TanzH1225/GrowTech-Wall-Handover/CAD library/README.md

# CAD library

The native CAD is included in this checkout. Keep these folders together:

- [Assembly](Assembly/): open [GTW003C.SLDASM](Assembly/GTW003C.SLDASM) for the full system.
- [FAB](FAB/): fabrication parts, print exports and electrical-box mounts/covers.
- [Standard](Standard/): standard and purchased components.

Use the [mechanical catalogue](../documentation/Mechanical%20catalog/Mechanical-CAD-Review.html) for previews, functions, materials and suppliers. The original `GTW003C.zip` is excluded from Git because its native contents are already arranged here.
