TanzH1225/GrowTech-Wall-Handover/documentation/programming/README.md

# Programming references

Start with [Current source selection and startup](Source-selection-and-startup.html), then [Programming handbook](PROGRAMMING-HANDBOOK.html).

- [01 system and code map](01-system-and-code-map.html)
- [02 pi application](02-pi-application.html)
- [03 communications](03-communications.html)
- [04 controller firmware](04-controller-firmware.html)
- [05 vision and assets](05-vision-and-assets.html)
- [06 development testing and recovery](06-development-testing-and-recovery.html)
- [07 maintenance and open issues](07-maintenance-and-open-issues.html)
- [08 evidence and change record](08-evidence-and-change-record.html)
- [09 hiwonder arm controller](09-hiwonder-arm-controller.html)

[Project report and asset context](10-reference-context-and-assets.html)
