TanzH1225/GrowTech-Wall-Handover/documentation/GrowTech-Wall-Electrical-RevJ.pdf

# GROWTECH WALL

# Connected power and control overview

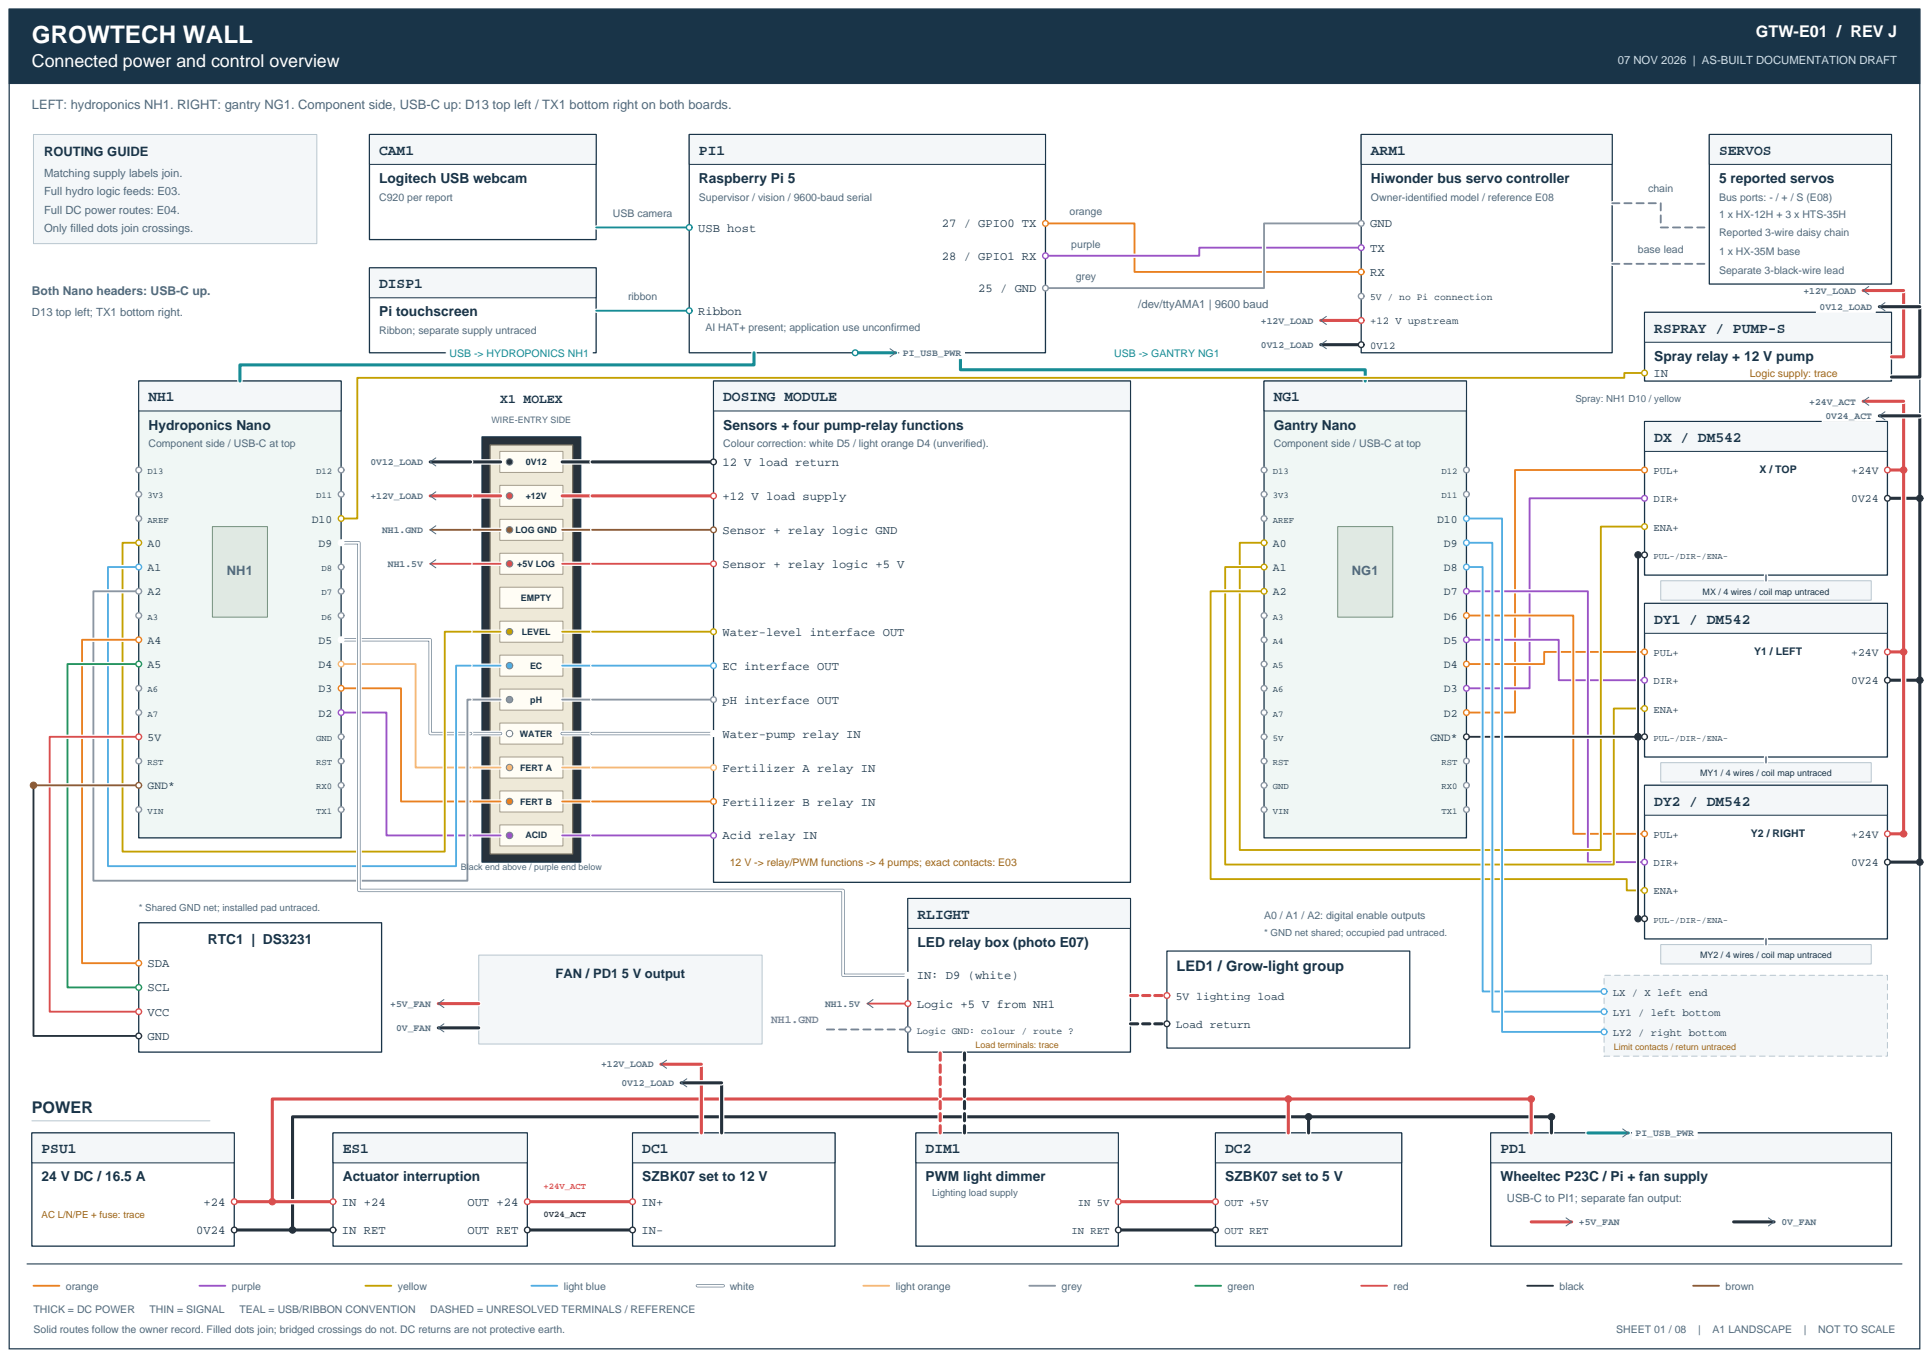
[picture p27: page 1]

07 NOV 2026 | AS-BUILT DOCUMENTATION DRAFT

LEFT: hydroponics NH1. RIGHT: gantry NG1. Component side, USB-C up: D13 top left / TX1 bottom right on both boards.

ROUTING GUIDE
Matching supply labels join.
Full hydro logic feeds: E03.
Full DC power routes: E04.
Only filled dots join crossings.

Raspberry Pi 5
Supervisor / vision / 9600-baud serial

ARM1
Hiwonder bus servo controller
Owner-identified model / reference E08

SERVOS
5 reported servos
Bus ports: - / + / S (E08)
1 x HX-12H + 3 x HTS-35H
Reported 3-wire daisy chain
1 x HX-35M base
Separate 3-black-wire lead

DISP1
Pi touchscreen
Ribbon; separate supply untraced

Both Nano headers: USB-C up.
D13 top left; TX1 bottom right.

Ribbon
AI HAT+ present; application use unconfirmed

Hydroponics Nano
Component side / USB-C at top

DOSING MODULE
Sensors + four pump-relay functions
Colour correction: white D5 / light orange D4 (unverified).
12 V load return

Gantry Nano

Sensor + relay logic GND

MX / 4 wires / coil map untraced

Water-level interface OUT

Water-pump relay IN

MY1 / 4 wires / coil map untraced

A0 / A1 / A2: digital enable outputs
* GND net shared; occupied pad untraced.

LED relay box (photo E07)

MY2 / 4 wires / coil map untraced

LX / X left end
LY1 / left bottom
LY2 / right bottom
Limit contacts / return untraced

Logic GND: colour / route ?

Wheeltec P23C / Pi + fan supply
USB-C to PI1; separate fan output:

AC L/N/PE + fuse: trace

THICK = DC POWER THIN = SIGNAL TEAL = USB/RIBBON CONVENTION DASHED = UNRESOLVED TERMINALS / REFERENCE

# Gantry motion, driver signals and limits

## GTW-E02 / REV J

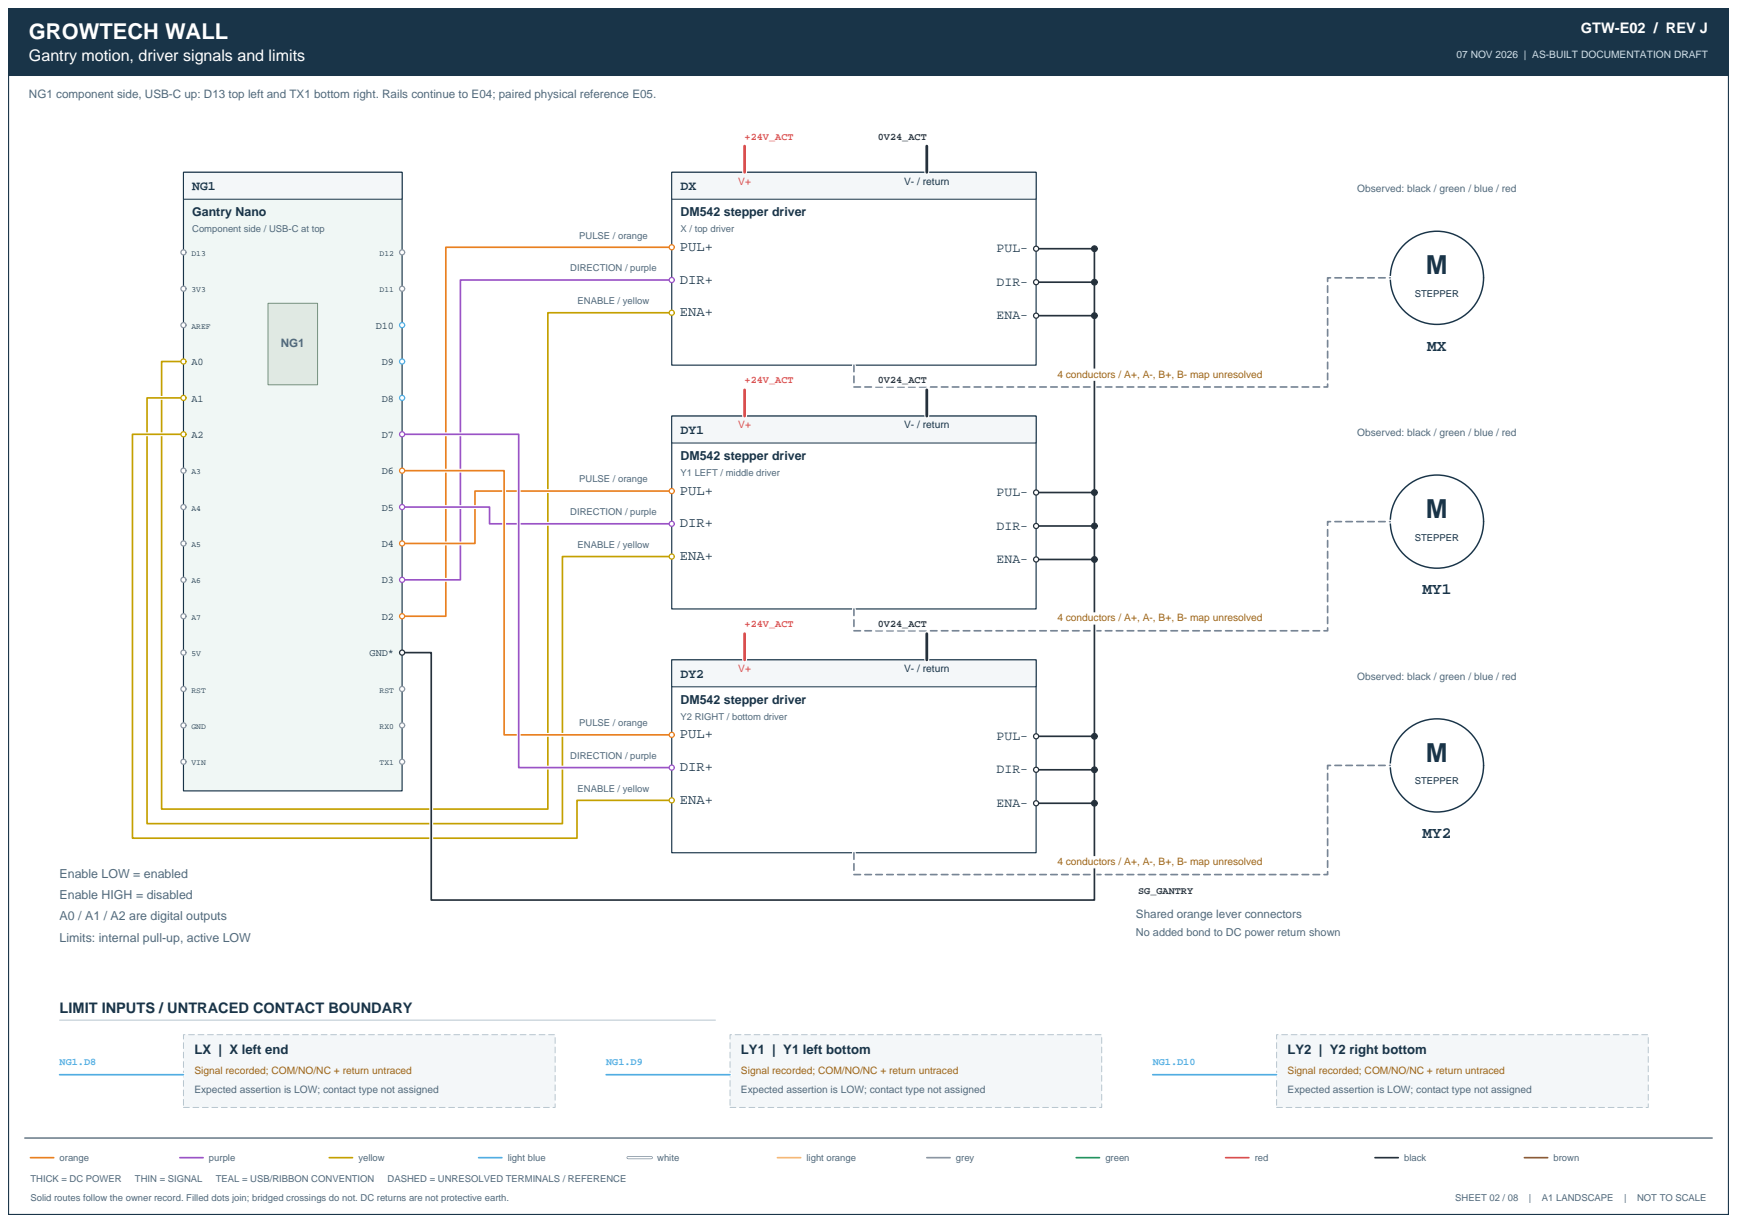
[picture p28: page 2]

NG1 component side, USB-C up: D13 top left and TX1 bottom right. Rails continue to E04; paired physical reference E05.

Gantry Nano
Component side / USB-C at top

Observed: black / green / blue / red

Enable LOW = enabled
Enable HIGH = disabled
A0 / A1 / A2 are digital outputs
Limits: internal pull-up, active LOW

SG_GANTRY
Shared orange lever connectors
No added bond to DC power return shown

LIMIT INPUTS / UNTRACED CONTACT BOUNDARY

Signal recorded; COM/NO/NC + return untraced
Expected assertion is LOW; contact type not assigned

# Molex wire-entry layout and hydroponics connections

## GTW-E03 / REV J

NH1: component side, USB-C up, real two-header pin order. Molex: photographed wire-entry order. Crossovers without dots are not joins.

Solid routes follow the owner record. Filled dots join; bridged crossings do not. DC returns are not protective earth. | SHEET 03 / 08 | A1 LANDSCAPE | NOT TO SCALE

NH1

## Hydroponics Nano

Component side / USB-C at top

D13

3V3

AREF

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
GND*

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
# X1 / MOLEX HARNESS

WIRE-ENTRY SIDE / BLACK END ABOVE

0V12

+12V

## LOG GND

## +5V LOG

## EMPTY

## LEVEL

EC

pH

## WATER

## FERT A

## FERT B

## ACID

### DOSING MODULE

## Sensor interfaces and four pump-relay functions

DC1 0V12 | Adopted D5 white / D4 light orange correction; physical continuity pending.
black / thick

### Load return / 0V12 distribution

DC1 +12V
red / thick

### +12 V load distribution to four pump paths

brown / thin

### Common sensor + RDOSE logic ground

red / thin

### Sensor + RDOSE logic +5 V supply

## NO WIRE

yellow

### Water-level interface analog OUT

light blue

### EC interface analog OUT

grey

### pH interface analog OUT

white

### Main water-pump relay IN / ON = LOW

light orange

### Fertilizer A relay IN / ON = HIGH

orange

### Fertilizer B relay IN / ON = HIGH

purple

### Acid relay IN / ON = HIGH

Both Nanos receive power over USB. A0 / A1 / A2 are analog inputs. * GND pads share a net; the occupied pad is untraced (E05).

The housing is shown from the wire-entry side; the mating face mirrors the row. Black heat-shrink in the photo is not treated as the conductor insulation colour. Exact sensor terminals and relay COM/NO/NC assignments remain untraced.

DIRECT FROM NH1: RTC1 on A4/SDA orange + A5/SCL green, with 5V red / GND black.
RLIGHT: D9 white, VCC from NH1 5V, logic-GND colour unresolved. RSPRAY: D10 yellow; logic supply / reference untraced.

## Fertilizer A / 12 V

### Kamoer peristaltic

Relay/load terminals to trace

M

+12V / 0V12 from X1

## Water pump / 12 V

### Rotary PWM + relay route

Relay/load terminals to trace

M

+12V / 0V12 from X1

## Fertilizer B / 12 V

### Kamoer peristaltic

Relay/load terminals to trace

M

+12V / 0V12 from X1

## Acid pump / 12 V

### Kamoer peristaltic

Relay/load terminals to trace

M

+12V / 0V12 from X1

# Power distribution, lighting and arm-box branches

## GTW-E04 / REV J

Supply and corresponding returns are paired. No unverified DC ground bond, protective-earth bond, fuse value or relay contact assignment is added.

Solid routes follow the owner record. Filled dots join; bridged crossings do not. DC returns are not protective earth. | SHEET 04 / 08 | A1 LANDSCAPE | NOT TO SCALE

### AC INPUT

## UK fused three-pin plug

Wall socket is normal main switch

### L / N / PE terminal map: trace Fuse rating / cable size: unknown

AC input

### PSU1

## 24 V x 16.5 A

396 W nominal output / report
+24 V

0V24

+24V_RAW

0V24_RAW

PD1

## Wheeltec P23C

Raw 24 V to Pi / fan supply

IN+ | IN return | DC2

## SZBK07 set to 5 V

Raw 24 V lighting load supply

IN+ | IN return | ES1

## Actuator interruption

Exact switched conductor(s): trace

IN+ | IN return

### ES1 REMOVES THE ACTUATOR BRANCH

Owner reports immediate vertical gantry descent on actuator-power removal. The Pi, both USB-powered Nanos, sensors and lighting remain powered. Twist release restores power; owner then uses GUI Reset for communications.

PI1

## Raspberry Pi 5

USB-C power input

PD1 USB-C -> PI1 / power only

### Reported output 5 V / 5 A

### FAN

## Enclosure fan load(s)

Quantity / header numbers not traced

### PD1 +5 V / matching return

PI1 USB host -> NG1 USB-C: power + data + ground. PI1 USB host -> NH1 USB-C: power + data + ground. PI1 USB host -> CAM1: camera data + USB power.
No additional VIN / 5V feed is recorded into either Nano.

### DIM1

## Grow-light PWM dimmer

Input / output terminals unresolved

+5V_LIGHT_LOAD

0V5_LIGHT_RETURN

### RLIGHT

## Lighting relay / control box

Load-side terminations unresolved

Known functional pair; switched side ?

### LED1

## Grow-light load group

Individual strip interconnect: trace NH1.5V -> VCC

NH1.5V

NH1.D9 -> IN (ON LOW)

NH1.D9

NH1.GND -> logic GND ?

NH1.GND

LED LOAD POWER IS FROM DC2. NH1 5V SUPPLIES RELAY LOGIC ONLY.

### ACTUATOR DISTRIBUTION

## Generic quick-connector block

+24V_ACT / 0V24_ACT -> DX / DY1 / DY2
Owner: 2-to-8 connector; exact terminal map unassigned

DC1

## SZBK07 set to 12 V

Input from actuator distribution

MOLEX +12V

MOLEX 0V12

## ARM-BOX 12 V BRANCH

Distribution -> Hiwonder ARM1 + spray load circuit.
ARM1 local switch effect on spray is unknown.
ARM1 input: 6-12 V rated; installed servo rail unmeasured.

# Physical header positions and connector identification

## GTW-E05 / REV J

Nano component side, USB-C at top. Nano footprint is a reference matching the owner count; verify the actual clone silkscreen before rewiring.

Solid routes follow the owner record. Filled dots join; bridged crossings do not. DC returns are not protective earth. | SHEET 05 / 08 | A1 LANDSCAPE | NOT TO SCALE

### BOTH NANOS: USB-C UP / D13 TOP LEFT / TX1 BOTTOM RIGHT

NH1 / HYDROPONICS | NG1 / GANTRY | PI1 / 40-PIN HEADER

### USB-C

NG1

MCU

- D13
- 3V3
- AREF
DX ENA+ | A0
DY1 ENA+ | A1
DY2 ENA+ | A2
- A3
- A4
- A5
- A6
- A7
- 5V
- RST
- GND
- VIN
D12 | -
D11 | -
D10 | LY2 signal
D9 | LY1 signal
D8 | LX signal
D7 | DY2 DIR+
D6 | DY2 PUL+
D5 | DY1 DIR+
D4 | DY1 PUL+
D3 | DX DIR+
D2 | DX PUL+
GND | SG_GANTRY*
RST | -
RX0 | -
TX1 | -

COMPONENT SIDE

### USB-C

NH1

MCU

- D13
- 3V3
- AREF
Level signal | A0
EC signal | A1
pH signal | A2
- A3
RTC1 SDA | A4
RTC1 SCL | A5
- A6
- A7
Logic +5V* | 5V
- RST
Logic GND* | GND
- VIN
D12 | -
D11 | -
D10 | RSPRAY IN
D9 | RLIGHT IN
D8 | -
D7 | -
D6 | -
D5 | Water relay IN
D4 | Fert A relay IN
D3 | Fert B relay IN
D2 | Acid relay IN
GND | -
RST | -
RX0 | -
TX1 | -

COMPONENT SIDE

* GND pins share the same board net. The occupied header pad is untraced.
The drawing pin names are electrical identifiers; unlabelled pins have no recorded wire. The USB-C-equipped clones are not identified as official Arduino A000005 hardware.

* NH1 5V -> X1.+5V, RTC1 VCC and RLIGHT VCC.
X1.GND is brown; RTC1 return is black; RLIGHT return colour is unknown. Both on-board GND pads are equivalent; the specific installed pad is untraced. D5 white / D4 light orange: adopted colour correction, unverified.
3V3 | 1 | 2 | 5V
GPIO2 | 3 | 4 | 5V
GPIO3 | 5 | 6 | GND
GPIO4 | 7 | 8 | GPIO14
GND | 9 | 10 | GPIO15
GPIO17 | 11 | 12 | GPIO18
GPIO27 | 13 | 14 | GND
GPIO22 | 15 | 16 | GPIO23
3V3 | 17 | 18 | GPIO24
GPIO10 | 19 | 20 | GND
GPIO9 | 21 | 22 | GPIO25
GPIO11 | 23 | 24 | GPIO8
GND | 25 | 26 | GPIO7
GPIO0 | 27 | 28 | GPIO1
GPIO5 | 29 | 30 | GND
GPIO6 | 31 | 32 | GPIO12
GPIO13 | 33 | 34 | GND
GPIO19 | 35 | 36 | GPIO16
GPIO26 | 37 | 38 | GPIO20
GND | 39 | 40 | GPIO21

Mating header view / pin 1 at upper left

25 GND | -> ARM1 GND | grey
27 GPIO0 TX -> ARM1 RX | orange
28 GPIO1 RX <- ARM1 TX | purple

UART1 alternate function supported by RP1. Owner port: /dev/ttyAMA1 at 9600 baud.
Pi logic is 3.3 V; ARM1 TX voltage unverified.

## X1 / MOLEX WIRE-ENTRY SEQUENCE (BLACK END LEFT, PURPLE END RIGHT)

0V12 | +12V | LOG GND | +5V LOG | EMPTY | LEVEL | EC | pH | WATER | FERT A | FERT B | ACID

Same single row as E03, rotated for readability. Photo E07 anchors the wire-entry view; use function labels on this side.

# Connection schedule, evidence limits and verification register

## GTW-E06 / REV J

Use this sheet with E01-E05. The separate CSV contains the complete recorded connection schedule and endpoint names.

Solid routes follow the owner record. Filled dots join; bridged crossings do not. DC returns are not protective earth. | SHEET 06 / 08 | A1 LANDSCAPE | NOT TO SCALE

## SIGNAL SCHEDULE / DIRECT LINKS

SOURCE | DESTINATION | WIRE / FUNCTION
PI1 USB host | NG1 USB-C | Power + data + GND / gantry
PI1 USB host | NH1 USB-C | Power + data + GND / hydroponics
PI1 USB host | CAM1 USB | Camera data + USB power
PI1 ribbon | DISP1 | Ribbon link / power route untraced
PI1 pin 27 / GPIO0 TX | ARM1 RX | Orange / UART1
PI1 pin 28 / GPIO1 RX | ARM1 TX | Purple / UART1
PI1 pin 25 | ARM1 GND | Grey / UART reference
NH1 A4 / SDA | RTC1 SDA | Orange / I2C
NH1 A5 / SCL | RTC1 SCL | Green / I2C
NH1 5V / GND | RTC1 VCC / GND | Red / black
NH1 5V | RLIGHT VCC | Red supply callout / latest correction
NH1 D9 | RLIGHT IN | White / firmware ON LOW
NH1 GND | RLIGHT logic GND | Return colour + termination unresolved
NH1 D10 | RSPRAY IN | Yellow / firmware ON HIGH

## TERMINAL VERIFICATION REGISTER

## V01 AC INPUT / EARTH

PSU model; L/N/PE; plug fuse; cable size; protective-earth path.

## V02 ES1 POWER INTERRUPTION

Identify switched conductor(s), poles and actual contact terminals.

## V03 DM542 / MOTORS

Match installed variant, coil pairs, A+/A-/B+/B- and DIP orientation.

## V04 LIMIT SWITCHES

Identify actual signal contact, COM/NO/NC selection and return route.

## V05 X1 CONNECTOR

D5 white / D4 light orange is an adopted hypothesis; confirm continuity and mating orientation.

## V06 DOSING CONTACTS / PWM

Trace relay load contacts and main-pump PWM terminal sequence.

## V07 LIGHTING LOAD / LOGIC

Trace DIM1 / RLIGHT contacts, return switching and logic-GND wire.

## V08 ARM UART / SERVOS

Hiwonder controller identified; verify TX level, servo rail, occupied sockets, IDs and chain order.

## V09 SPRAY SWITCHING

Identify logic VCC / GND and pump contact path; switch interaction.

## V10 SENSOR / PERIPHERAL DETAILS

Sensor interface models; fan terminals / count; touchscreen power.

### HOW TO READ THIS SET

A filled junction dot joins conductors; crossings with white bridges are not joins.
Dashed boundaries retain known functional routes without inventing hidden terminals.
Every repeated net name on a detail sheet identifies the same electrical net.
Power-return and signal-ground names remain distinct unless the supplied evidence joins them. No fresh hardware continuity tests or live firmware checks were performed.

### DRAWING BASIS

Primary evidence: attached GrowTech-Wall-Schematic-Drawing-Brief.md (03 Nov 2026).
New owner photos: LED relay box, single-row Molex connector and robotic arm control box.
Rev J: ARM1 identified as Hiwonder Serial Bus Servo Controller; physical reference added on E08. External box identities confirmed by owner; obscured internal terminals remain unresolved. MANUFACTURER REFERENCE CHECKS
[1] Arduino Nano full pinout, A000005, p.1: standard 30-pin signal-name order.
https://docs.arduino.cc/resources/pinouts/A000005-full-pinout.pdf
[2] Raspberry Pi RP1 Peripherals, Table 4, printed p.15: GPIO0/1 UART1 TX/RX. https://datasheets.raspberrypi.com/rp1/rp1-peripherals.pdf
[3] Raspberry Pi hardware / configuration documentation: header numbering; 3.3 V UART. https://www.raspberrypi.com/documentation/computers/raspberry-pi.html

References establish pin capabilities, not hidden wiring on this prototype. Hiwonder controller references and photo pin order: E08.

# Photo-matched field components and connector reference

## GTW-E07 / REV J

Owner identifications: first photo = LED relay box; second = Molex connector; third = robotic arm control box. Photos are reference evidence.

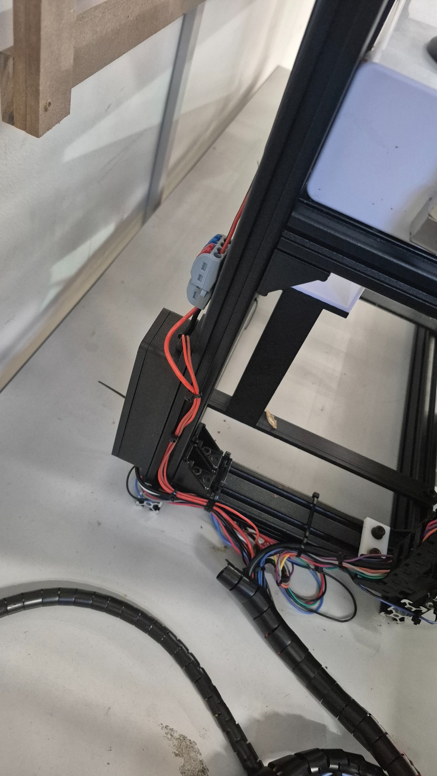
[picture p29: figure]
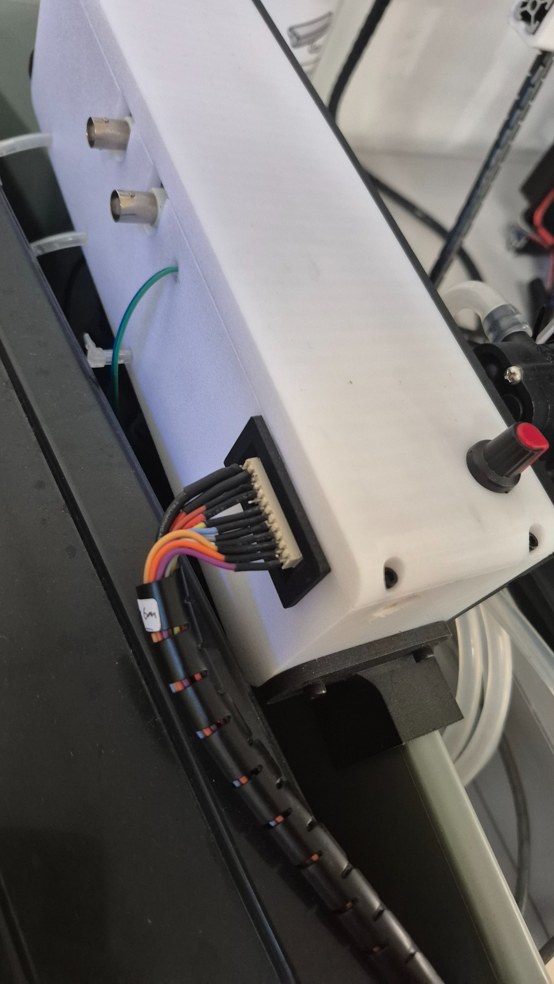
[picture p30: figure]
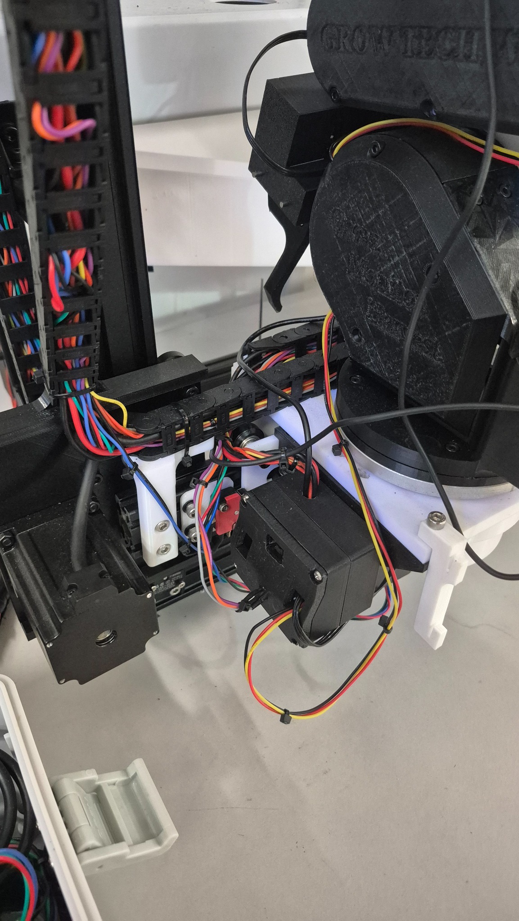
[picture p31: figure]
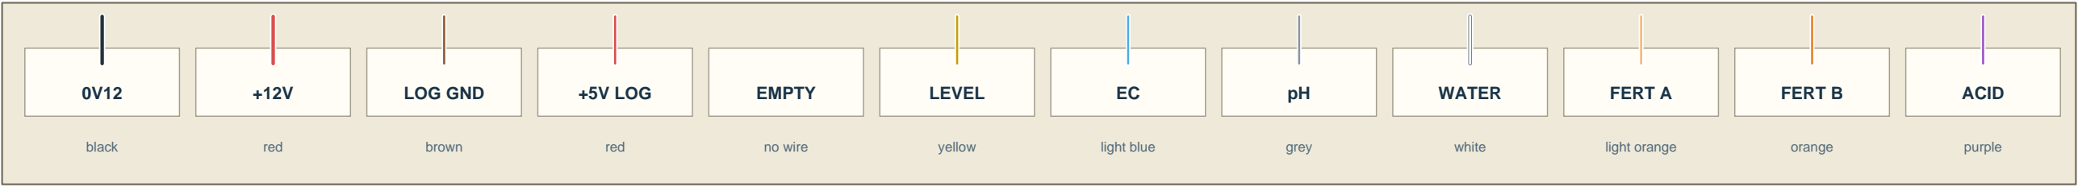
[picture p32: figure]
black; red; LOG GND; brown; +5V LOG; EMPTY; no wire; LEVEL; yellow; light blue; grey; WATER; white; FERT A; light orange; FERT B; orange; ACID; purple

Solid routes follow the owner record. Filled dots join; bridged crossings do not. DC returns are not protective earth. | SHEET 07 / 08 | A1 LANDSCAPE | NOT TO SCALE

# LED RELAY BOX

Black enclosure mounted behind the frame. Load leads and control harness enter the box. Internal contacts / logic return remain obscured.

# MOLEX CONNECTOR

Single row of wire entries on the dosing box. Black return end -> purple acid-signal end. Heat-shrink covers parts of individual wires.

# ROBOTIC ARM CONTROL BOX

Black enclosure beside the arm base.
External red local switch and lead groups visible. ARM1 model identified separately; board view E08.

# MOLEX: SINGLE ROW, WIRE-ENTRY SIDE, ROTATED HORIZONTALLY FOR READING

Wire-entry view: black return end to purple acid end. White D5 / light orange D4 mapping is adopted provisionally.

# ARM1 identification and physical communication header

## GTW-E08 / REV J

Owner-identified Hiwonder Serial Bus Servo Controller. Component-side reference photo; micro-USB at top and power switch at bottom.

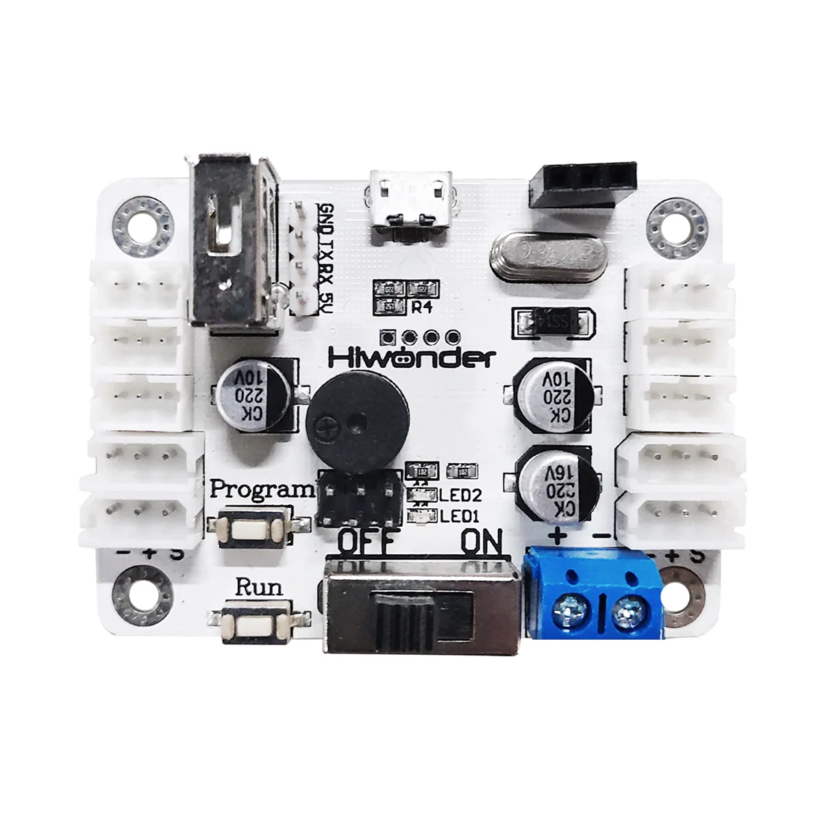
[picture p33: figure]
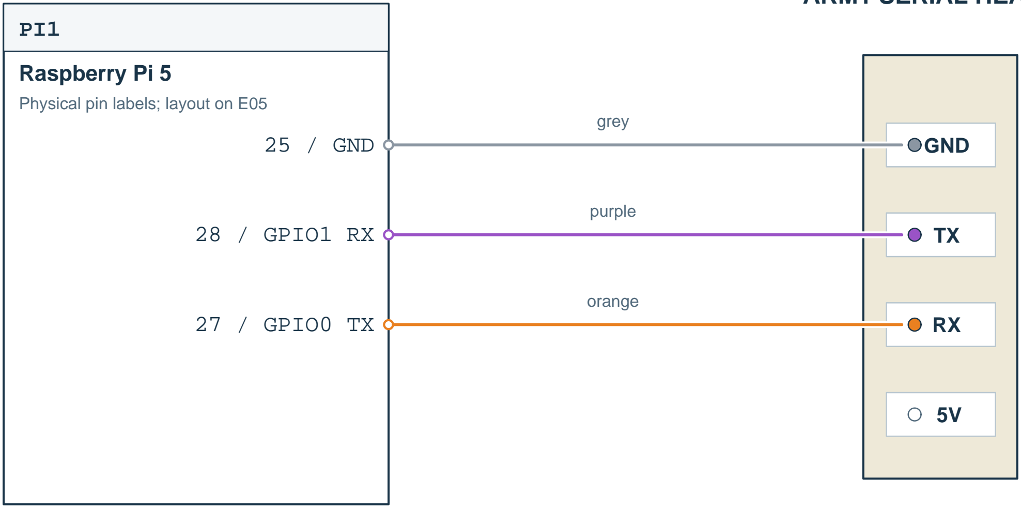
[picture p34: figure]
Raspberry Pi 5; Physical pin labels; layout on E05; 25 / GND; grey; 28 / GPIO1 RX; purple; 27 / GPIO0 TX; orange

Solid routes follow the owner record. Filled dots join; bridged crossings do not. DC returns are not protective earth. | SHEET 08 / 08 | A1 LANDSCAPE | NOT TO SCALE

## SUPPLIED BOARD REFERENCE / ARM1

The product photo identifies the board; it does not show the installed harness.

## UART CONNECTION / 9600 BAUD

## Serial header order in the supplied photo, from top to bottom:

GND / TX / RX / 5V. TX and RX are named from the controller perspective.

## ARM1 SERIAL HEADER

GND | UART reference
TX | Controller transmits to Pi RX
RX | Controller receives from Pi TX
5V | 5V auxiliary pin
| No connection to Pi in this set

The host UART is distinct from the three-wire servo bus.
Keep the recorded Pi GPIO0 / GPIO1 assignment; no GPIO remapping is implied.
Hiwonder documents a Raspberry Pi serial connection. Installed TX voltage has not been measured.

## MAIN POWER TERMINAL / PHOTO ORIENTATION

+ | -

### DC1 +12V_LOAD

### DC1 0V12_LOAD

Left screw = +; right screw = - in this view. Manufacturer input range: 6-12 V.
Recorded DC1 branch: 12 V.
Select supply voltage to suit the connected servos. This is separate from the serial-header 5V pin.

### SERVO CONNECTIONS / WHAT IS NOW IDENTIFIED

Visible three-pin port marking: - / + / S (signal), left to right in this component-side photo. The recorded four-servo chain and separate base lead remain unchanged.
Installed socket choice, servo-ID order and cable-contact mapping still require tracing.

## REFERENCES / OWNER IMAGE + HIWONDER DOCUMENTATION

[4] Product: Serial Bus Servo Controller, SKU 21090003. https://www.hiwonder.com/products/serial-bus-servo-controller
[5] Bus Servo Controller User Manual, sections 1.2.1-1.2.2.
[6] Bus Servo Controller Secondary Development, sections 2.1 and 2.5. Official manual and development URLs are included in the editable package. Reference pin capabilities do not establish hidden wiring inside the arm box.
