TanzH1225/GrowTech-Wall-Handover/documentation/Electrical catalog/media/01-connector-detail-embedded.jpg

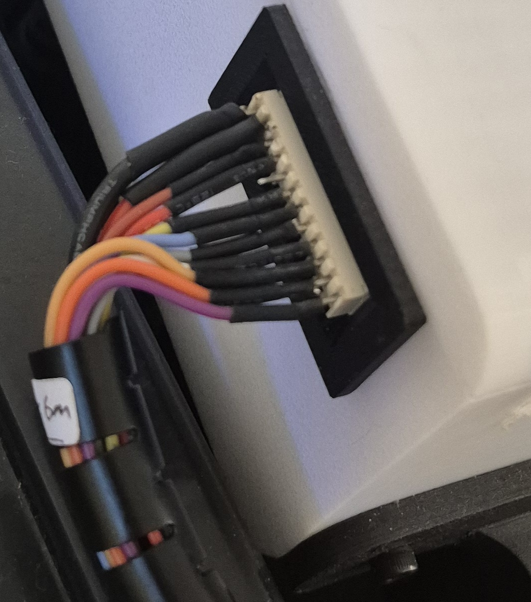
documentation/Electrical catalog/media/01-connector-detail-embedded.jpg
