TanzH1225/GrowTech-Wall-Handover/documentation/Electrical catalog/media/05-driver-terminal-detail-embedded.jpg

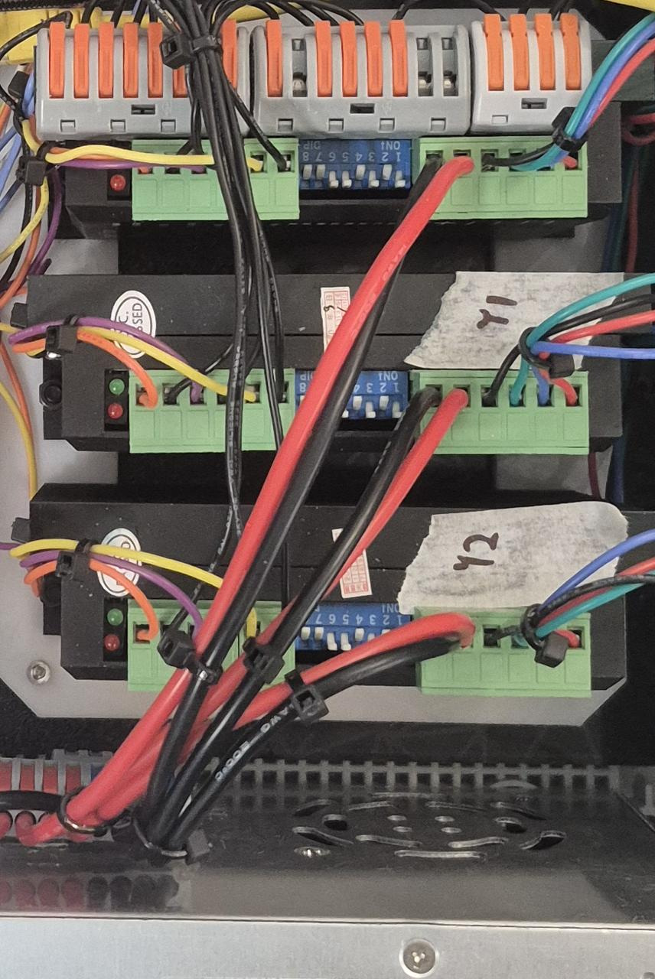
documentation/Electrical catalog/media/05-driver-terminal-detail-embedded.jpg
