TanzH1225/GrowTech-Wall-Handover/documentation/Electrical catalog/media/05-enclosure-interior-embedded.jpg

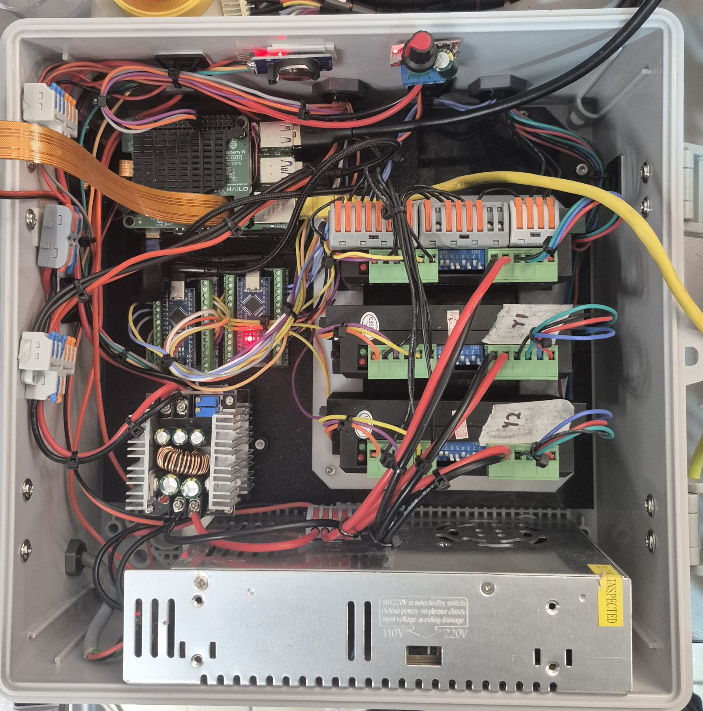
documentation/Electrical catalog/media/05-enclosure-interior-embedded.jpg
