TanzH1225/GrowTech-Wall-Handover/documentation/Electrical catalog/media/05-nano-detail.jpg

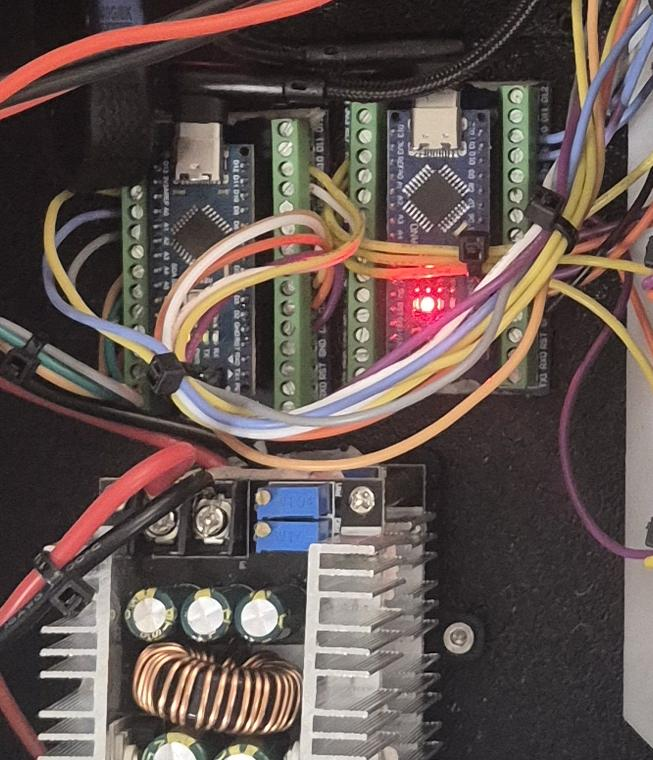
documentation/Electrical catalog/media/05-nano-detail.jpg
