TanzH1225/GrowTech-Wall-Handover/documentation/Electrical catalog/media/07-report-dosing-electronics.png

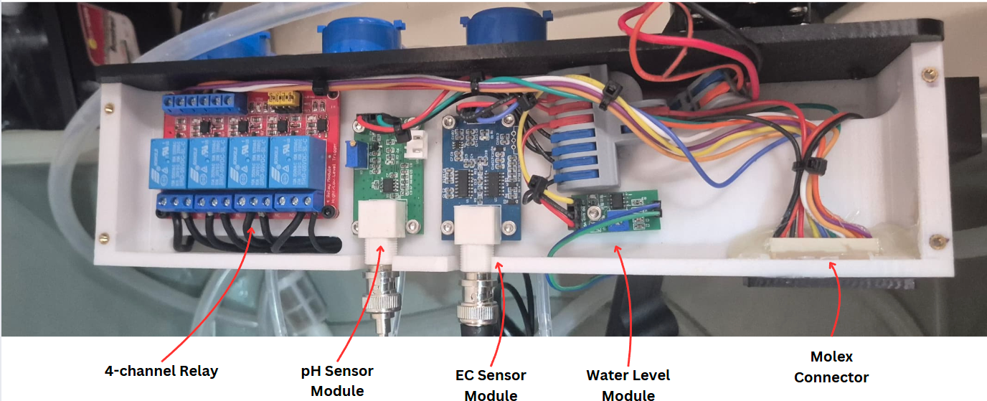
documentation/Electrical catalog/media/07-report-dosing-electronics.png
