TanzH1225/GrowTech-Wall-Handover/documentation/Electrical catalog/media/RevJ-E06.png

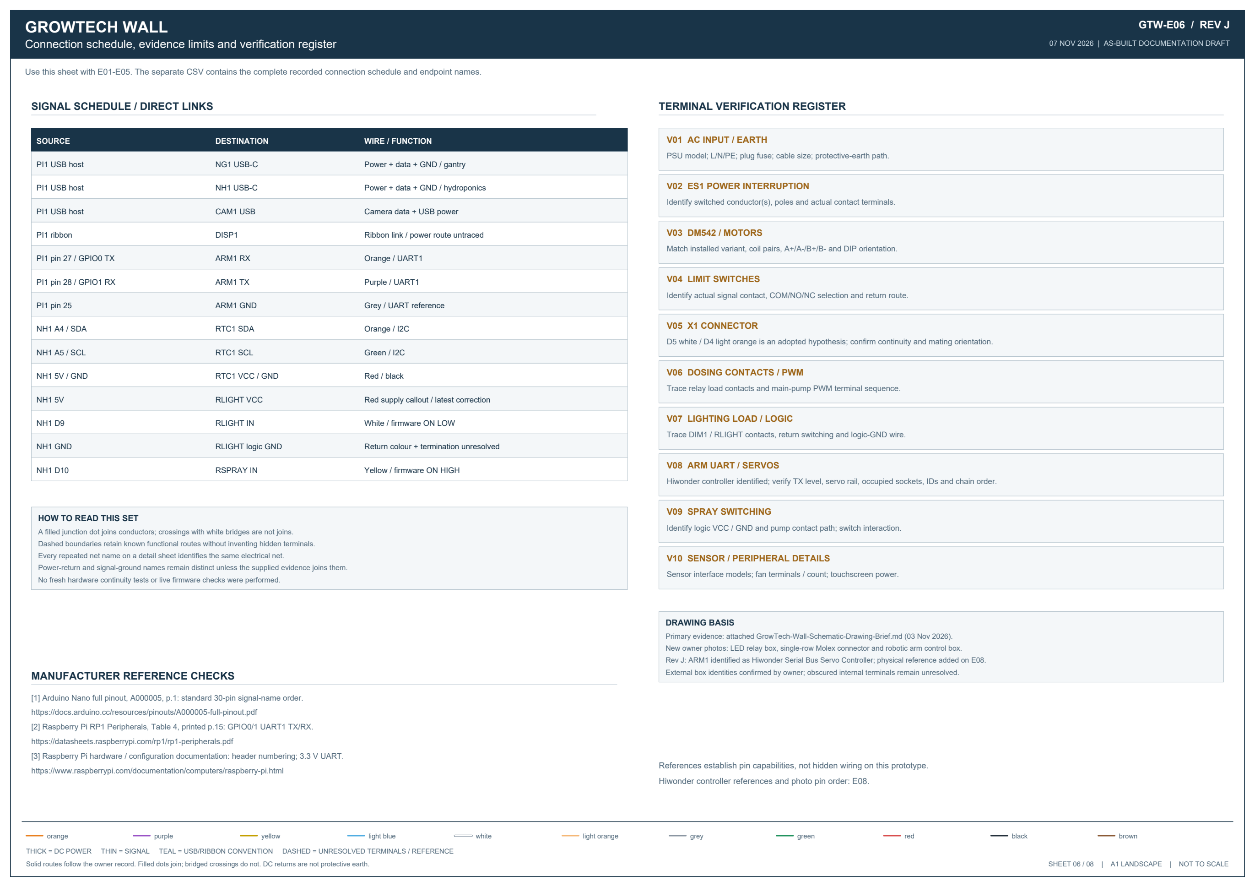
documentation/Electrical catalog/media/RevJ-E06.png
