TanzH1225/GrowTech-Wall-Handover/documentation/Manufacturer references/arduino-nano-pinout-reference.png

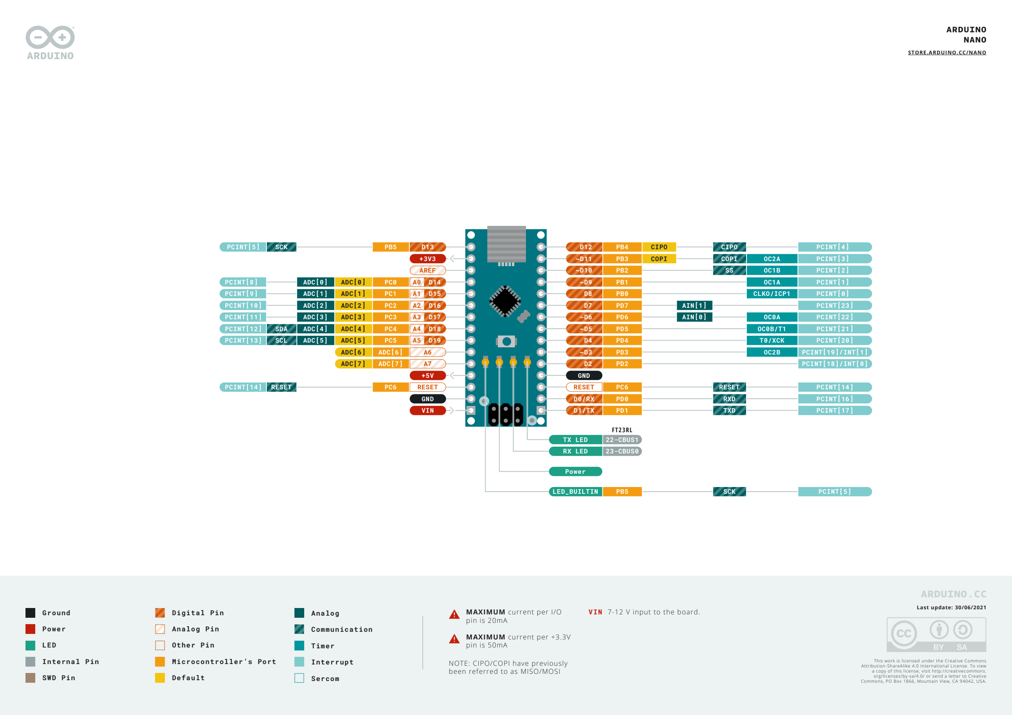
documentation/Manufacturer references/arduino-nano-pinout-reference.png
