TanzH1225/GrowTech-Wall-Handover/documentation/programming/media/dashboard.png

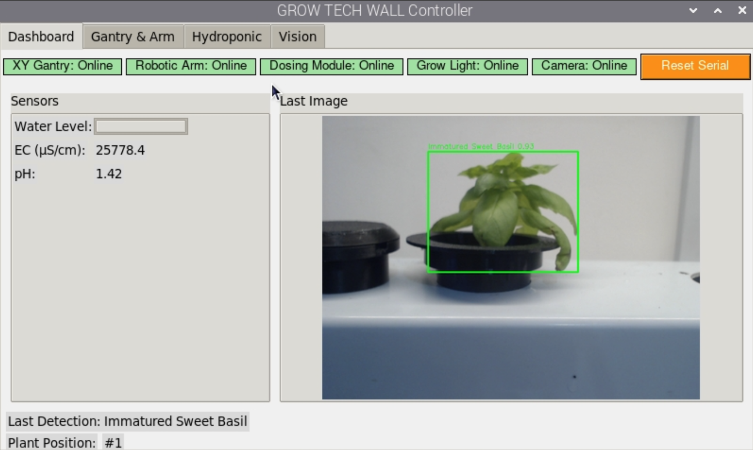
documentation/programming/media/dashboard.png
