TanzH1225/GrowTech-Wall-Handover/documentation/programming/media/example-detections.jpg

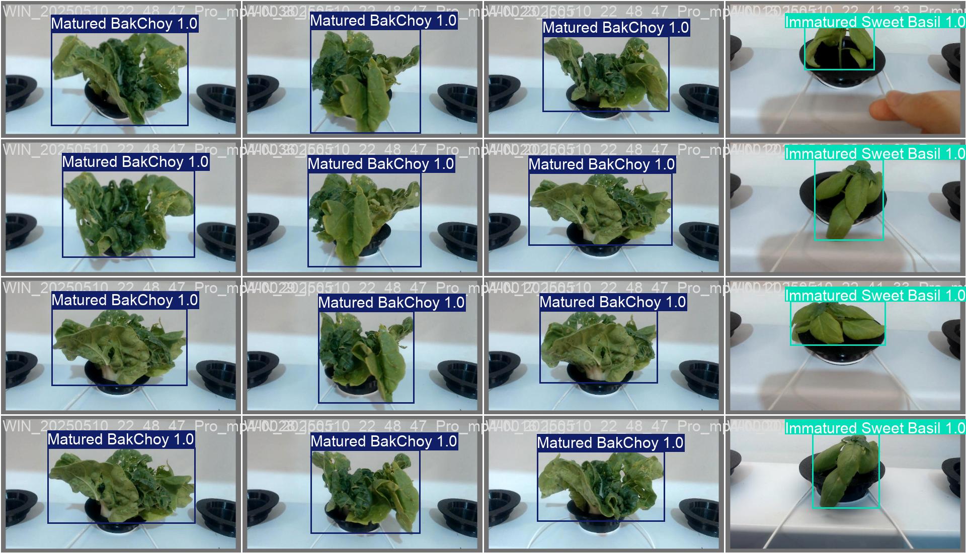
documentation/programming/media/example-detections.jpg
