TanzH1225/GrowTech-Wall-Handover/documentation/programming/media/gantry-arm-interface.png

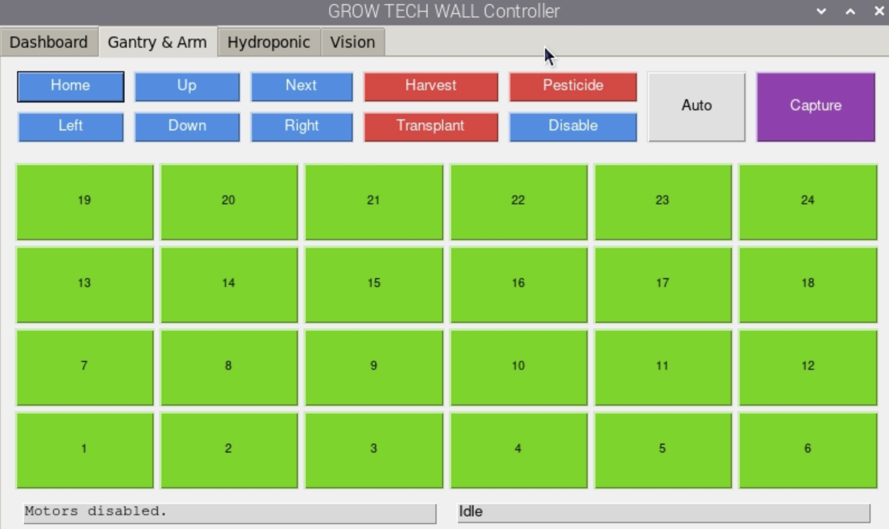
documentation/programming/media/gantry-arm-interface.png
