TanzH1225/GrowTech-Wall-Handover/documentation/programming/media/hydroponics-interface.png

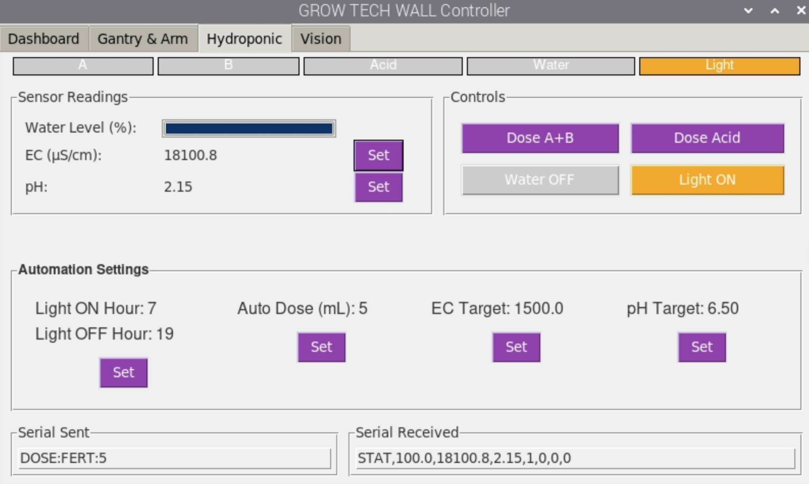
documentation/programming/media/hydroponics-interface.png
