TanzH1225/GrowTech-Wall-Handover/documentation/programming/media/vision-interface.png

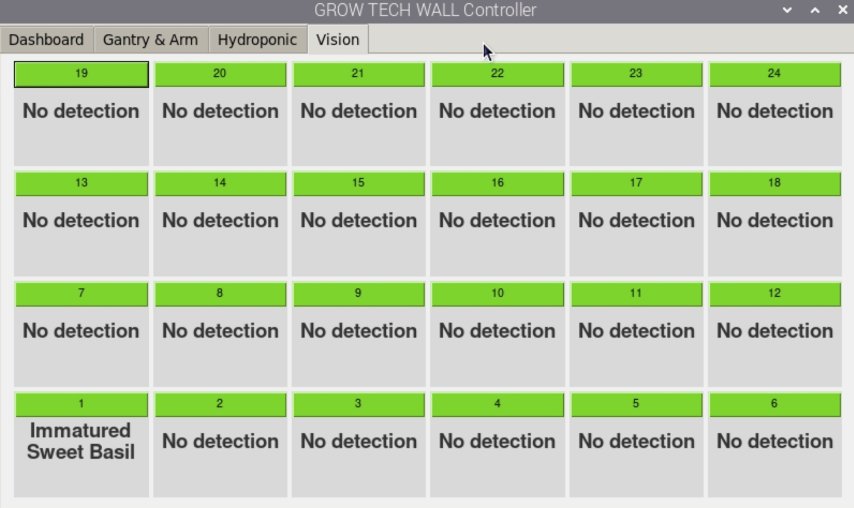
documentation/programming/media/vision-interface.png
