TanzH1225/GrowTech-Wall-Handover/documentation/reference/Pack and Go/pack-and-go-3.png

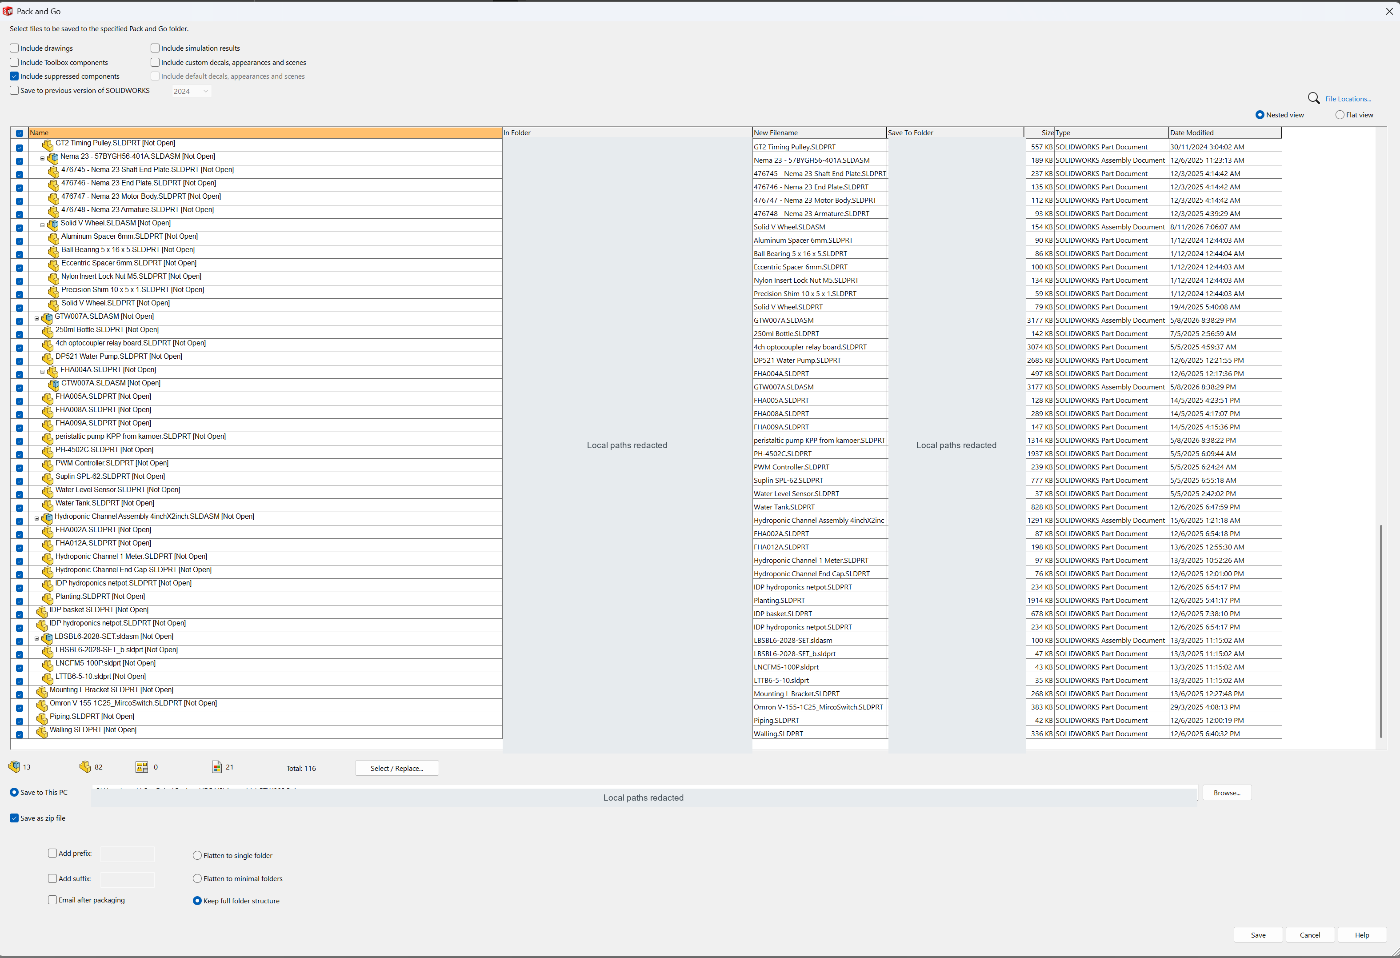
documentation/reference/Pack and Go/pack-and-go-3.png
