TanzH1225/GrowTech-Wall-Handover/documentation/GrowTech-Wall-BOM-Rechecked.xlsx

Sheet: BOM
GROWTECH WALL — BILL OF MATERIALS
Latest revisions. * Name inferred from CAD. Functions are CAD interpretations; see Assembly guide.
28 V-wheel bodies included. Unresolved included references: 0.
Gantry parts
No. | Part / CAD ref. | Description | Qty. | Material | Function / specification
1 | FGA001C | Gantry Plate Mirror | 2 | Acrylic (Medium-high impact) | Carries the gantry mounting and wheel interfaces.
2 | FGA002A | Gantry rail* | 1 | 5052-H34 | Long extruded member providing the linear guide path.
3 | FGA004A | X Limit Switch Plate | 3 | — | Positions the endstop switch relative to the moving carriage.
4 | FGA012A | X Plate1 | 2 | Acrylic (Medium-high impact) | Connects the X carriage drive and roller mounting points.
5 | FGA013B | Platform Truss | 2 | — | Braces the projecting arm platform against bending.
6 | FGA015B | Platform Support | 2 | — | Connects and supports the arm platform.
7 | FGA016A | 4.5mm Spacer | 8 | — | Maintains spacing in the gantry mounting stack.
8 | FGA017A | 9mm Spacer | 4 | — | Maintains spacing in the gantry mounting stack.
9 | FGA018A | 23mm Spacer | 2 | — | Maintains spacing in the gantry mounting stack.
10 | FGA019A | X Chain Bracket | 1 | — | Anchors the moving cable-chain connection.
11 | FGA021B | Basket Hook | 1 | — | Supports the collection basket on the moving structure.
12 | FGA022A | Basket Hook | 1 | — | Supports the collection basket on the moving structure.
13 | FGA023F | Damper | 2 | — | Two-hole mounting block; damping mechanism/material needs confirmation.
14 | FRAM001D | Aluminium Frame | 1 | 5052-H36 | Supports the growing channels and gantry structure.
Robotic arm parts
No. | Part / CAD ref. | Description | Qty. | Material | Function / specification
15 | FRA001C | Arm / platform mounting plate* | 2 | — | Interfaces the rotary arm base with its supporting platform; also used on the X assembly.
16 | FRA002B | Rotary base plate* | 1 | 6061 Alloy | Circular mounting interface for the arm base rotation.
17 | FRA003C | Arm joint housing* | 1 | — | Supports the first joint and its actuator interface.
18 | FRA004B | Arm link housing* | 1 | 6061 Alloy | Structural housing connecting adjacent arm joints.
19 | FRA005D | Arm 2 | 1 | — | Second arm link housing between joints.
20 | FRA010A | End-effector actuator housing* | 1 | 6061 Alloy | Carries the gripper actuator and rotary mounting interface.
21 | FRA013A | Gripper pinion* | 1 | — | Transfers actuator rotation into rack travel.
22 | FRA014A | Rack | 1 | — | Transfers pinion motion to one finger mounting interface.
23 | FRA015B | Rack | 1 | — | Transfers pinion motion to the opposing finger mounting interface.
24 | FRA017C | Gripper Finger A | 1 | — | One curved opposing finger connected to a gripper rack.
25 | FRA018C | Gripper Finger B | 1 | — | The opposing curved finger connected to the other gripper rack.
26 | FRA019A | Control Box | 2 | — | Small control enclosure with mounting/access openings.
Hydroponics parts
No. | Part / CAD ref. | Description | Qty. | Material | Function / specification
27 | FHA002A | Cup | 34 | — | Ring-shaped interface locating a plant cup in a channel opening.
28 | FHA003B | Slide V2 | 1 | — | Angled transfer chute with supporting rods; exact transfer sequence needs confirmation.
29 | FHA004A | Dosing Module | 1 | — | Housing for the tank-mounted dosing components.
30 | FHA005A | Tank mounting bracket* | 1 | — | Clips over an edge and provides a two-hole mounting interface.
31 | FHA008A | Bottle Holder | 1 | — | Retains the dosing bottles beside the tank.
32 | FHA009A | Sensors Holder | 1 | — | Positions cylindrical probes beside/in the tank.
33 | FHA012A | LID | 8 | — | Caps unused channel openings.
Standard components
No. | Part / CAD ref. | Description | Qty. | Material | Function / specification
34 | — | socket countersunk head screw | 4 | — | B18.3.5M - 4 x 0.7 x 12 Socket FCHS -- 12N
35 | — | socket countersunk head screw | 4 | — | B18.3.5M - 4 x 0.7 x 20 Socket FCHS -- 20N
36 | — | socket head cap screw | 4 | — | B18.3.1M - 4 x 0.7 x 30 Hex SHCS -- 30NHX
37 | — | socket head cap screw | 24 | — | B18.3.1M - 5 x 0.8 x 35 Hex SHCS -- 22NHX
38 | — | socket head cap screw | 7 | — | B18.3.1M - 5 x 0.8 x 40 Hex SHCS -- 22NHX
39 | — | socket head cap screw | 7 | — | B18.3.1M - 5 x 0.8 x 50 Hex SHCS -- 22NHX
40 | — | hex nut style 1 | 24 | — | B18.2.4.1M - Hex nut, Style 1, M5 x 0.8 --D-N
41 | — | 625 2RS Ball Bearing, ABEC 1. | 56 | Plain Carbon Steel | —
42 | — | Solid V-wheel body | 28 | Delrin 2700 NC010, Low Viscosity Acetal Copolymer (SS) | Rolling wheel body; bearings are listed separately.
43 | — | 250ml Bottle | 3 | — | —
44 | — | 3mmX80mm shaft | 2 | — | —
45 | — | 4ch optocoupler relay board | 1 | — | —
46 | — | 6mm pneumatic fittings | 1 | — | —
47 | — | Aluminium Round Spacer | 29 | 5052-H34 | —
48 | — | C920 Webcam | 1 | — | —
49 | — | DP521 Water Pump | 1 | PVC Rigid | —
50 | — | Electrical Panel Box | 1 | — | —
51 | — | GT2 Timing Pulley | 3 | 6063-T1 | —
52 | — | 240 Servo Motor HTS-35H | 3 | — | —
53 | — | 0 DS-LH8A stp(2) | 1 | — | —
54 | — | Hydroponic Channel 1 Meter | 4 | PVC Rigid | —
55 | — | Hydroponic Channel End Cap | 8 | PVC Rigid | —
56 | — | IDP basket | 1 | — | —
57 | — | IDP hydroponics netpot | 34 | — | —
58 | — | LBSBL6-2028-SET b | 96 | — | —
59 | — | LNCFM5-100P | 192 | — | —
60 | — | LTTB6-5-10 | 192 | — | —
61 | — | Lineare bearing LM3UU | 1 | — | LM6UU
62 | — | Mounting L Bracket | 1 | — | —
63 | — | 476745 - Nema 23 Shaft End Plate | 4 | 6061-T6 (SS) | —
64 | — | 476746 - Nema 23 End Plate | 4 | — | —
65 | — | 476747 - Nema 23 Motor Body | 4 | — | —
66 | — | 476748 - Nema 23 Armature | 4 | — | —
67 | — | Omron V-155-1C25 MircoSwitch | 3 | ABS | Défaut
68 | — | p BEARING, METRIC 600 MINIATURE SERIES, DOUBLE-SHIELDED 3mm ID × 9 OD × 3 W — 603-ZZ | 1 | AISI 316 Annealed Stainless Steel Bar (SS) | —
69 | — | peristaltic pump KPP from kamoer | 3 | — | —
70 | — | PH-4502C | 2 | — | —
71 | — | Piping | 3 | — | —
72 | — | Planting | 24 | — | —
73 | — | PWM Controller | 1 | — | —
74 | — | Quick Connector Spray Nozzle | 1 | — | —
75 | — | Round Servo Horn | 1 | — | —
76 | — | SERVO ARM HORN 25T ALUMINIUM | 4 | 6061 Alloy | —
77 | — | Suplin SPL-62 | 1 | ABS | —
78 | — | Thrust Bearing | 1 | — | —
79 | — | Inner | 1 | — | —
80 | — | Outer | 1 | — | —
81 | — | Walling | 1 | — | —
82 | — | Water Level Sensor | 1 | — | —
83 | — | Water pump 12v | 1 | — | —
84 | — | Water Tank | 1 | — | Défaut
Imported CAD bodies — not separate purchase items
No. | Part / CAD ref. | Description | Qty. | Material | Function / specification
85 | — | Imported servo CAD body 1 | 1 | — | —
86 | — | Imported servo CAD body 10 | 1 | — | —
87 | — | Imported servo CAD body 11 | 1 | — | —
88 | — | Imported servo CAD body 12 | 1 | — | —
89 | — | Imported servo CAD body 13 | 1 | — | —
90 | — | Imported servo CAD body 14 | 1 | — | —
91 | — | Imported servo CAD body 15 | 1 | — | —
92 | — | Imported servo CAD body 16 | 1 | — | —
93 | — | Imported servo CAD body 17 | 1 | — | —
94 | — | Imported servo CAD body 18 | 1 | — | —
95 | — | Imported servo CAD body 19 | 1 | — | —
96 | — | Imported servo CAD body 2 | 1 | — | —
97 | — | Imported servo CAD body 20 | 1 | — | —
98 | — | Imported servo CAD body 3 | 1 | — | —
99 | — | Imported servo CAD body 4 | 1 | — | —
100 | — | Imported servo CAD body 5 | 1 | — | —
101 | — | Imported servo CAD body 6 | 1 | — | —
102 | — | Imported servo CAD body 7 | 1 | — | —
103 | — | Imported servo CAD body 8 | 1 | — | —
104 | — | Imported servo CAD body 9 | 1 | — | —

Sheet: Assembly guide
GROWTECH WALL — ASSEMBLY GUIDE
Geometry and roles interpreted from individual SolidWorks views and assembly context, 9 Oct 2026.
Latest CAD ref. | Module | Mechanical role | Review boundary
GTW003C | Full system | Frame carries four growing channels. The gantry positions the arm in front of the plants, with a collection basket below and a tank alongside. | Overall spatial arrangement observed; working sequences are not proved by static CAD.
GTW001E | Robotic arm | Rotary base and joint/link housings carry the end effector from the gantry platform. | Configured CAD pose inspected; joint travel and actuator torque remain unverified.
GTW002B | Gantry | Carriage plates and V-wheels form the gantry rolling interfaces on the frame. | Corrected references rechecked; travel, preload and clearance still need physical confirmation.
GTW004A | Enclosure | Box and mounting panels contain the controller hardware alongside the frame. | Mechanical packaging inspected; electrical details deferred.
GTW005C | X-axis carriage / arm platform | Side plates, spacers and triangular braces support the arm mounting plate on the moving cross member. | 14 of 16 wheel assemblies appear displaced from the carriage; placement/mates require review.
GTW006B | End effector | An actuator housing and pinion/racks connect to opposing curved fingers. | Rack/finger arrangement observed; grip force and exact actuation require confirmation.
GTW007A | Tank and dosing module | Reservoir with mounted dosing housing, bottle holder and probe holder. | Mounting layout observed; pipe routes, flows and chemical assignments are not established by CAD.
Use | BOM is a fixed CAD snapshot. Assembly guide explains the module relationships.
Revision rule | A, B, C… are successive revisions. Highest available suffix chosen for each base part code.
Quantities | 104 part/configuration rows and 913 included leaf instances. Subassembly quantities must not be added to leaf quantities.
Descriptions | Stored CAD descriptions are retained. Asterisk marks a readable name inferred from inspected geometry. Function notes are interpretations, not owner-confirmed operating specifications.
Wheel/reference recheck | 28 wheel occurrences included; 0 excluded wheel references; 0 unresolved included references. 28 M5 lock nuts remain suppressed. Root load warning 1 means reference ID mismatch. Wheel files reference the OneDrive CAD folder; temporary imported bodies are not separate purchase items.
Audit evidence | Detailed system/subassembly rollups, separate GTW007A module BOM, original references and raw properties are retained in GrowTech-Wall-BOM-Audit-Rechecked.xlsx.
Visual evidence | outputs/gtw-cad-review contains model manifests, view captures and inspection results. CAD files were opened read-only and were not saved.
Source | IDP V2/Assembly/GTW003C.SLDASM; latest part revisions in IDP V2; resolved source JSON under docs/mechanical-handover.
Remaining confirmation | GTW005C: 14 wheel assemblies are displaced from the carriage in the inspected model. Confirm placement/mates, installed materials, purchase units and physical clearances.
