TanzH1225/GrowTech-Wall-Handover/documentation/Mechanical catalog/Catalogue-clarifications.xlsx

Mechanical catalogue clarifications
Fill the pale yellow answer column. Keep the item ID when replying here.
ID and part | Please confirm | Current information | Your answer
C01 EB001A | Which board/device mounts here, and was this printed or cut from sheet? Give material if known. | Electrical box perimeter frame; electrical box mounting part. | not used, remove from the cad library
C02 EB002A | Which board/device mounts here, and was this printed or cut from sheet? Give material if known. | Electrical box mounting backplate; electrical box mounting part. | The backplate of the electrical box, everything in the electrical box sit on it
C03 EB003A | Which board/device mounts here, and was this printed or cut from sheet? Give material if known. | Twin opening mounting plate; electrical box mounting part. | mounting plate for stepper motor driver onto the backplate
C04 EB004A | Which board/device mounts here, and was this printed or cut from sheet? Give material if known. | Rectangular mounting plate; electrical box mounting part. | moutning plate for rpi5 onto back plate
C05 EB005A | Which board/device mounts here, and was this printed or cut from sheet? Give material if known. | Tabbed mounting plate; electrical box mounting part. | moutning plate for the buck converters onto back plate
C06 EB006A | Which board/device mounts here, and was this printed or cut from sheet? Give material if known. | Slotted board carrier; electrical box mounting part. | this wrong name, this is the vent cover at the bottom of the electrical box
C07 EB007A | Which board/device mounts here, and was this printed or cut from sheet? Give material if known. | Access opening mounting plate; electrical box mounting part. | this is the back cover of the touchscreen
C08 FGA023A / FGA023F | Should FGA023F be added, or is FGA023A the intended current damper? | Current CAD has FGA023A. Mechanical handover and saved preview identify FGA023F. | Use FGA023A, the different version is just different length, there are basiaclly similar
C09 FGA017A | Is this part still needed? If yes, add the intended file or identify its replacement. | Mechanical handover lists a 9 mm spacer; no FGA017A native file is in the current handover CAD library. | need, I manual added back the part file into the cad librayr, just add in incase needed
C10 FGA001B and FGA001C | Are B and C interchangeable revisions, or are both required as opposing/mirrored plates? | Both files are included; the catalog defaults to C. Earlier assembly records use both B and C. | yes they are intended mirror version of each other each use in Y1 and Y2 axis
C11 FRA001B and FRA001C | Are both still required, or should B be replaced by C? | Both files are included; the catalog defaults to C. Earlier records use B at the arm and C at the platform. | final full assembly is c version, that mount onto the x gantry, but B version is a ordinary flat base for the arm for testing on the table top, so b version is good to keep just incase
C12 Lineare_bearing_LM3UU | Confirm the actual bearing model and shaft diameter. | Handover flags LM3UU filename versus LM6UU configuration. | shud be lm3uu cuz im using 3mm shaft
C13 Turntable Assembly / Inner / Outer | Were the rings printed/fabricated, or bought? Give material or supplier/model. | The handover describes the rings and bearing but gives no turntable supplier. | bought in shopee
C14 FGA016A and FGA018A | Which material was actually used for the 4.5 mm and 23 mm spacers? | The handover allows printed / aluminium spacers. | 3d printed in petg
C15 FHA003B | Is the chute itself printed or cut from PVC? Which material is used for its supports? | Handover lists printed / PVC. | is printed in section and glue together
C16 GTW001A | Is A a retained dependency, or can it be hidden from the newcomer catalog? No file will be deleted. | GTW001A is included with the current GTW001E; it is not promoted as the current arm overview. | use E version a can be hidden
