TanzH1225/GrowTech-Wall-Handover/CAD library/Standard/Hydroponic Channel/Hydroponic Channel Assembly 4inchX2inch.SLDASM

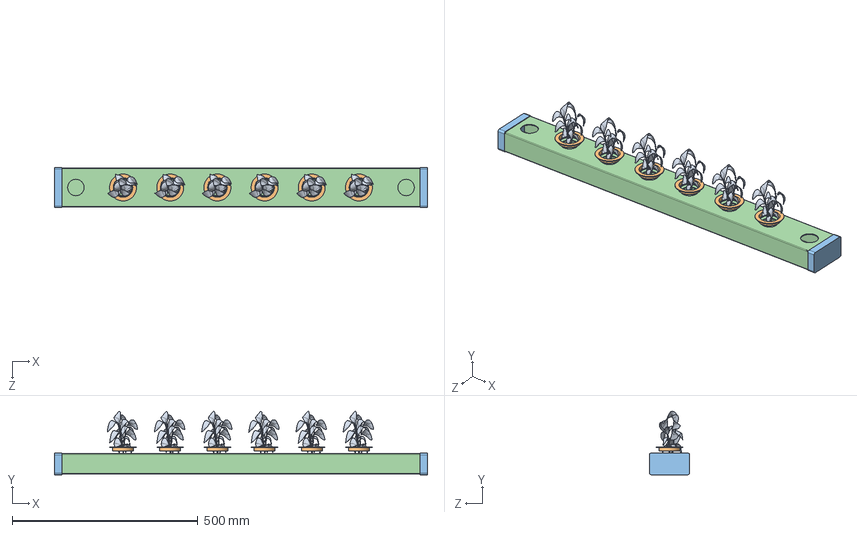
[picture p50: CAD file, 2026-11-08]
CAD library/Standard/Hydroponic Channel/Hydroponic Channel Assembly 4inchX2inch.SLDASM
1004.0 x 171.0 x 109.0 mm
Hydroponic Channel 1 Meter
Hydroponic Channel End Cap x 2
FHA002A x 6
Planting x 6
