TanzH1225/GrowTech-Wall-Handover/CAD library/Standard/SW2014 Parts Library 1.6/Assemblies/Wheels/Solid V Wheel.SLDASM

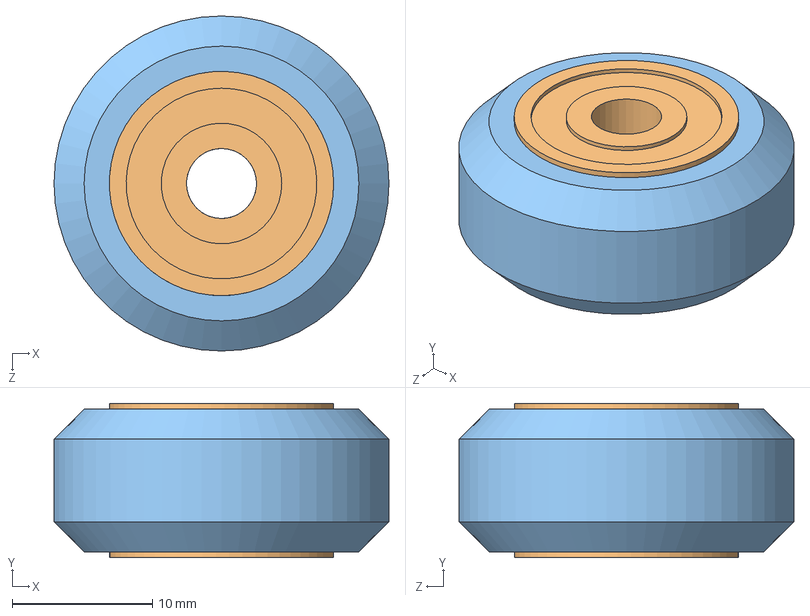
[picture p51: CAD file, 2026-11-08]
CAD library/Standard/SW2014 Parts Library 1.6/Assemblies/Wheels/Solid V Wheel.SLDASM
23.9 x 11.0 x 23.9 mm
Solid V Wheel
Ball Bearing 5 x 16 x 5 x 2
Precision Shim 10 x 5 x 1
