TanzH1225/GrowTech-Wall-Handover/CAD library/Standard/Turntable Assem/Turntable Assembly.SLDASM

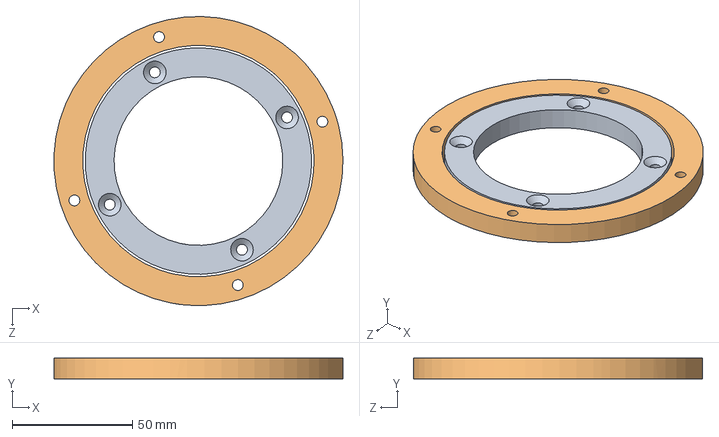
[picture p52: CAD file, 2026-11-08]
CAD library/Standard/Turntable Assem/Turntable Assembly.SLDASM
119.9 x 8.60 x 119.9 mm
Outer
Inner
