TanzH1225/GrowTech-Wall-Handover/CAD library/Assembly/GTW005C.SLDASM

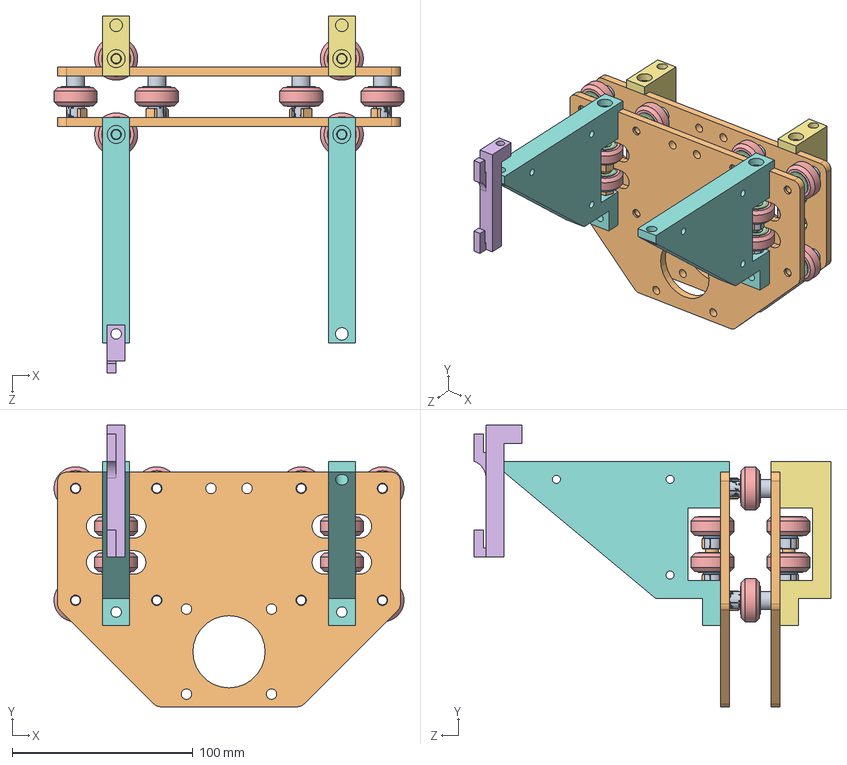
[picture p53: CAD file, 2026-11-08]
CAD library/Assembly/GTW005C.SLDASM
193.9 x 156.0 x 197.5 mm
FGA012A x 2
Aluminium Round Spacer x 16
FGA013B x 2
FGA015B x 2
FGA022A
Solid V Wheel x 16
Ball Bearing 5 x 16 x 5 x 32
Precision Shim 10 x 5 x 1 x 32
Eccentric Spacer 6mm x 16
Aluminum Spacer 6mm x 16
