TanzH1225/GrowTech-Wall-Handover/CAD library/FAB/Electronics Box EB/EB002A.SLDPRT

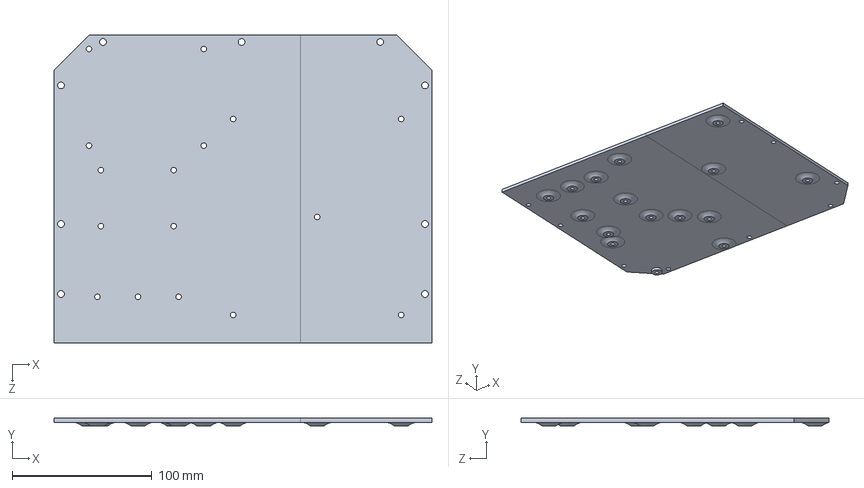
[picture p54: CAD file, 2026-11-08]
CAD library/FAB/Electronics Box EB/EB002A.SLDPRT
270.0 x 5.50 x 220.0 mm
