TanzH1225/GrowTech-Wall-Handover/CAD library/FAB/Electronics Box EB/STL/EB002A_2.stl

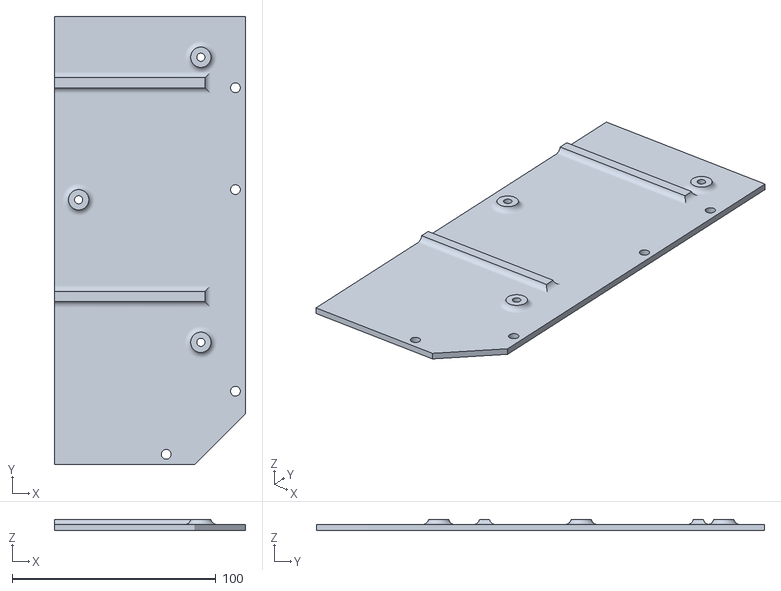
[picture p55: CAD file, 2026-11-08]
CAD library/FAB/Electronics Box EB/STL/EB002A_2.stl
93.9 x 220.0 x 5.50
