TanzH1225/GrowTech-Wall-Handover/CAD library/FAB/Gantry GA/FGA002A.SLDPRT

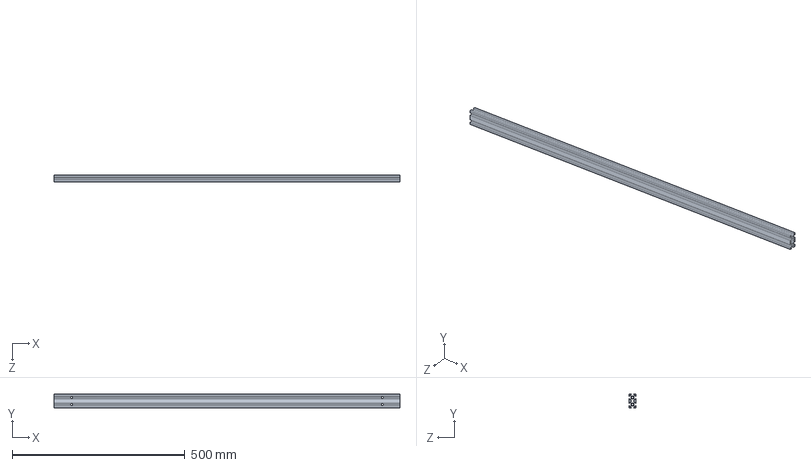
[picture p56: CAD file, 2026-11-08]
CAD library/FAB/Gantry GA/FGA002A.SLDPRT
1000.0 x 40.0 x 20.0 mm
