TanzH1225/GrowTech-Wall-Handover/CAD library/FAB/Hydroponics HA/FHA008A.SLDPRT

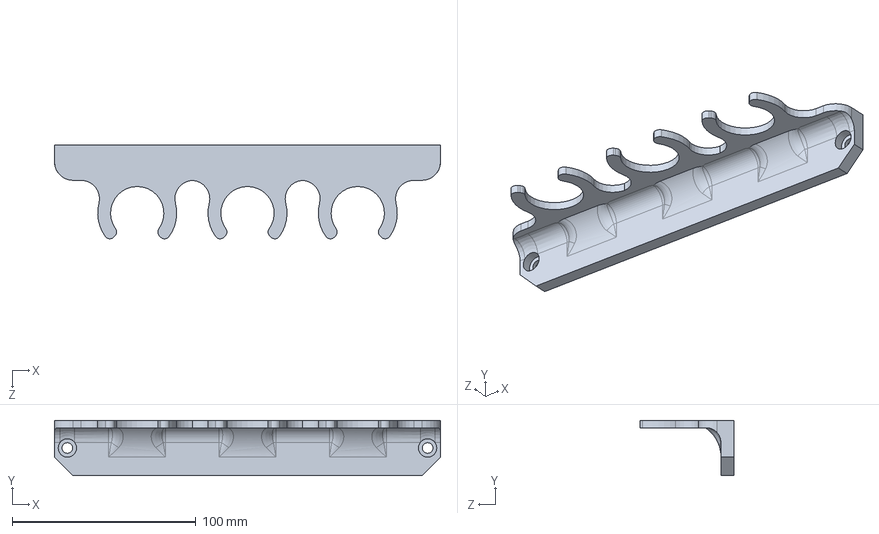
[picture p57: CAD file, 2026-11-08]
CAD library/FAB/Hydroponics HA/FHA008A.SLDPRT
210.0 x 30.0 x 51.0 mm
