TanzH1225/GrowTech-Wall-Handover/CAD library/FAB/Robotic Arm RA/FRA005D.SLDPRT

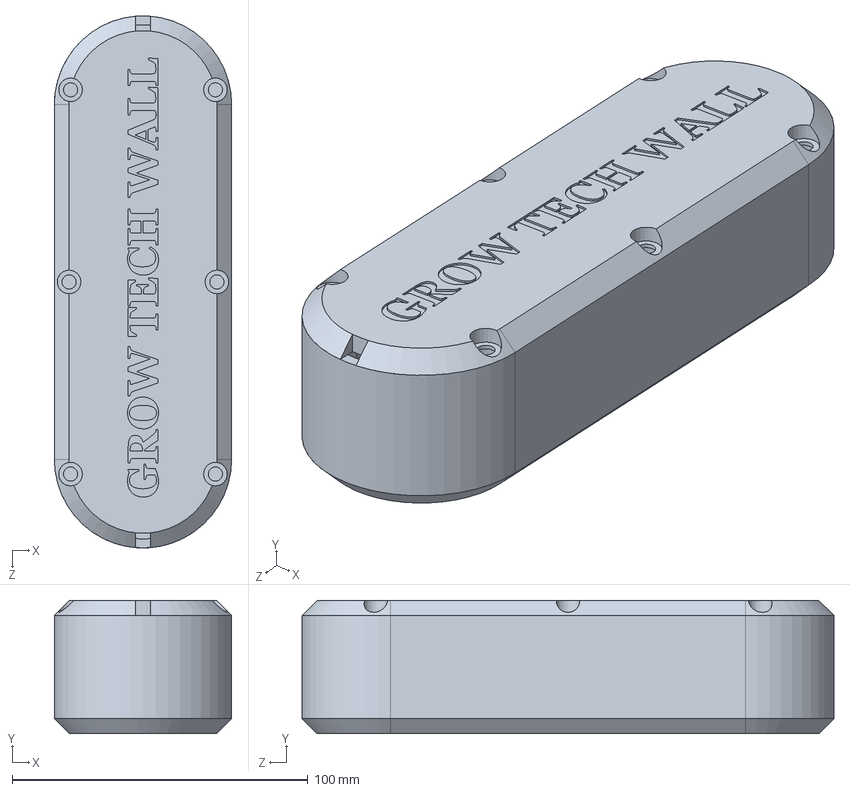
[picture p58: CAD file, 2026-11-08]
CAD library/FAB/Robotic Arm RA/FRA005D.SLDPRT
60.0 x 45.0 x 180.0 mm
