TanzH1225/GrowTech-Wall-Handover/CAD library/Standard/HTS-35H 240 35kg Servo/240 Servo Motor HTS-35H.SLDPRT

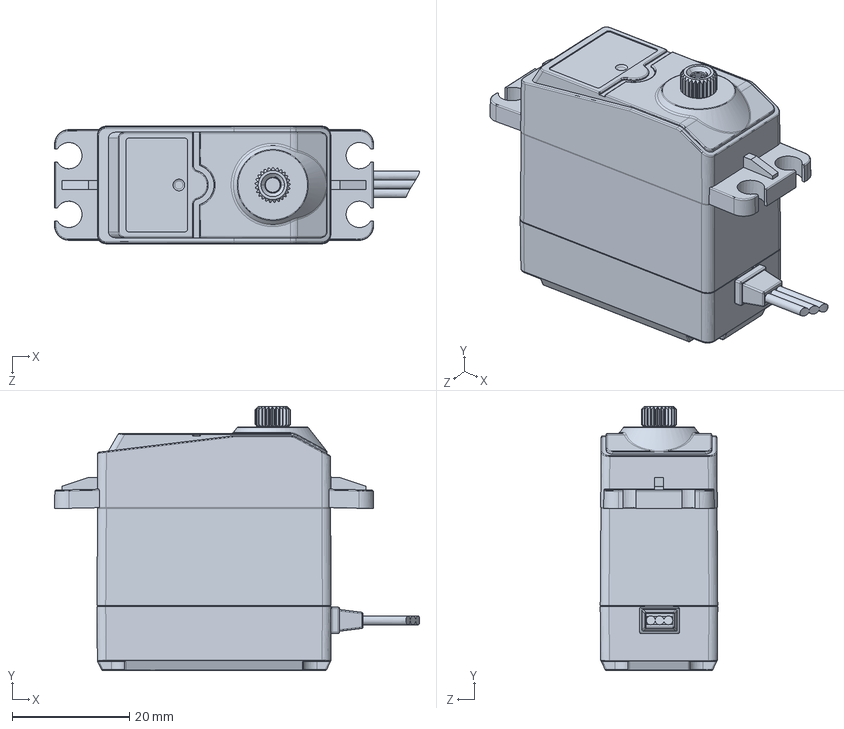
[picture p59: CAD file, 2026-11-08]
CAD library/Standard/HTS-35H 240 35kg Servo/240 Servo Motor HTS-35H.SLDPRT
62.2 x 45.0 x 20.0 mm
