TanzH1225/GrowTech-Wall-Handover/CAD library/Standard/HX-12H Small Servo/0_DS-LH8A_stp(2).SLDPRT

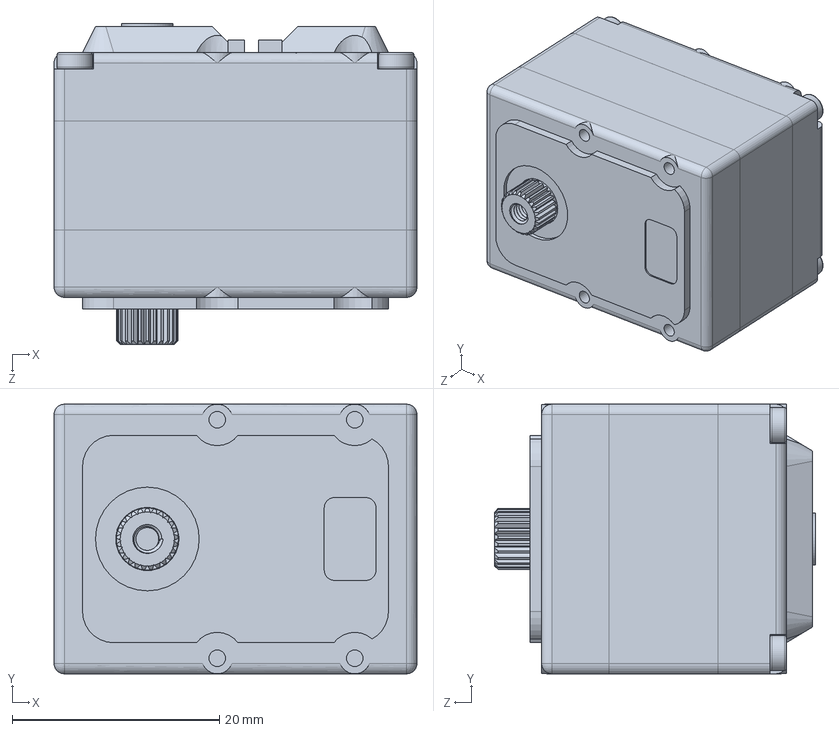
[picture p60: CAD file, 2026-11-08]
CAD library/Standard/HX-12H Small Servo/0_DS-LH8A_stp(2).SLDPRT
35.0 x 26.0 x 30.9 mm
