TanzH1225/GrowTech-Wall-Handover/CAD library/Standard/PH-4502C.SLDPRT

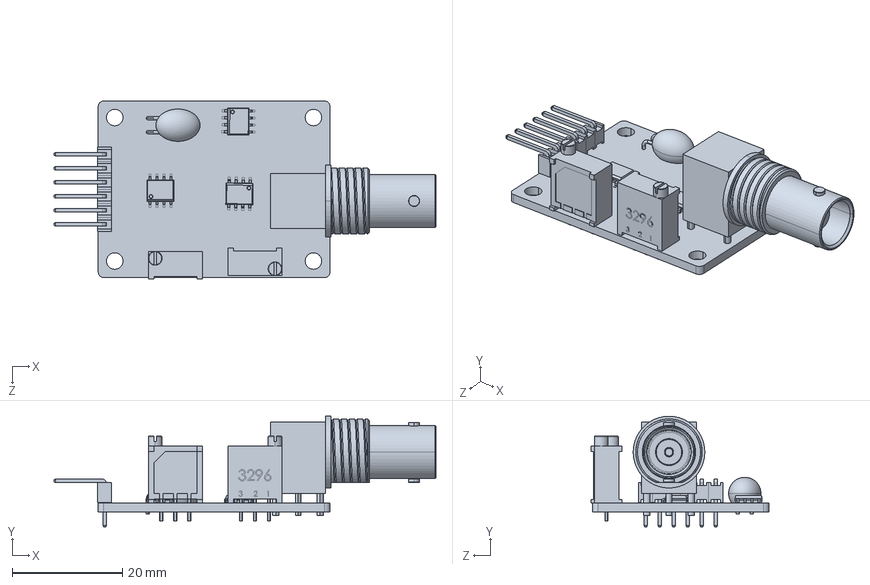
[picture p61: CAD file, 2026-11-08]
CAD library/Standard/PH-4502C.SLDPRT
69.2 x 20.0 x 32.3 mm
