TanzH1225/GrowTech-Wall-Handover/CAD library/Standard/SW2014 Parts Library 1.6/10 - Shims and Spacers/Aluminum Spacer 6mm.SLDPRT

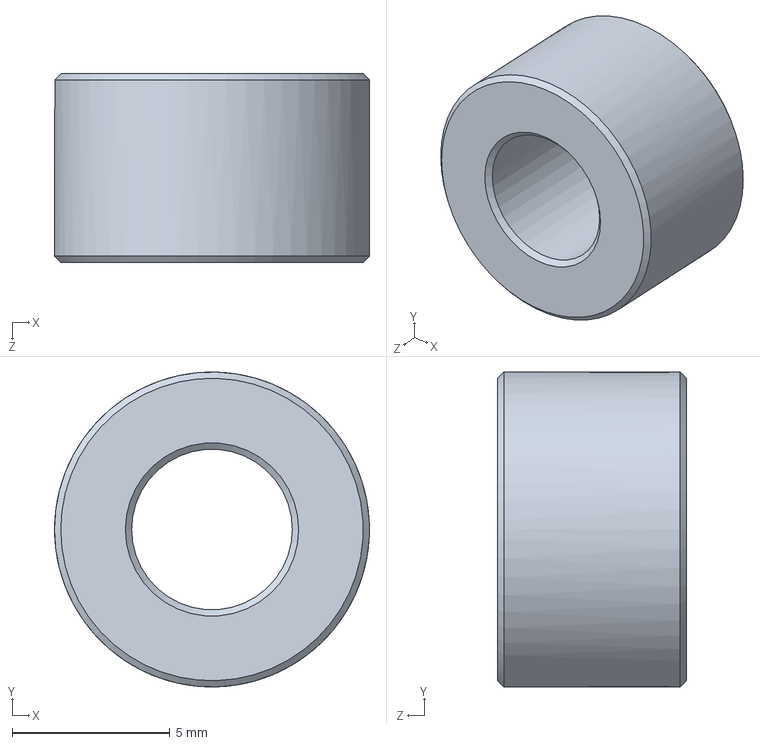
[picture p62: CAD file, 2026-11-08]
CAD library/Standard/SW2014 Parts Library 1.6/10 - Shims and Spacers/Aluminum Spacer 6mm.SLDPRT
10.0 x 10.00 x 6.00 mm
