TanzH1225/GrowTech-Wall-Handover/CAD library/Standard/SW2014 Parts Library 1.6/2 - Wheels/Solid V Wheel.SLDPRT

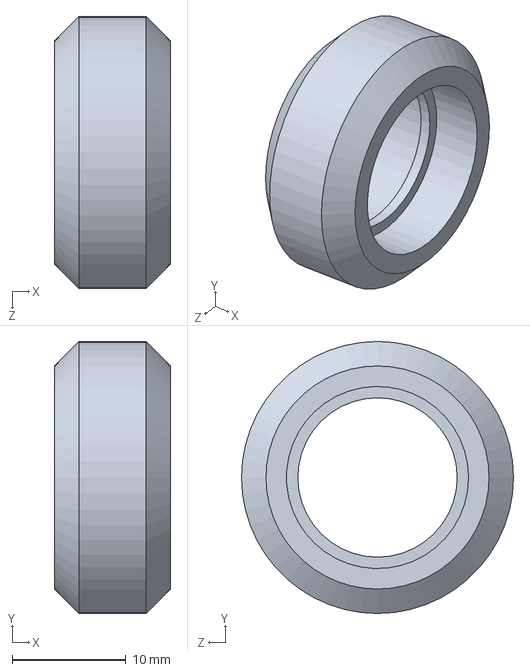
[picture p63: CAD file, 2026-11-08]
CAD library/Standard/SW2014 Parts Library 1.6/2 - Wheels/Solid V Wheel.SLDPRT
10.2 x 23.9 x 23.9 mm
