TanzH1225/GrowTech-Wall-Handover/CAD library/Standard/SW2014 Parts Library 1.6/3 - Bearings/Ball Bearing 5 x 16 x 5.SLDPRT

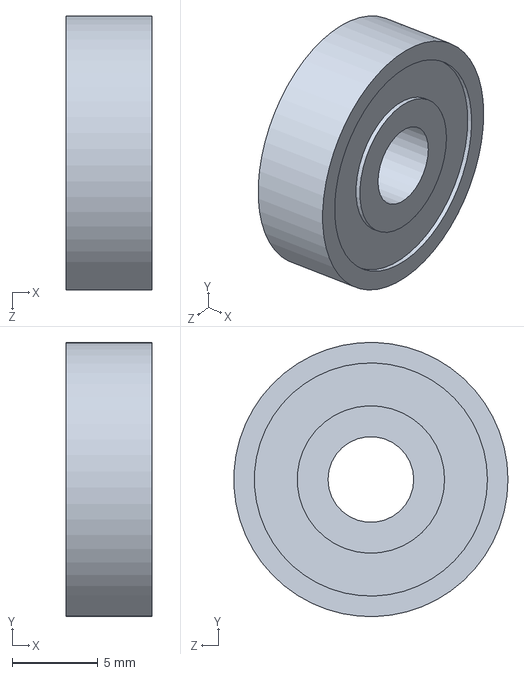
[picture p64: CAD file, 2026-11-08]
CAD library/Standard/SW2014 Parts Library 1.6/3 - Bearings/Ball Bearing 5 x 16 x 5.SLDPRT
5.00 x 16.0 x 16.0 mm
