TanzH1225/GrowTech-Wall-Handover/CAD library/Standard/Turntable Assem/Outer.SLDPRT

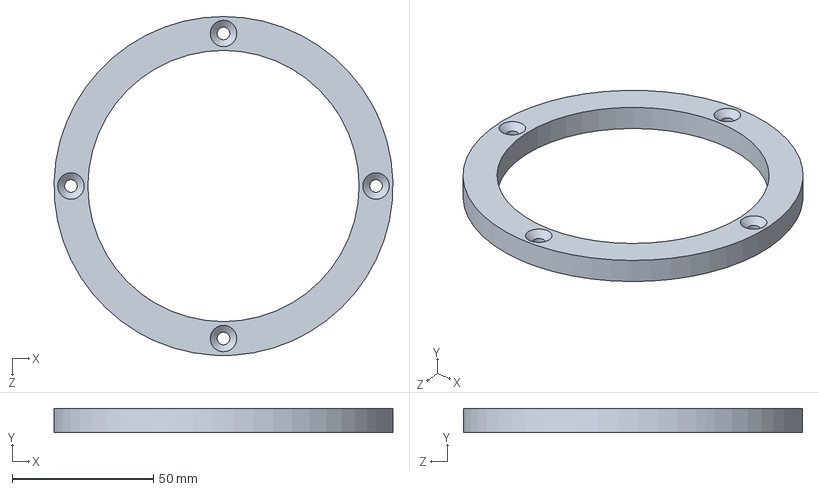
[picture p65: CAD file, 2026-11-08]
CAD library/Standard/Turntable Assem/Outer.SLDPRT
119.9 x 8.60 x 120.0 mm
