TanzH1225/GrowTech-Wall-Handover/CAD library/FAB/Electronics Box EB/EB005A.SLDPRT

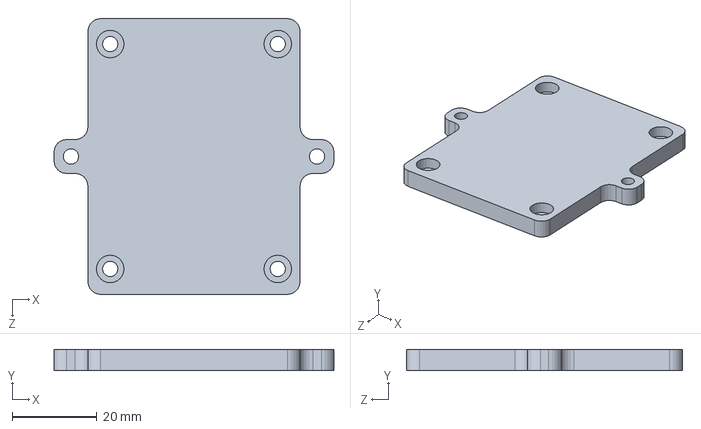
[picture p66: CAD file, 2026-11-08]
CAD library/FAB/Electronics Box EB/EB005A.SLDPRT
66.0 x 5.00 x 65.0 mm
