TanzH1225/GrowTech-Wall-Handover/CAD library/FAB/Electronics Box EB/STL/EB002A-Split1.STL

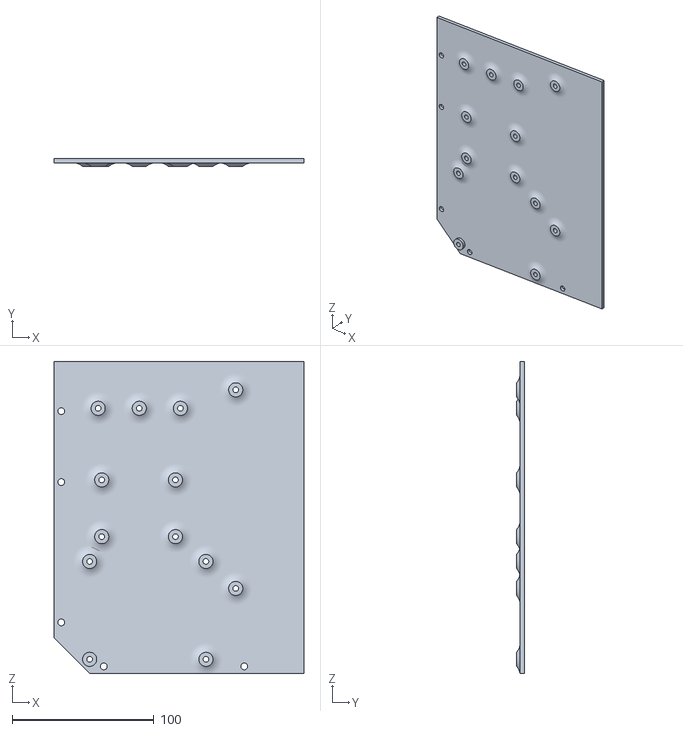
[picture p67: CAD file, 2026-11-08]
CAD library/FAB/Electronics Box EB/STL/EB002A-Split1.STL
176.0 x 5.50 x 220.0
