TanzH1225/GrowTech-Wall-Handover/CAD library/FAB/Gantry GA/FGA015B.SLDPRT

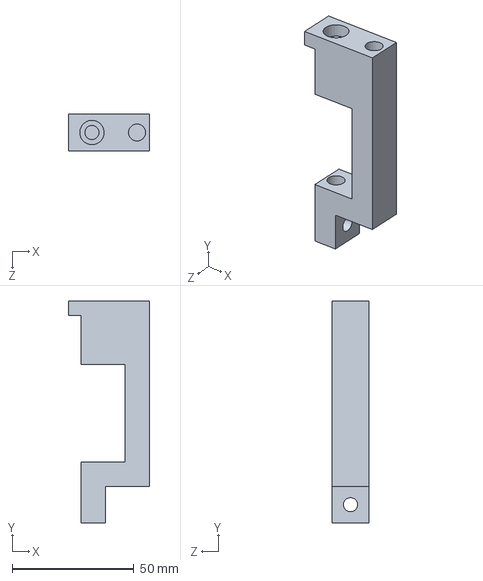
[picture p68: CAD file, 2026-11-08]
CAD library/FAB/Gantry GA/FGA015B.SLDPRT
33.0 x 91.0 x 15.0 mm
