TanzH1225/GrowTech-Wall-Handover/CAD library/FAB/Hydroponics HA/FHA005A.SLDPRT

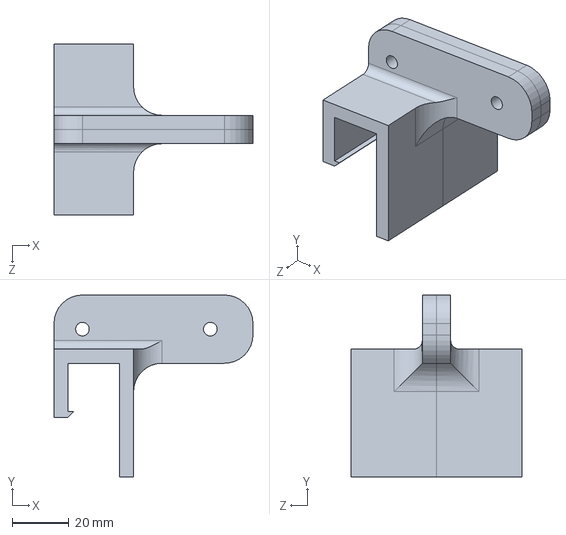
[picture p69: CAD file, 2026-11-08]
CAD library/FAB/Hydroponics HA/FHA005A.SLDPRT
70.0 x 64.0 x 60.0 mm
