TanzH1225/GrowTech-Wall-Handover/CAD library/FAB/Robotic Arm RA/FRA018C.SLDPRT

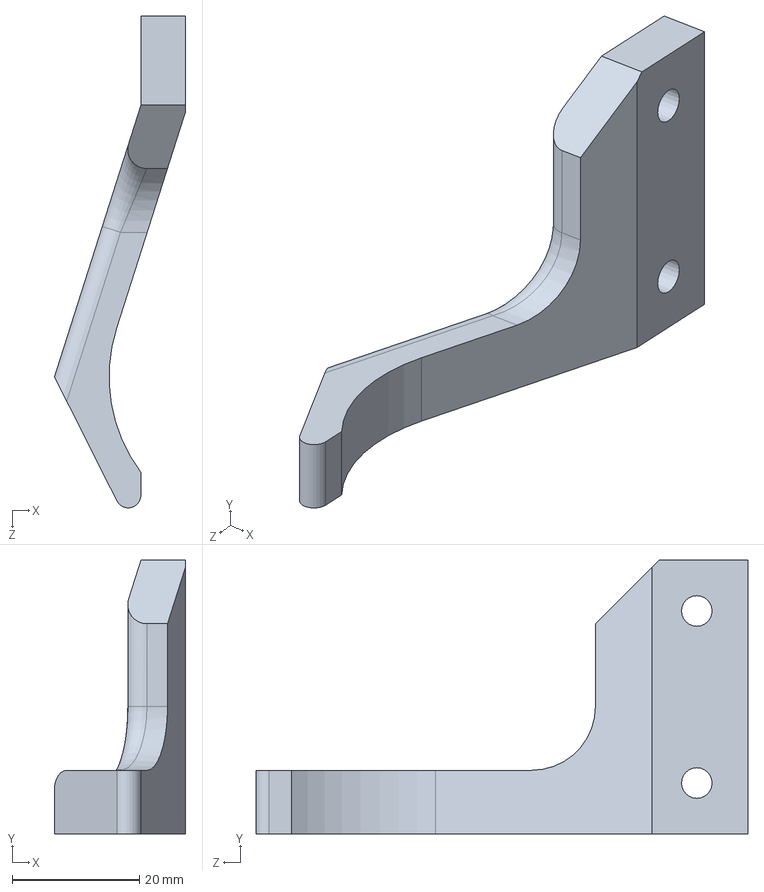
[picture p70: CAD file, 2026-11-08]
CAD library/FAB/Robotic Arm RA/FRA018C.SLDPRT
20.6 x 43.0 x 77.1 mm
