TanzH1225/GrowTech-Wall-Handover/CAD library/Standard/Hydroponic Channel/Hydroponic Channel 1 Meter.SLDPRT

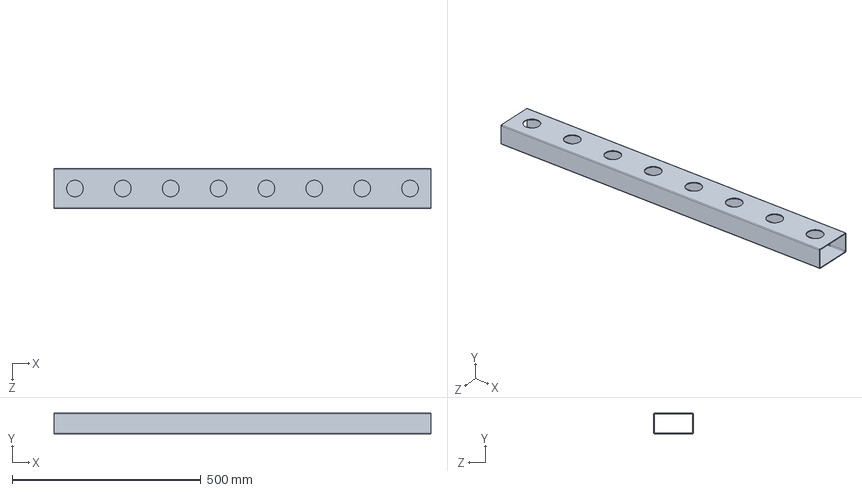
[picture p71: CAD file, 2026-11-08]
CAD library/Standard/Hydroponic Channel/Hydroponic Channel 1 Meter.SLDPRT
1000.0 x 55.0 x 105.7 mm
