TanzH1225/GrowTech-Wall-Handover/CAD library/Standard/Planting.SLDPRT

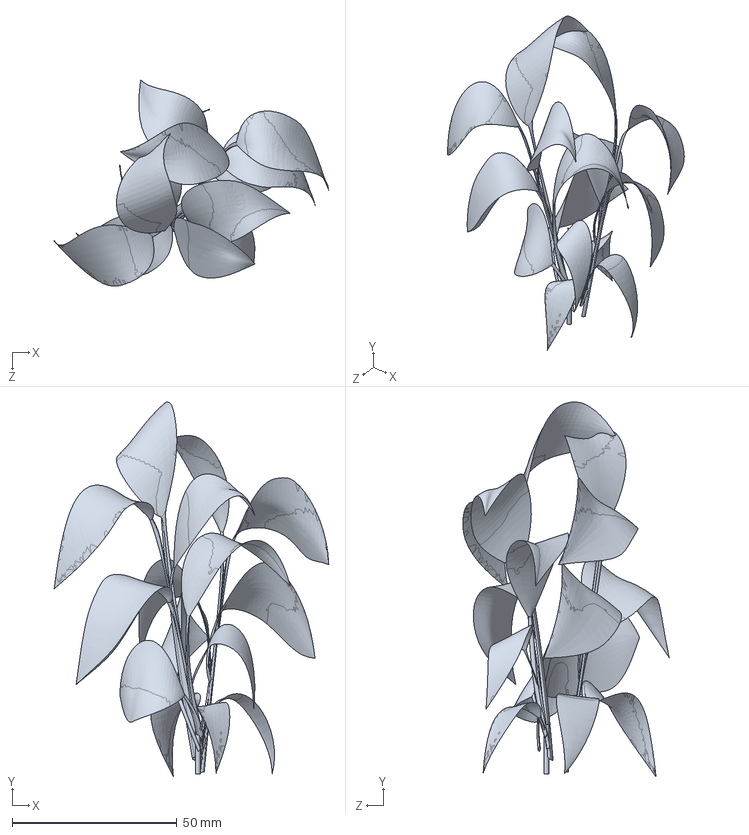
[picture p72: CAD file, 2026-11-08]
CAD library/Standard/Planting.SLDPRT
83.3 x 113.7 x 62.6 mm
