TanzH1225/GrowTech-Wall-Handover/CAD library/Standard/SW2014 Parts Library 1.6/10 - Shims and Spacers/Eccentric Spacer 6mm.SLDPRT

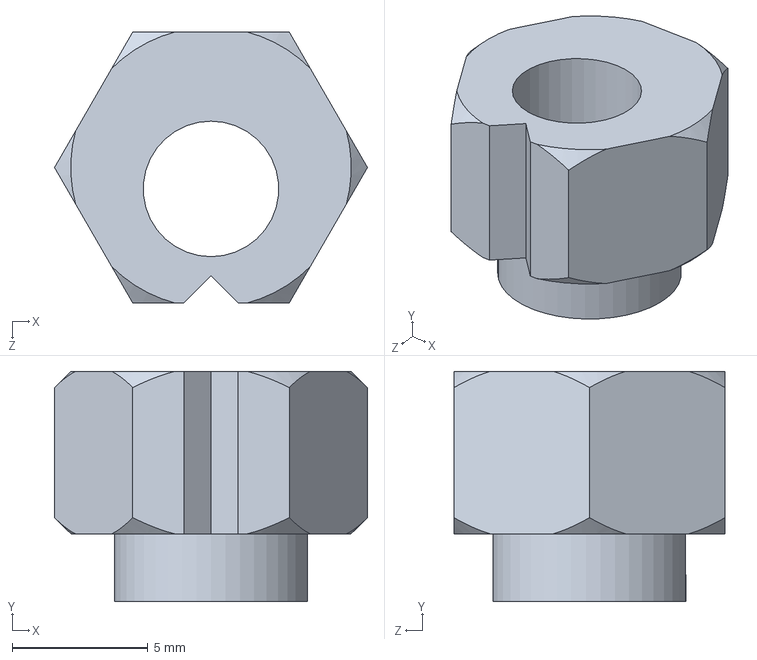
[picture p73: CAD file, 2026-11-08]
CAD library/Standard/SW2014 Parts Library 1.6/10 - Shims and Spacers/Eccentric Spacer 6mm.SLDPRT
11.5 x 8.50 x 10.0 mm
