TanzH1225/GrowTech-Wall-Handover/CAD library/FAB/Electronics Box EB/EB004A.SLDPRT

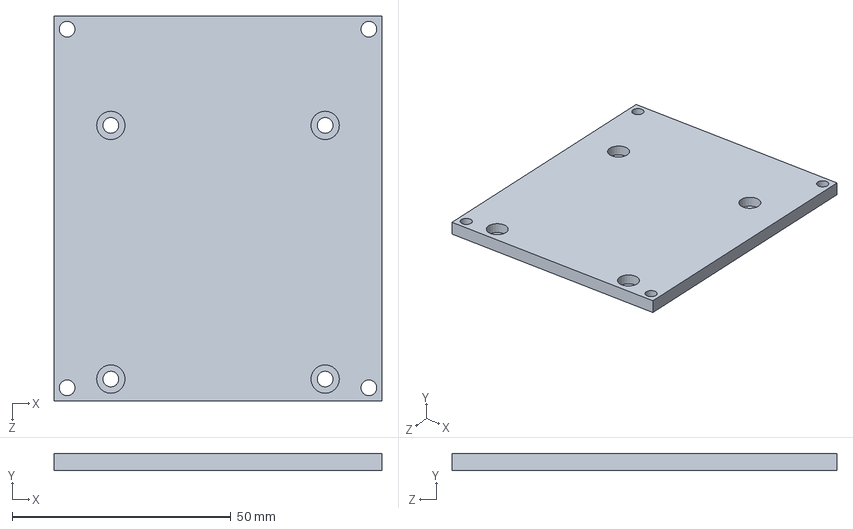
[picture p74: CAD file, 2026-11-08]
CAD library/FAB/Electronics Box EB/EB004A.SLDPRT
75.0 x 4.00 x 88.0 mm
