TanzH1225/GrowTech-Wall-Handover/CAD library/FAB/Gantry GA/FGA022A.SLDPRT

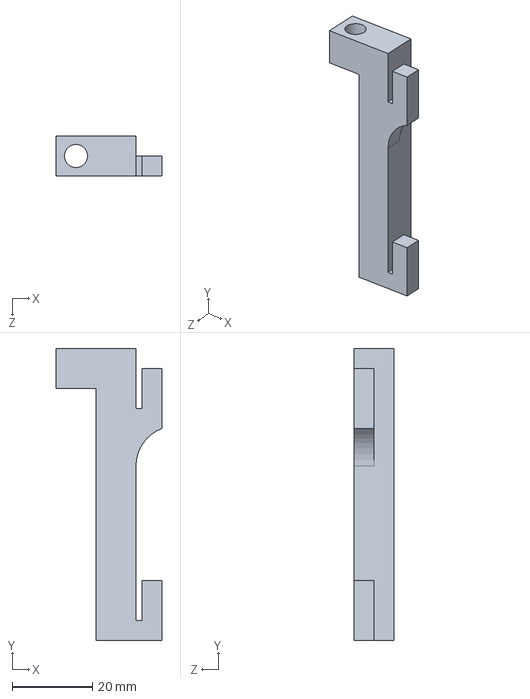
[picture p75: CAD file, 2026-11-08]
CAD library/FAB/Gantry GA/FGA022A.SLDPRT
26.5 x 73.0 x 10.0 mm
