TanzH1225/GrowTech-Wall-Handover/CAD library/FAB/Hydroponics HA/FHA009A.SLDPRT

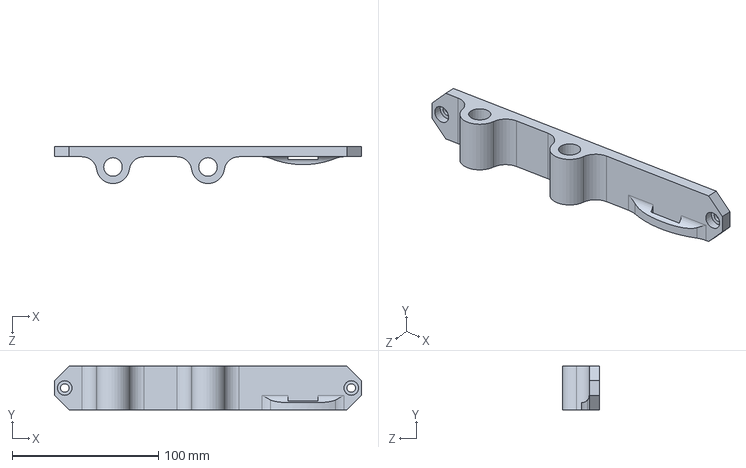
[picture p76: CAD file, 2026-11-08]
CAD library/FAB/Hydroponics HA/FHA009A.SLDPRT
210.0 x 30.0 x 25.3 mm
