TanzH1225/GrowTech-Wall-Handover/CAD library/FAB/Robotic Arm RA/FRA001B.SLDPRT

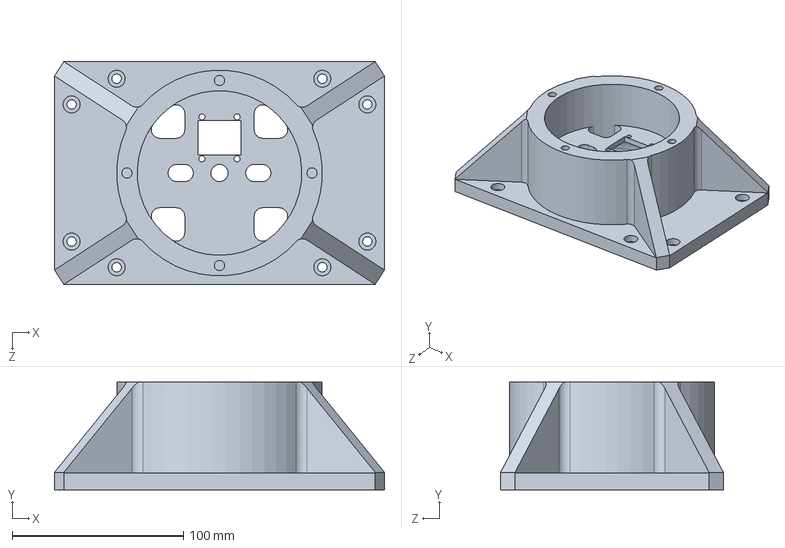
[picture p77: CAD file, 2026-11-08]
CAD library/FAB/Robotic Arm RA/FRA001B.SLDPRT
192.6 x 63.0 x 130.0 mm
