TanzH1225/GrowTech-Wall-Handover/CAD library/Standard/Aluminium Round Spacer.SLDPRT

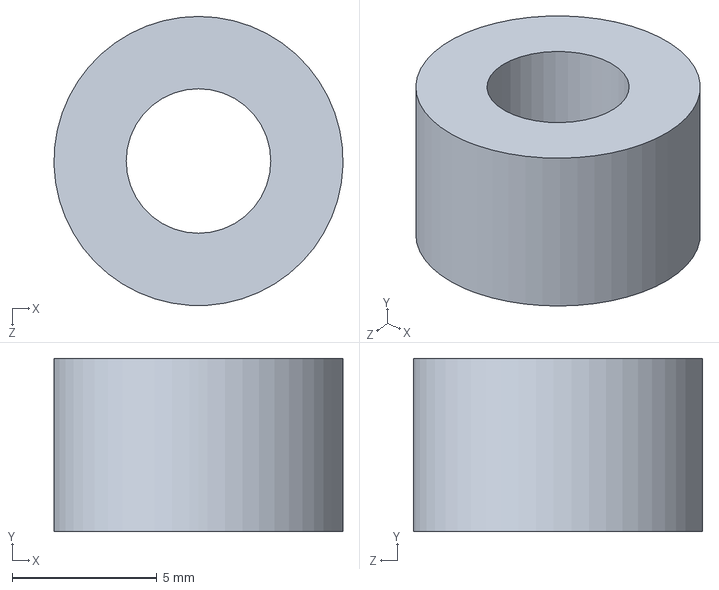
[picture p78: CAD file, 2026-11-08]
CAD library/Standard/Aluminium Round Spacer.SLDPRT
10.00 x 6.00 x 10.0 mm
