TanzH1225/GrowTech-Wall-Handover/CAD library/Standard/Hydroponic Channel/Hydroponic Channel End Cap.SLDPRT

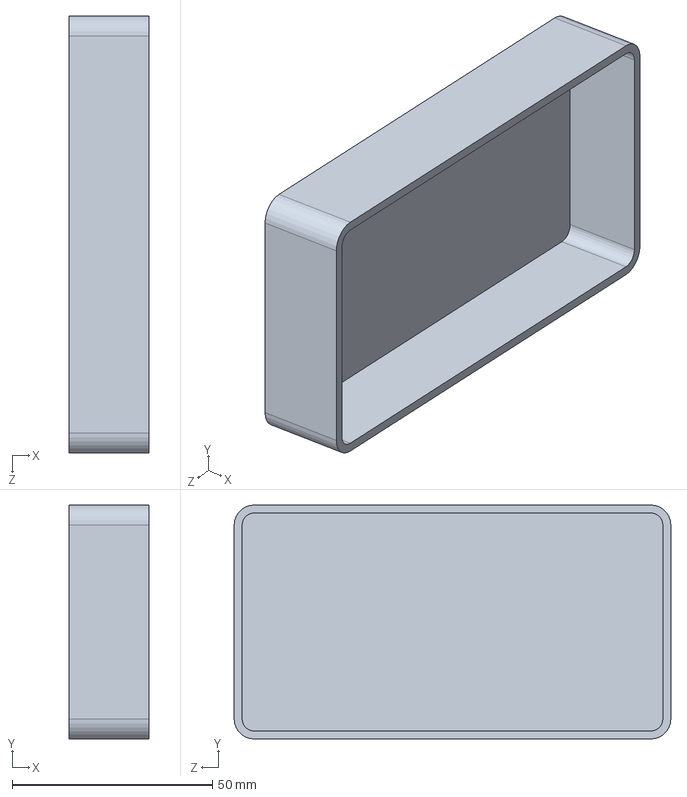
[picture p79: CAD file, 2026-11-08]
CAD library/Standard/Hydroponic Channel/Hydroponic Channel End Cap.SLDPRT
20.0 x 58.4 x 109.0 mm
