TanzH1225/GrowTech-Wall-Handover/CAD library/Standard/SW2014 Parts Library 1.6/10 - Shims and Spacers/Precision Shim 10 x 5 x 1.SLDPRT

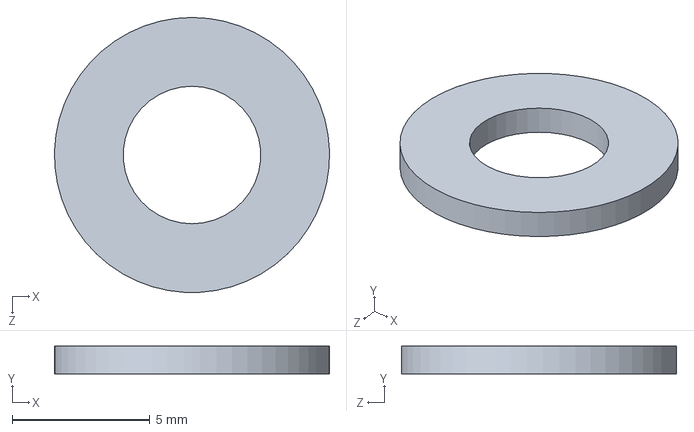
[picture p80: CAD file, 2026-11-08]
CAD library/Standard/SW2014 Parts Library 1.6/10 - Shims and Spacers/Precision Shim 10 x 5 x 1.SLDPRT
10.00 x 1.00 x 10.0 mm
