TanzH1225/GrowTech-Wall-Handover/CAD library/Standard/Turntable Assem/Inner.SLDPRT

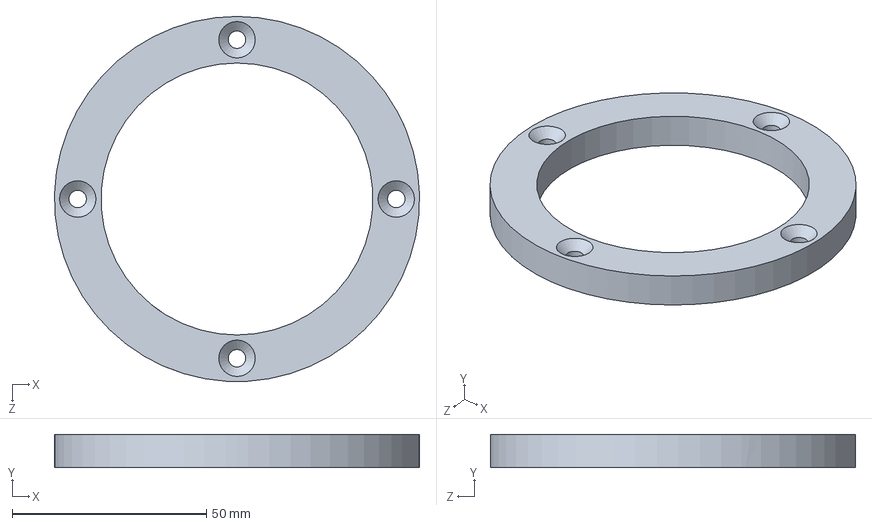
[picture p81: CAD file, 2026-11-08]
CAD library/Standard/Turntable Assem/Inner.SLDPRT
94.0 x 8.60 x 94.0 mm
