TanzH1225/GrowTech-Wall-Handover/CAD library/FAB/Electronics Box EB/EB003A.SLDPRT

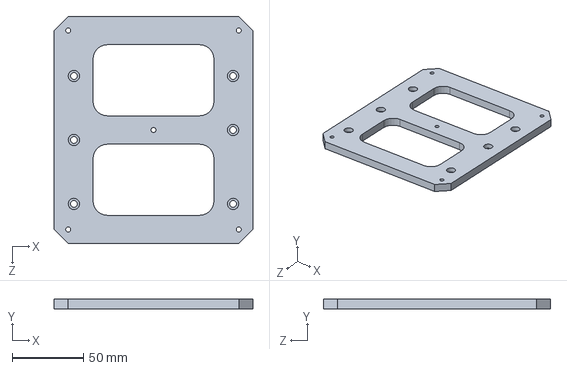
[picture p82: CAD file, 2026-11-08]
CAD library/FAB/Electronics Box EB/EB003A.SLDPRT
140.0 x 7.00 x 160.0 mm
