TanzH1225/GrowTech-Wall-Handover/CAD library/FAB/Gantry GA/FGA012A.SLDPRT

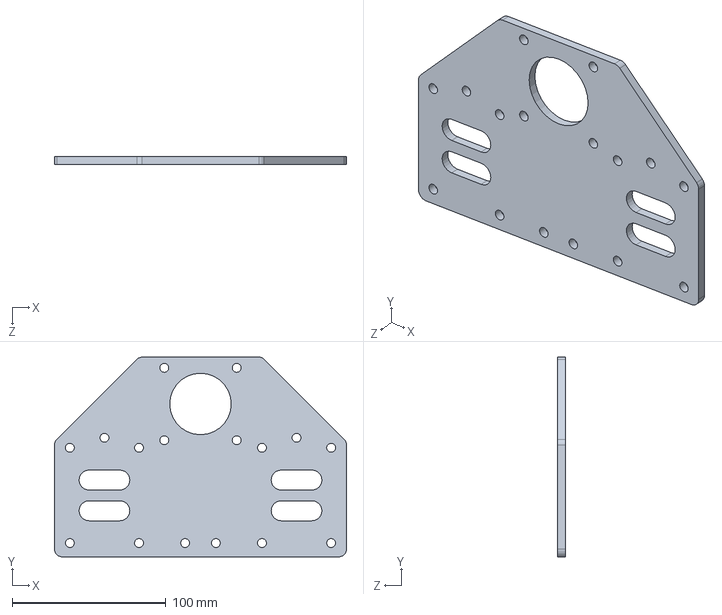
[picture p83: CAD file, 2026-11-08]
CAD library/FAB/Gantry GA/FGA012A.SLDPRT
190.0 x 130.0 x 5.00 mm
