TanzH1225/GrowTech-Wall-Handover/CAD library/FAB/Hydroponics HA/FHA002A.SLDPRT

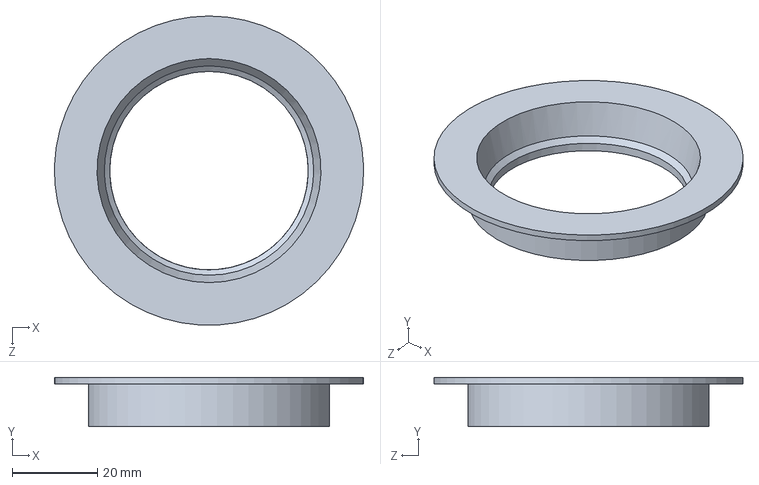
[picture p84: CAD file, 2026-11-08]
CAD library/FAB/Hydroponics HA/FHA002A.SLDPRT
72.5 x 11.5 x 72.4 mm
