TanzH1225/GrowTech-Wall-Handover/CAD library/Standard/3mmX80mm shaft.SLDPRT

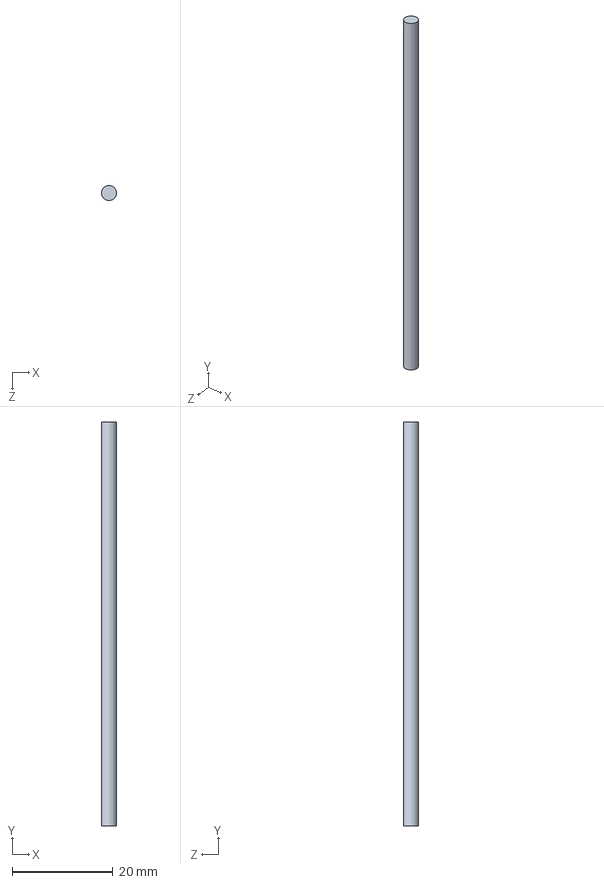
[picture p85: CAD file, 2026-11-08]
CAD library/Standard/3mmX80mm shaft.SLDPRT
3.00 x 80.0 x 3.00 mm
