TanzH1225/GrowTech-Wall-Handover/CAD library/FAB/Electronics Box EB/EB006A.SLDPRT

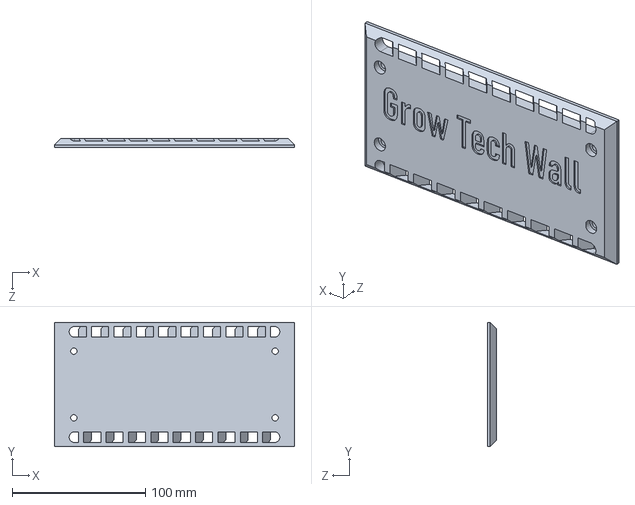
[picture p86: CAD file, 2026-11-08]
CAD library/FAB/Electronics Box EB/EB006A.SLDPRT
180.0 x 93.0 x 7.00 mm
