TanzH1225/GrowTech-Wall-Handover/CAD library/FAB/Gantry GA/FGA013B.SLDPRT

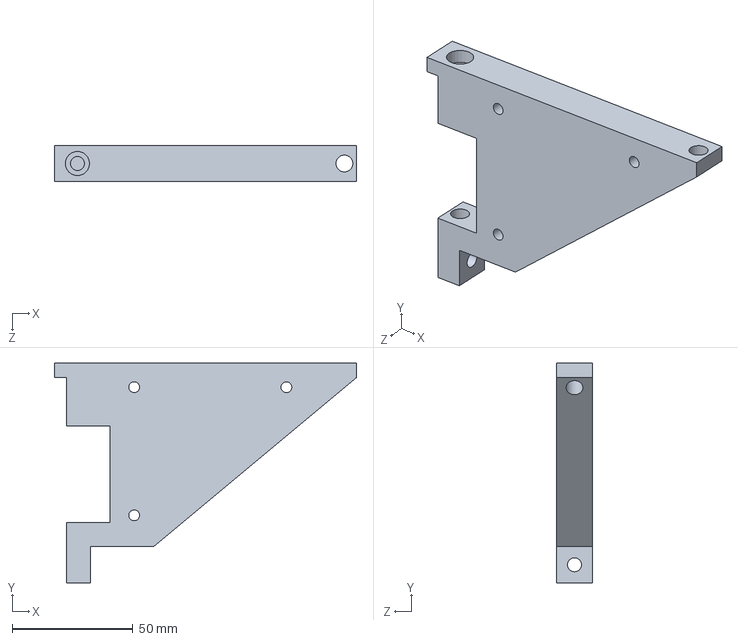
[picture p87: CAD file, 2026-11-08]
CAD library/FAB/Gantry GA/FGA013B.SLDPRT
125.0 x 91.0 x 15.0 mm
