TanzH1225/GrowTech-Wall-Handover/CAD library/FAB/Hydroponics HA/FHA003B.SLDPRT

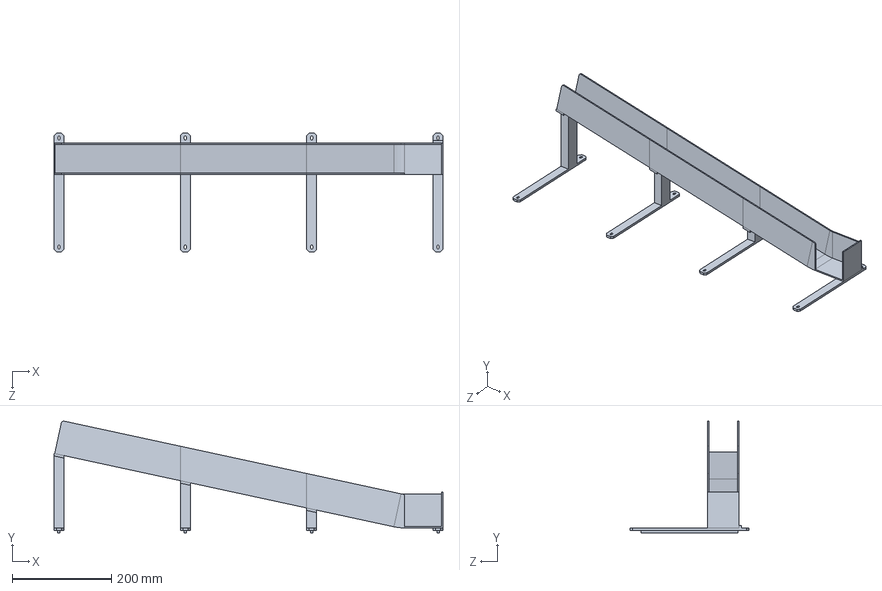
[picture p88: CAD file, 2026-11-08]
CAD library/FAB/Hydroponics HA/FHA003B.SLDPRT
785.0 x 225.6 x 240.0 mm
