TanzH1225/GrowTech-Wall-Handover/CAD library/FAB/Robotic Arm RA/FRA015B.SLDPRT

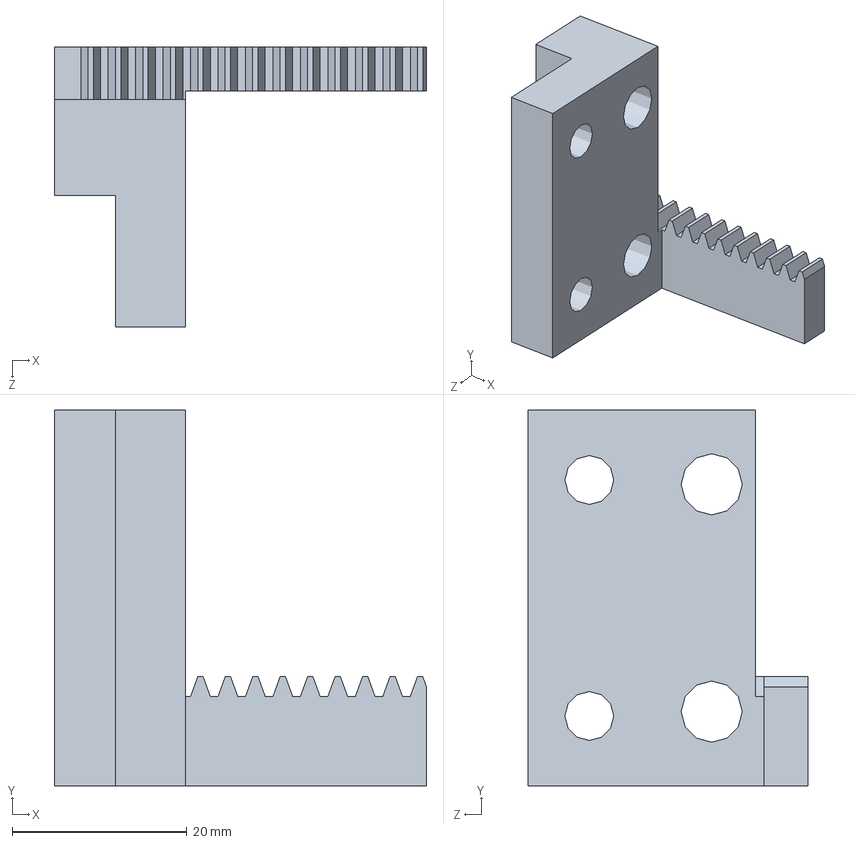
[picture p89: CAD file, 2026-11-08]
CAD library/FAB/Robotic Arm RA/FRA015B.SLDPRT
42.6 x 43.0 x 32.0 mm
