TanzH1225/GrowTech-Wall-Handover/CAD library/Standard/Electrical Panel Box.SLDPRT

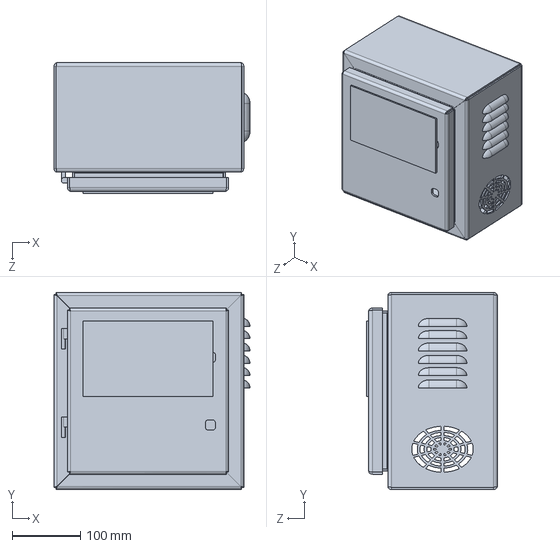
[picture p90: CAD file, 2026-11-08]
CAD library/Standard/Electrical Panel Box.SLDPRT
286.5 x 288.0 x 191.0 mm
