TanzH1225/GrowTech-Wall-Handover/CAD library/FAB/Electronics Box EB/EB007A.SLDPRT

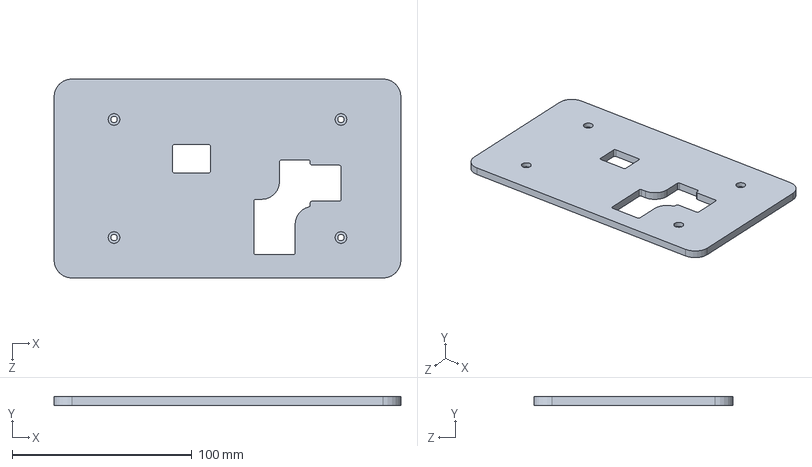
[picture p91: CAD file, 2026-11-08]
CAD library/FAB/Electronics Box EB/EB007A.SLDPRT
193.0 x 5.00 x 110.8 mm
