TanzH1225/GrowTech-Wall-Handover/CAD library/FAB/Gantry GA/FGA019A.SLDPRT

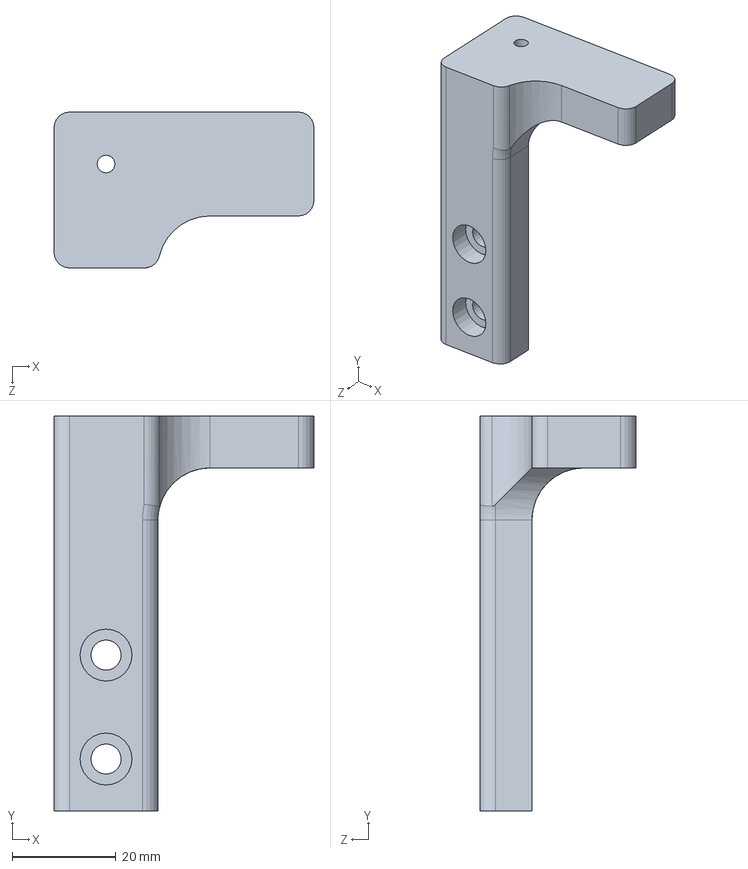
[picture p92: CAD file, 2026-11-08]
CAD library/FAB/Gantry GA/FGA019A.SLDPRT
50.0 x 76.0 x 30.0 mm
