TanzH1225/GrowTech-Wall-Handover/CAD library/FAB/Hydroponics HA/FHA012A.SLDPRT

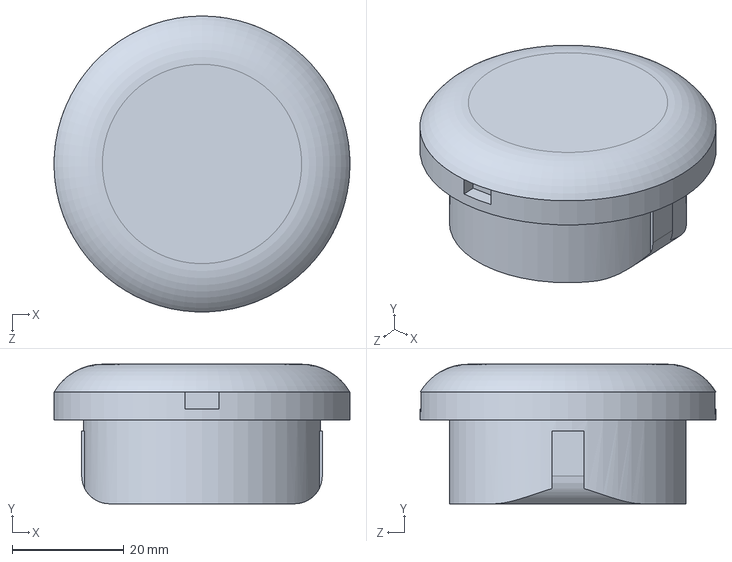
[picture p93: CAD file, 2026-11-08]
CAD library/FAB/Hydroponics HA/FHA012A.SLDPRT
53.0 x 25.0 x 53.0 mm
