TanzH1225/GrowTech-Wall-Handover/CAD library/FAB/Robotic Arm RA/FRA001C.SLDPRT

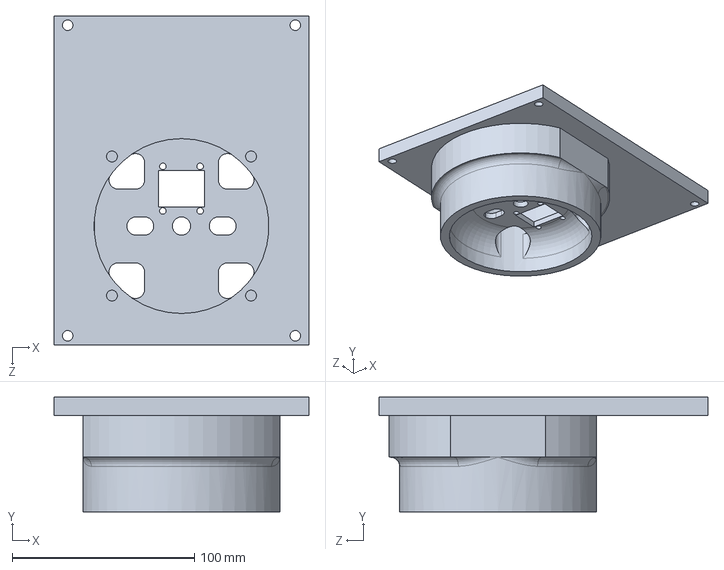
[picture p94: CAD file, 2026-11-08]
CAD library/FAB/Robotic Arm RA/FRA001C.SLDPRT
140.0 x 63.0 x 180.5 mm
