TanzH1225/GrowTech-Wall-Handover/CAD library/Standard/IDP hydroponics netpot.SLDPRT

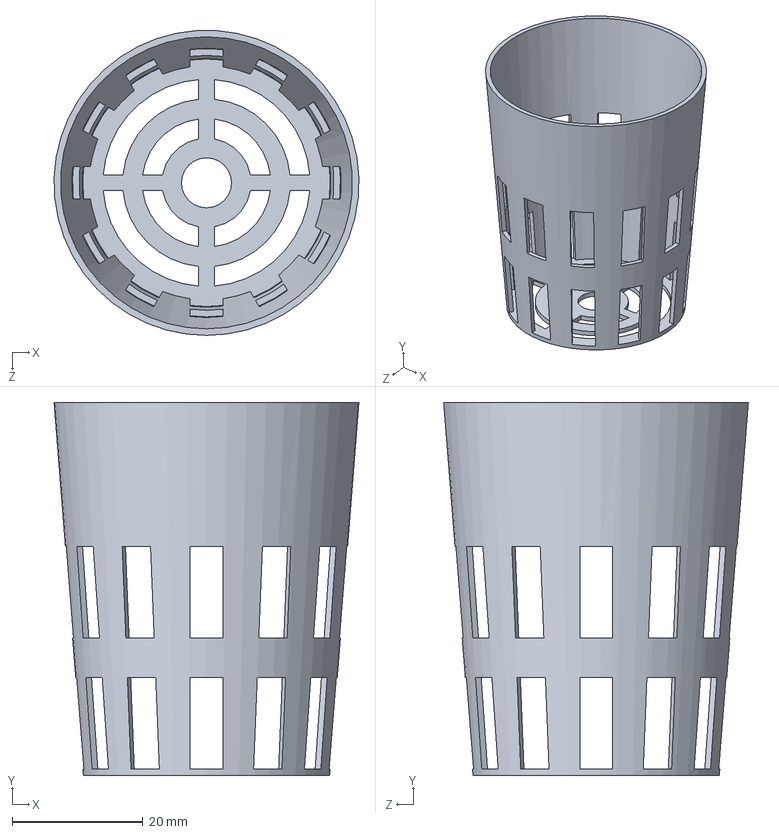
[picture p95: CAD file, 2026-11-08]
CAD library/Standard/IDP hydroponics netpot.SLDPRT
46.6 x 57.0 x 46.6 mm
