TanzH1225/GrowTech-Wall-Handover/CAD library/FAB/Gantry GA/FGA018A.SLDPRT

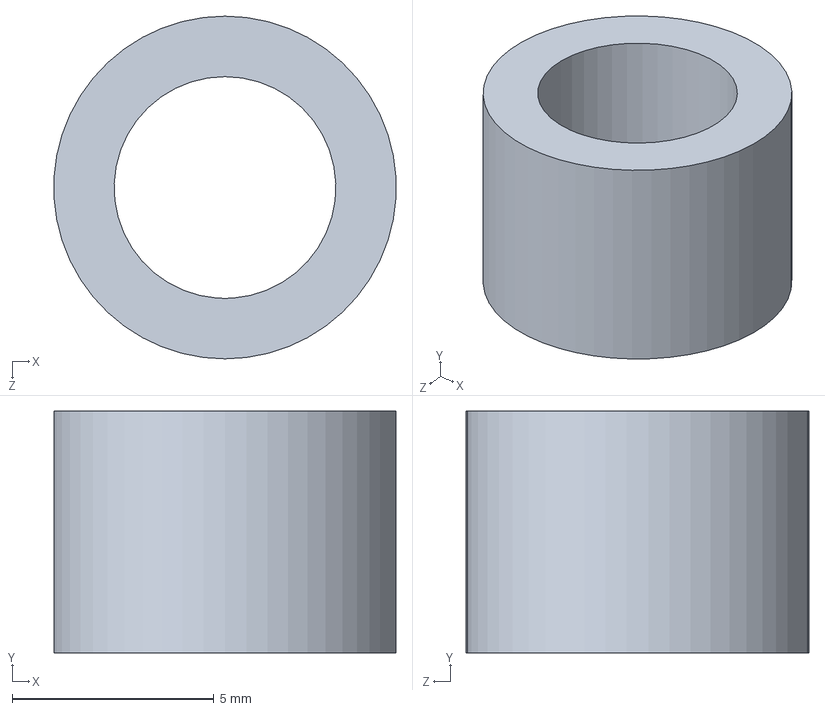
[picture p96: CAD file, 2026-11-08]
CAD library/FAB/Gantry GA/FGA018A.SLDPRT
8.48 x 6.00 x 8.50 mm
