TanzH1225/GrowTech-Wall-Handover/CAD library/FAB/Hydroponics HA/FHA004A.SLDPRT

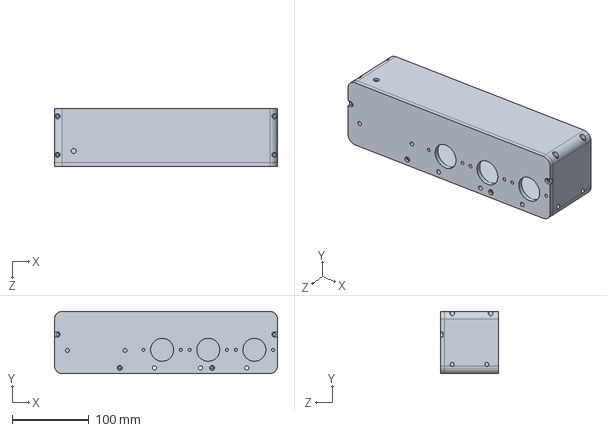
[picture p97: CAD file, 2026-11-08]
CAD library/FAB/Hydroponics HA/FHA004A.SLDPRT
290.0 x 81.0 x 75.0 mm
