TanzH1225/GrowTech-Wall-Handover/CAD library/FAB/Robotic Arm RA/FRA010A.SLDPRT

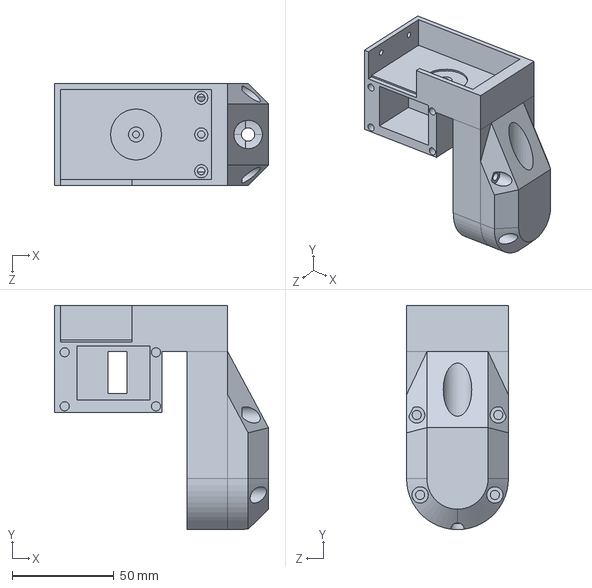
[picture p98: CAD file, 2026-11-08]
CAD library/FAB/Robotic Arm RA/FRA010A.SLDPRT
105.0 x 110.0 x 50.0 mm
