TanzH1225/GrowTech-Wall-Handover/CAD library/Standard/250ml Bottle.SLDPRT

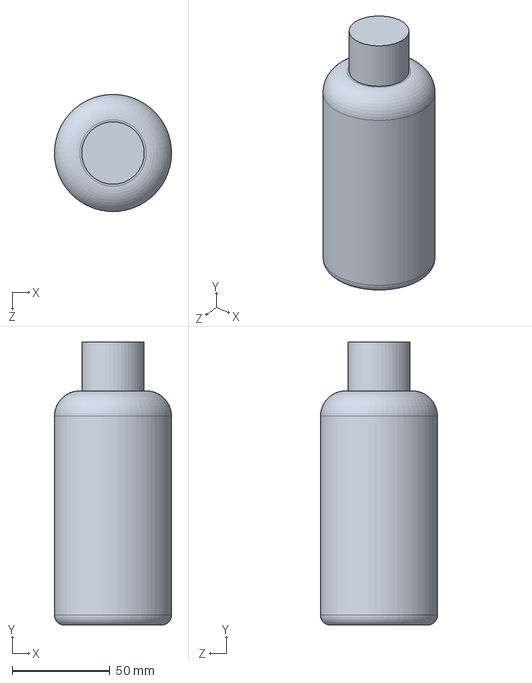
[picture p99: CAD file, 2026-11-08]
CAD library/Standard/250ml Bottle.SLDPRT
60.0 x 145.0 x 60.0 mm
