TanzH1225/GrowTech-Wall-Handover/CAD library/FAB/Gantry GA/FGA004A.SLDPRT

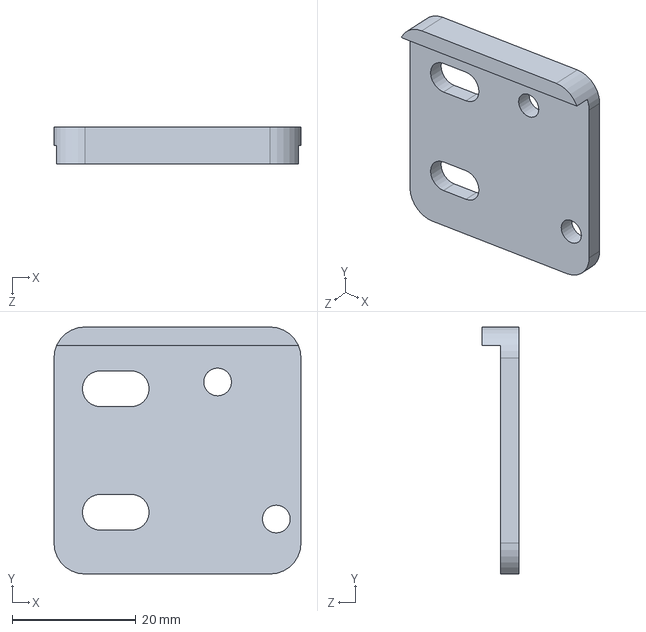
[picture p100: CAD file, 2026-11-08]
CAD library/FAB/Gantry GA/FGA004A.SLDPRT
40.0 x 40.0 x 6.00 mm
