TanzH1225/GrowTech-Wall-Handover/CAD library/FAB/Robotic Arm RA/FRA004B.SLDPRT

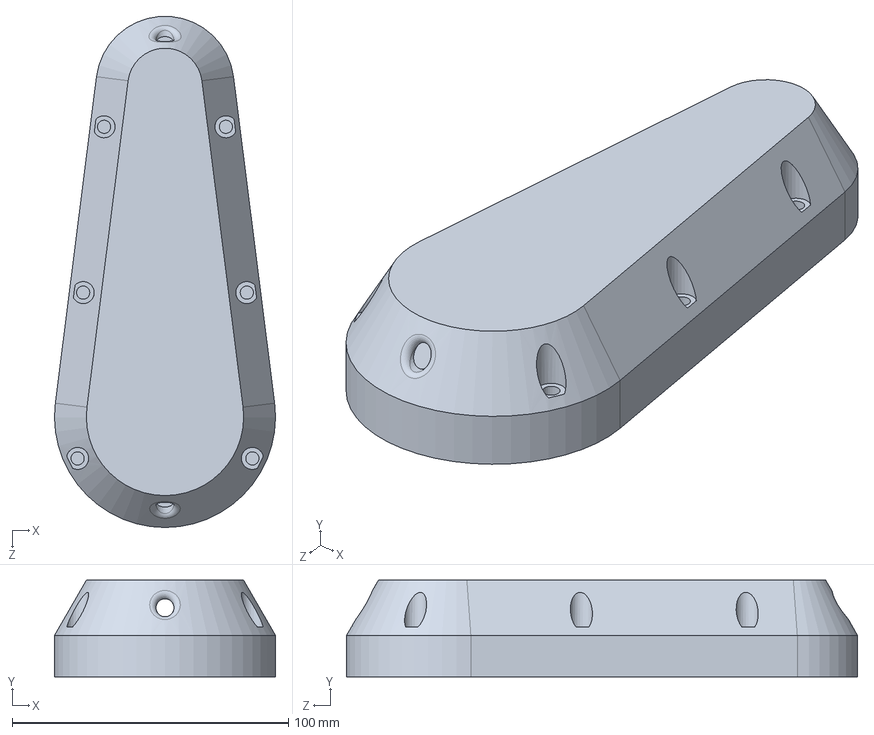
[picture p101: CAD file, 2026-11-08]
CAD library/FAB/Robotic Arm RA/FRA004B.SLDPRT
80.0 x 35.0 x 184.9 mm
