TanzH1225/GrowTech-Wall-Handover/CAD library/Standard/PWM Controller.SLDPRT

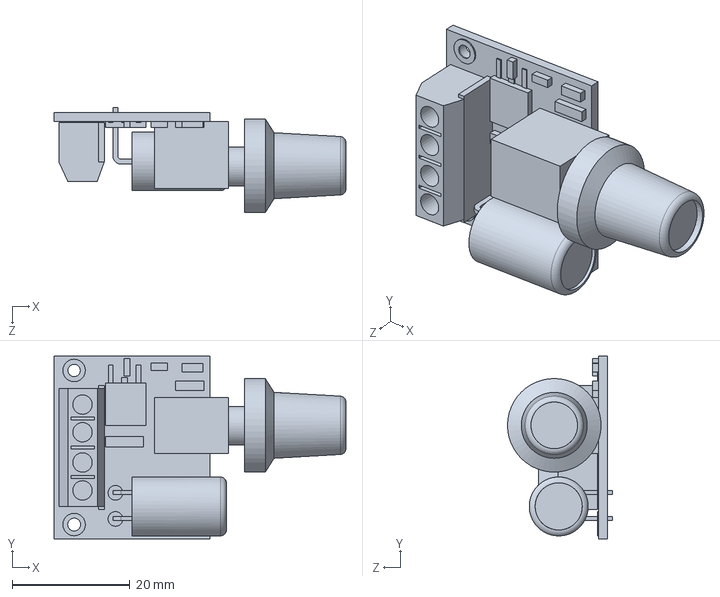
[picture p102: CAD file, 2026-11-08]
CAD library/Standard/PWM Controller.SLDPRT
49.5 x 31.0 x 17.8 mm
