TanzH1225/GrowTech-Wall-Handover/CAD library/FAB/Gantry GA/FGA016A.SLDPRT

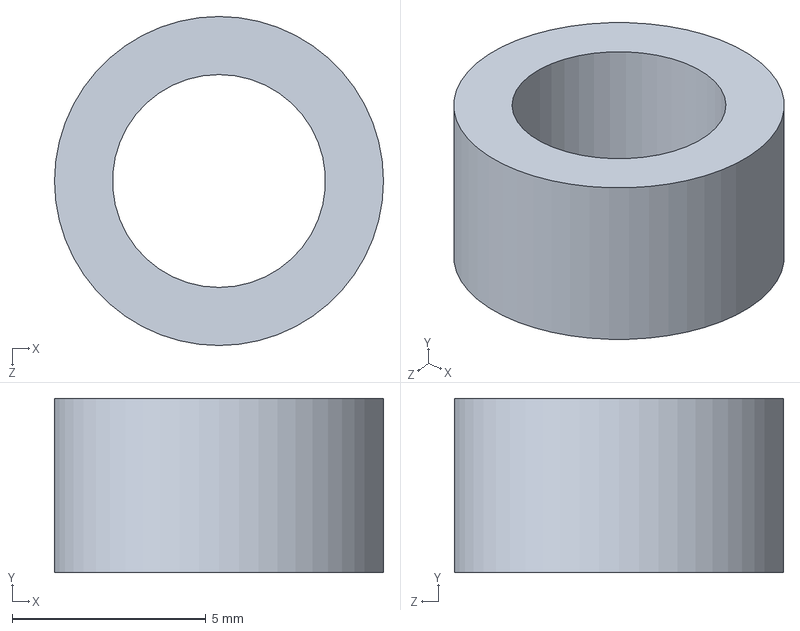
[picture p103: CAD file, 2026-11-08]
CAD library/FAB/Gantry GA/FGA016A.SLDPRT
8.50 x 4.50 x 8.50 mm
