TanzH1225/GrowTech-Wall-Handover/CAD library/FAB/Robotic Arm RA/FRA013A.SLDPRT

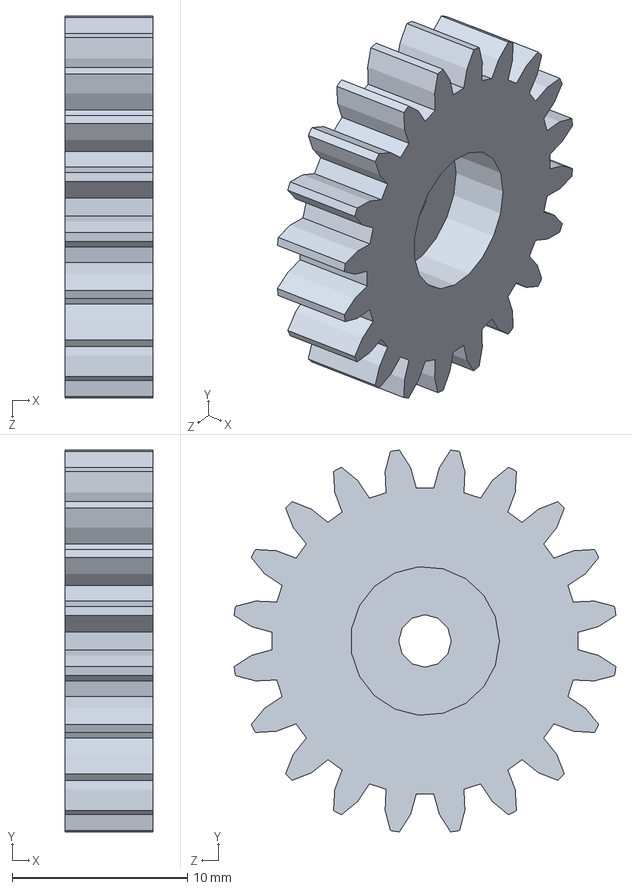
[picture p104: CAD file, 2026-11-08]
CAD library/FAB/Robotic Arm RA/FRA013A.SLDPRT
5.00 x 21.8 x 21.8 mm
