TanzH1225/GrowTech-Wall-Handover/CAD library/Standard/Lineare_bearing_LM3UU.SLDPRT

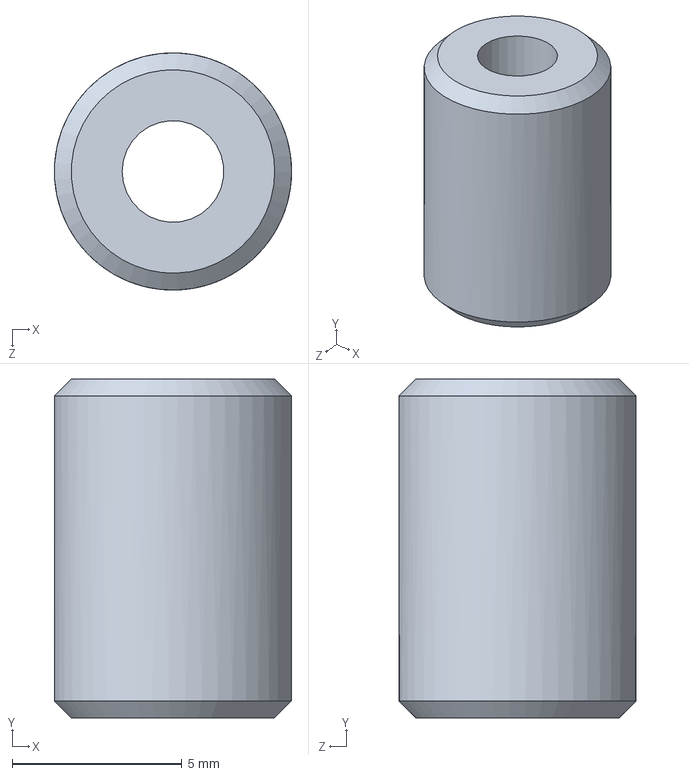
[picture p105: CAD file, 2026-11-08]
CAD library/Standard/Lineare_bearing_LM3UU.SLDPRT
7.00 x 10.0 x 7.00 mm
