TanzH1225/GrowTech-Wall-Handover/CAD library/FAB/Gantry GA/FGA023A.SLDPRT

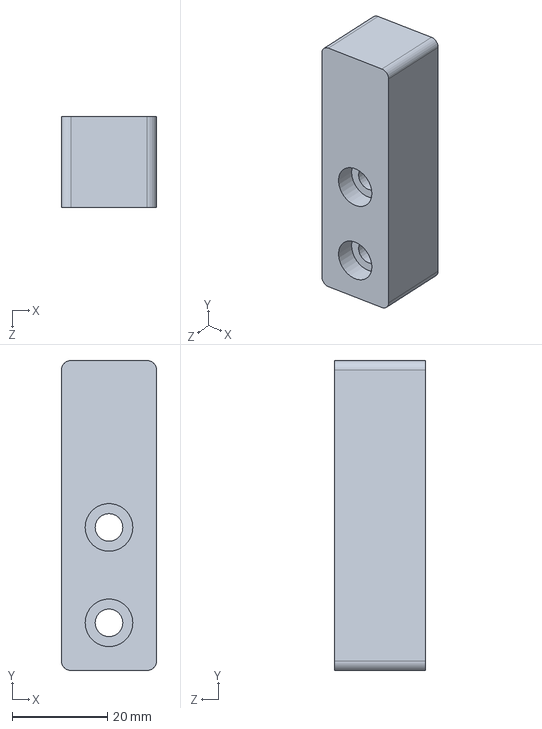
[picture p106: CAD file, 2026-11-08]
CAD library/FAB/Gantry GA/FGA023A.SLDPRT
20.0 x 65.0 x 19.0 mm
