TanzH1225/GrowTech-Wall-Handover/CAD library/FAB/Robotic Arm RA/FRA019A.SLDPRT

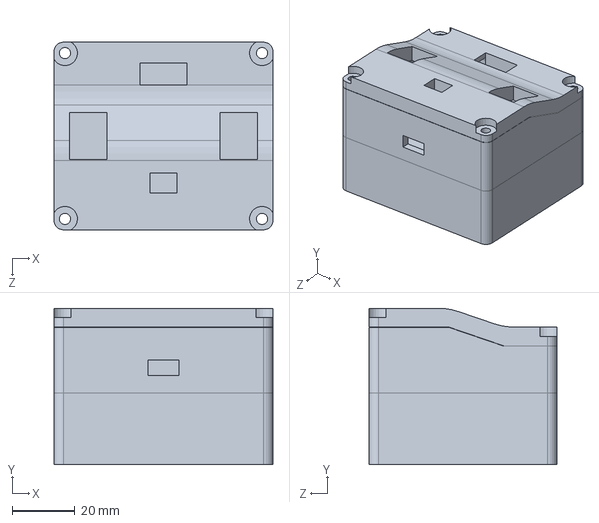
[picture p107: CAD file, 2026-11-08]
CAD library/FAB/Robotic Arm RA/FRA019A.SLDPRT
70.0 x 50.0 x 60.0 mm
