TanzH1225/GrowTech-Wall-Handover/CAD library/Standard/Water Level Sensor.SLDPRT

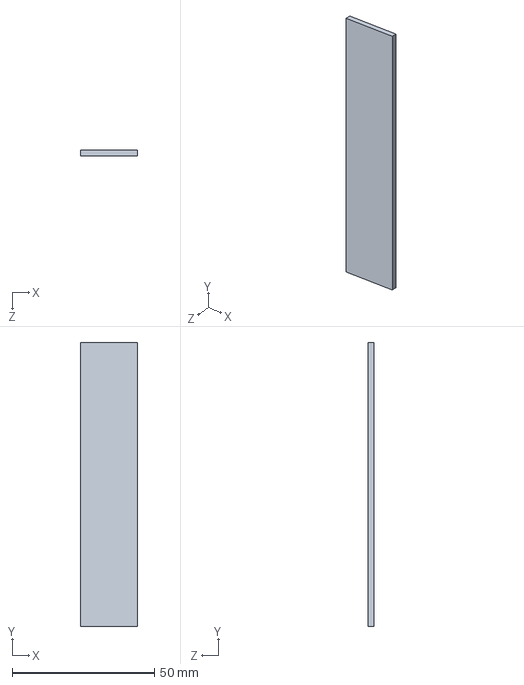
[picture p108: CAD file, 2026-11-08]
CAD library/Standard/Water Level Sensor.SLDPRT
20.0 x 100.0 x 2.00 mm
