TanzH1225/GrowTech-Wall-Handover/CAD library/FAB/Gantry GA/FGA017A.SLDPRT

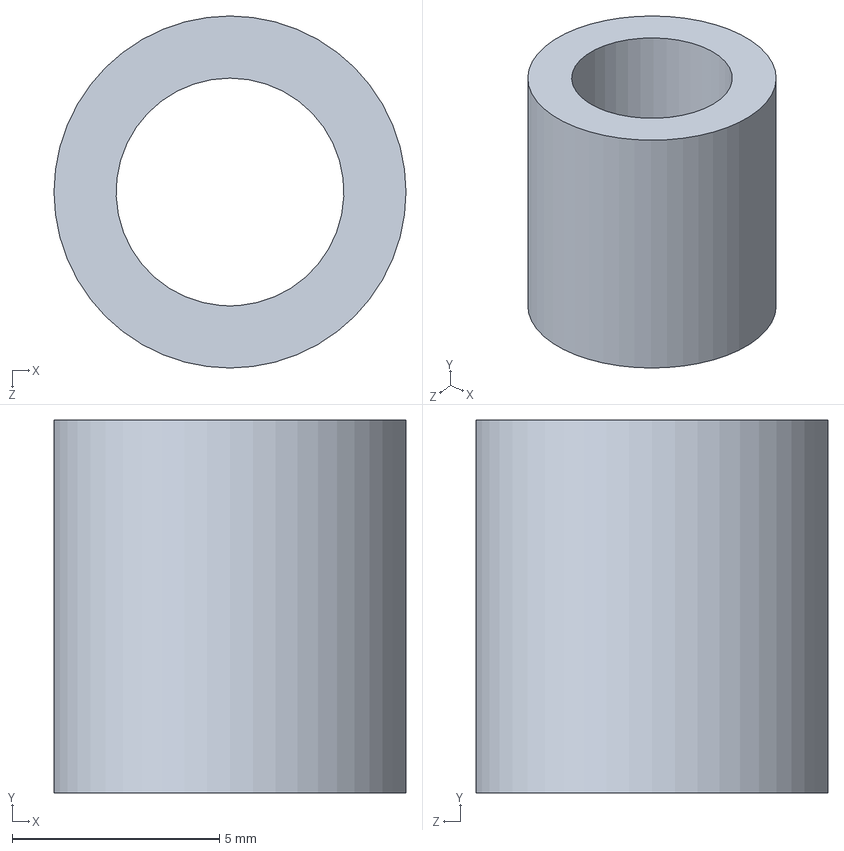
[picture p109: CAD file, 2026-11-08]
CAD library/FAB/Gantry GA/FGA017A.SLDPRT
8.50 x 9.00 x 8.50 mm
