TanzH1225/GrowTech-Wall-Handover/CAD library/FAB/Robotic Arm RA/FRA003C.SLDPRT

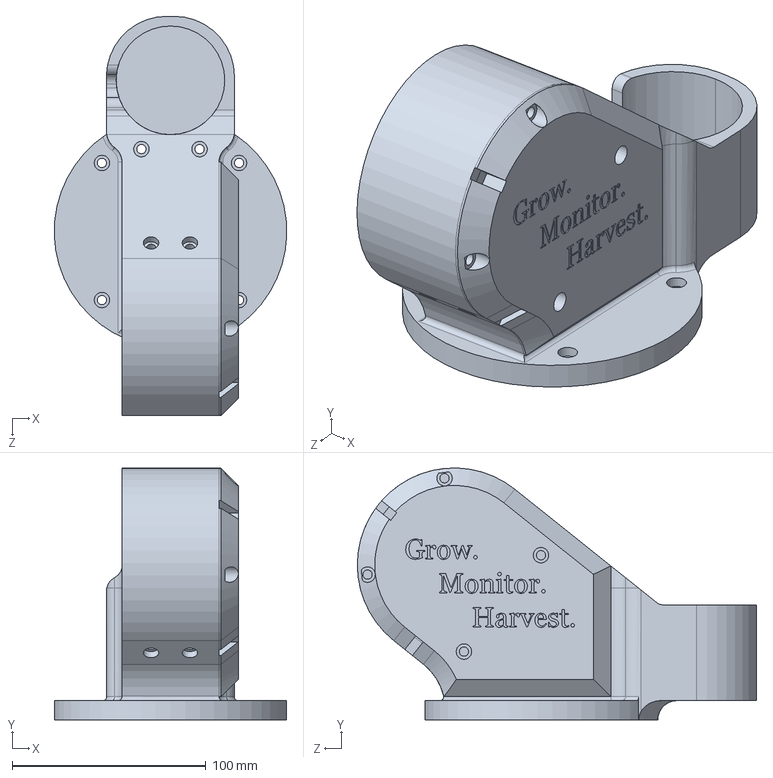
[picture p110: CAD file, 2026-11-08]
CAD library/FAB/Robotic Arm RA/FRA003C.SLDPRT
119.9 x 130.0 x 206.0 mm
