TanzH1225/GrowTech-Wall-Handover/CAD library/Standard/Round Servo Horn.SLDPRT

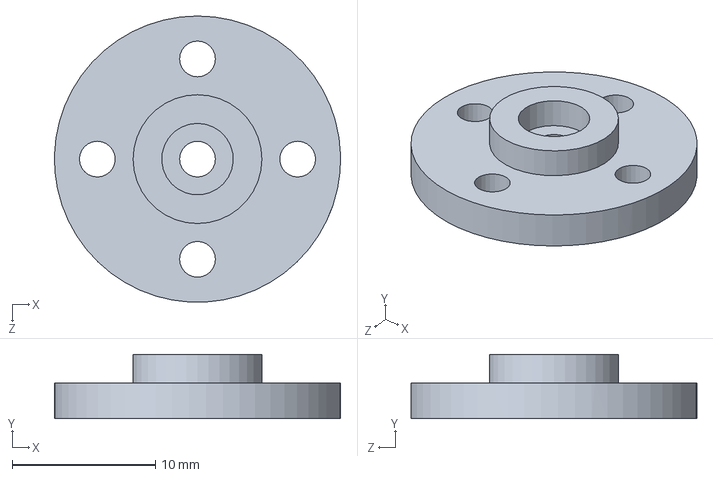
[picture p111: CAD file, 2026-11-08]
CAD library/Standard/Round Servo Horn.SLDPRT
20.0 x 4.50 x 20.0 mm
