TanzH1225/GrowTech-Wall-Handover/CAD library/FAB/Gantry GA/FGA001B.SLDPRT

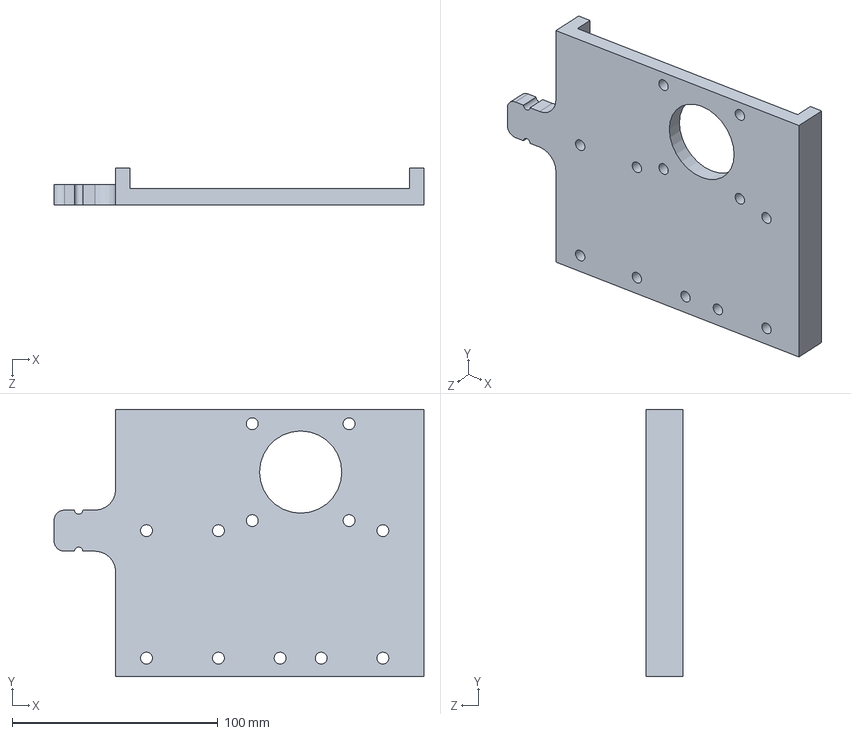
[picture p112: CAD file, 2026-11-08]
CAD library/FAB/Gantry GA/FGA001B.SLDPRT
180.0 x 130.0 x 18.0 mm
