TanzH1225/GrowTech-Wall-Handover/CAD library/FAB/Robotic Arm RA/FRA002B.SLDPRT

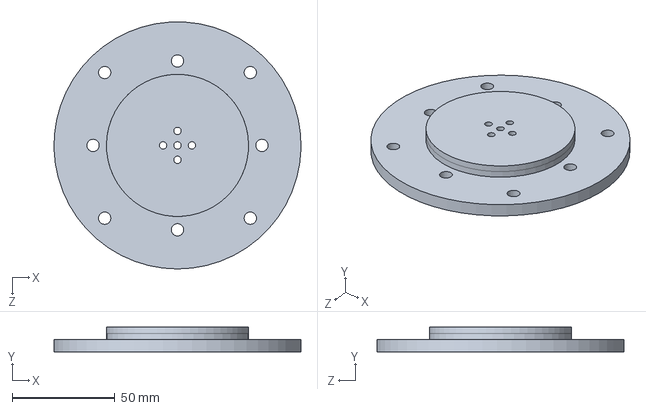
[picture p113: CAD file, 2026-11-08]
CAD library/FAB/Robotic Arm RA/FRA002B.SLDPRT
119.9 x 12.0 x 119.9 mm
