TanzH1225/GrowTech-Wall-Handover/CAD library/Standard/Quick Connector Spray Nozzle.SLDPRT

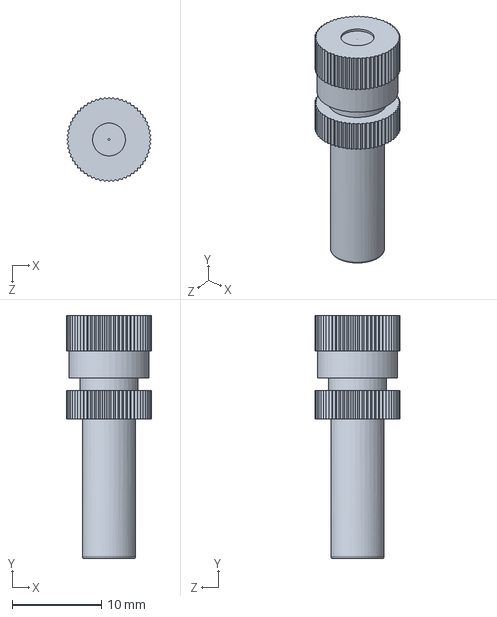
[picture p114: CAD file, 2026-11-08]
CAD library/Standard/Quick Connector Spray Nozzle.SLDPRT
9.50 x 27.3 x 9.50 mm
