TanzH1225/GrowTech-Wall-Handover/CAD library/FAB/Robotic Arm RA/FRA014A.SLDPRT

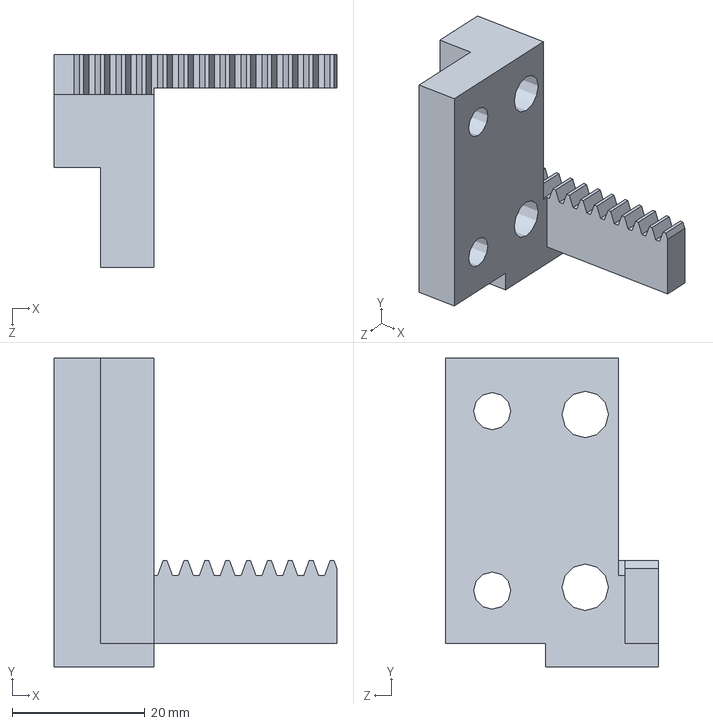
[picture p115: CAD file, 2026-11-08]
CAD library/FAB/Robotic Arm RA/FRA014A.SLDPRT
42.6 x 46.5 x 32.0 mm
