TanzH1225/GrowTech-Wall-Handover/CAD library/Standard/Suplin SPL-62.SLDPRT

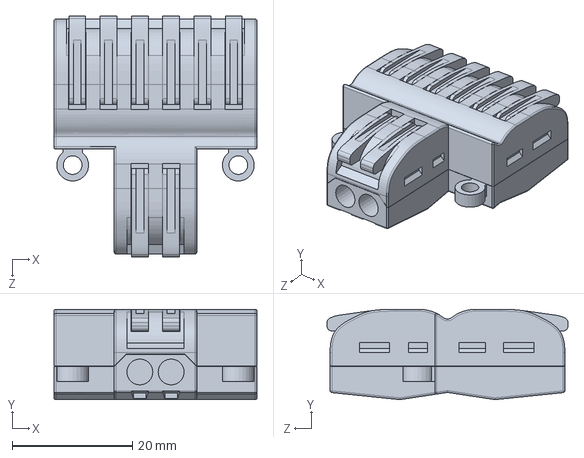
[picture p116: CAD file, 2026-11-08]
CAD library/Standard/Suplin SPL-62.SLDPRT
33.7 x 15.0 x 40.0 mm
