TanzH1225/GrowTech-Wall-Handover/CAD library/FAB/Gantry GA/FRAM001D.SLDPRT

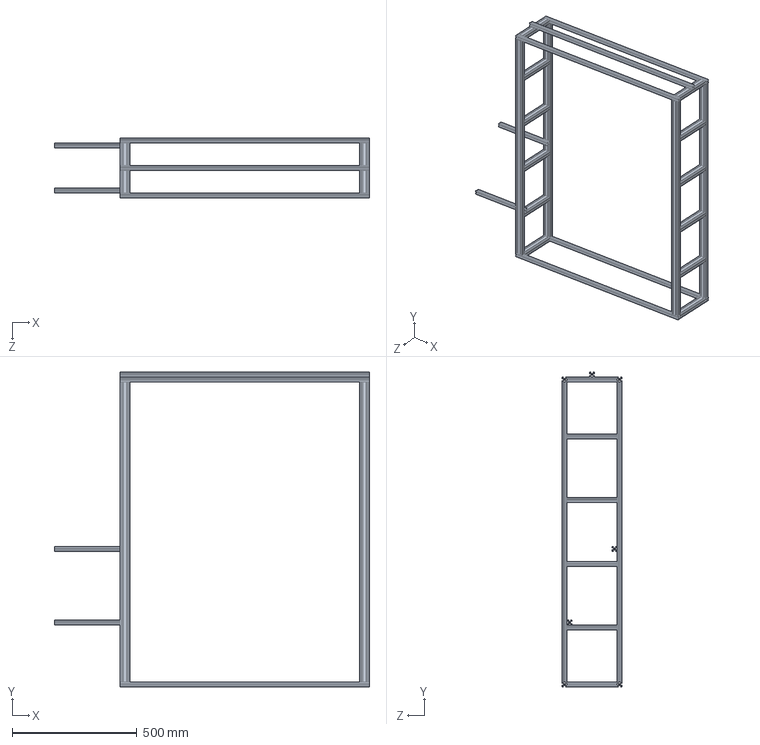
[picture p117: CAD file, 2026-11-08]
CAD library/FAB/Gantry GA/FRAM001D.SLDPRT
1261.5 x 1260.0 x 240.0 mm
