TanzH1225/GrowTech-Wall-Handover/CAD library/Standard/Water pump 12v.SLDPRT

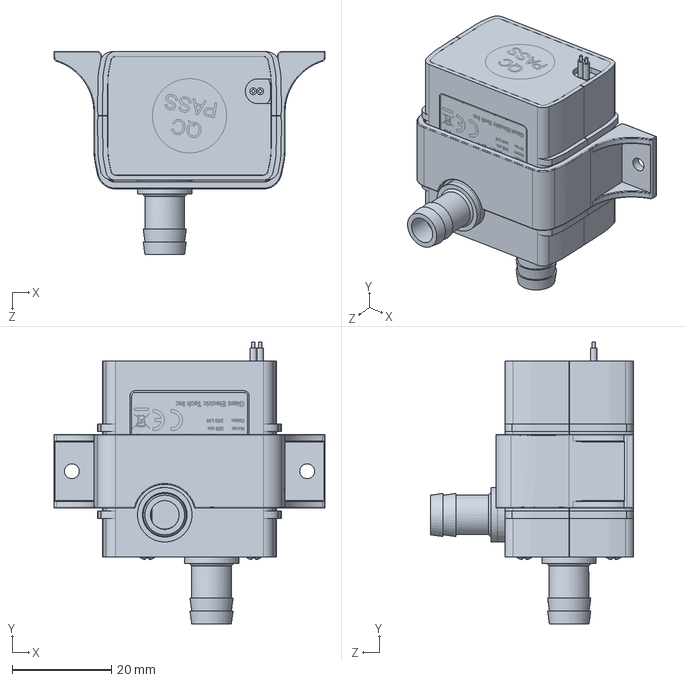
[picture p118: CAD file, 2026-11-08]
CAD library/Standard/Water pump 12v.SLDPRT
54.7 x 56.9 x 41.0 mm
