TanzH1225/GrowTech-Wall-Handover/CAD library/Standard/C920 Webcam.SLDPRT

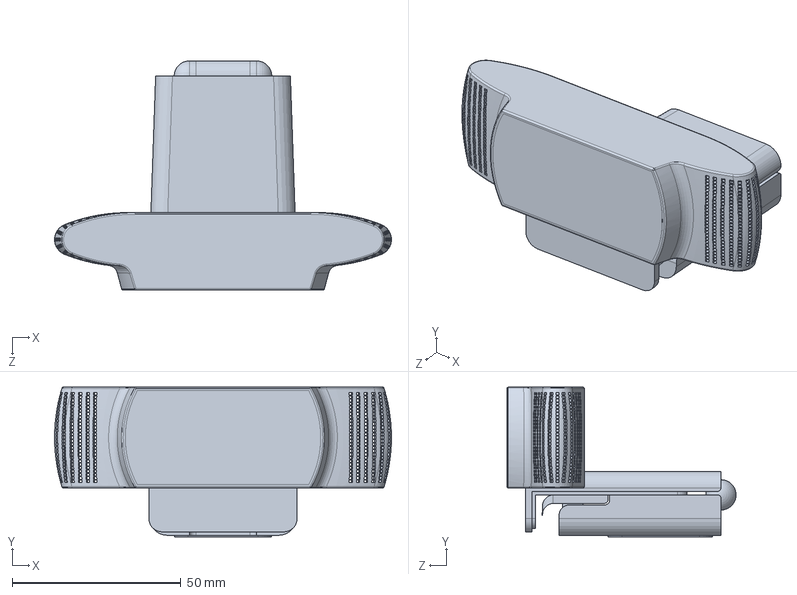
[picture p119: CAD file, 2026-11-08]
CAD library/Standard/C920 Webcam.SLDPRT
100.0 x 44.5 x 68.0 mm
