TanzH1225/GrowTech-Wall-Handover/CAD library/Standard/Water Tank.SLDPRT

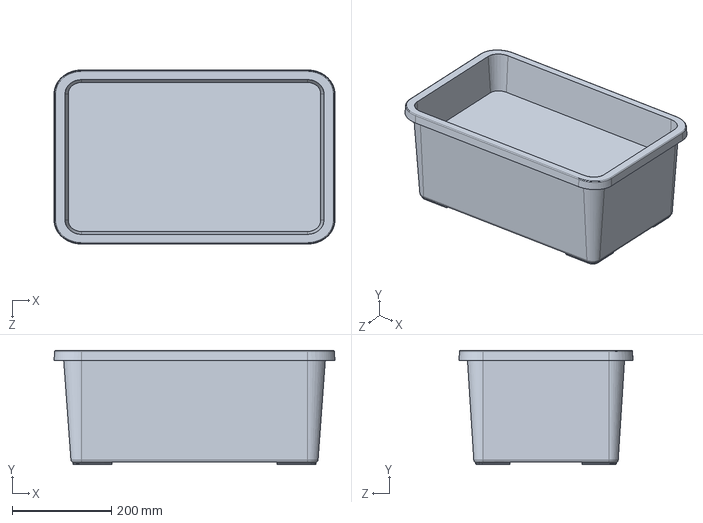
[picture p120: CAD file, 2026-11-08]
CAD library/Standard/Water Tank.SLDPRT
565.0 x 230.0 x 350.0 mm
