TanzH1225/GrowTech-Wall-Handover/CAD library/Standard/Thrust Bearing.SLDPRT

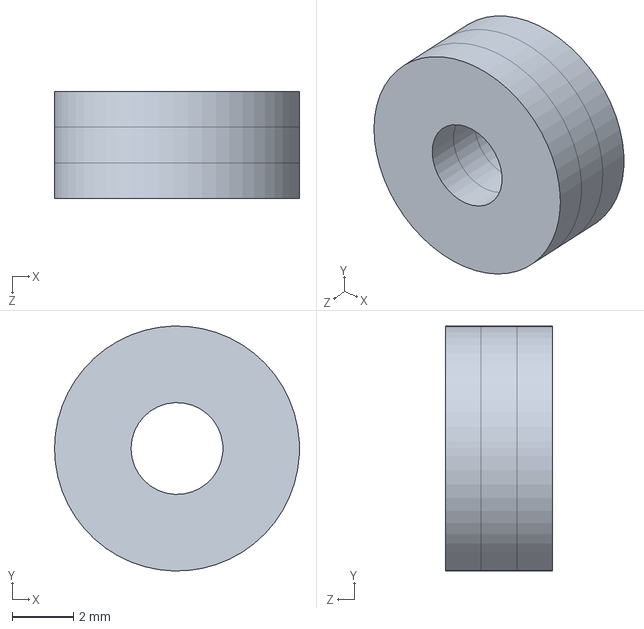
[picture p121: CAD file, 2026-11-08]
CAD library/Standard/Thrust Bearing.SLDPRT
8.00 x 8.00 x 3.50 mm
