TanzH1225/GrowTech-Wall-Handover/CAD library/Standard/peristaltic pump KPP from kamoer.SLDPRT

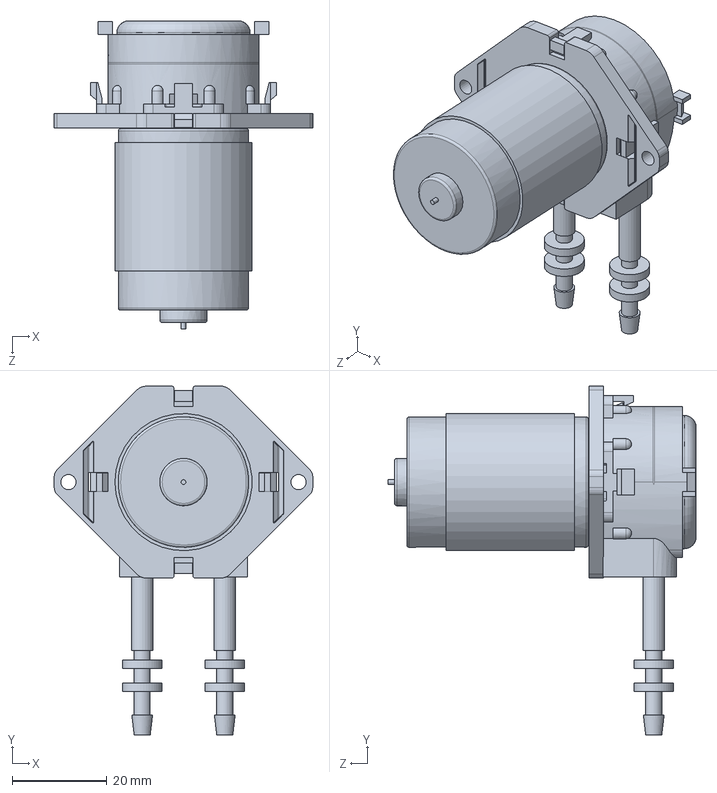
[picture p122: CAD file, 2026-11-08]
CAD library/Standard/peristaltic pump KPP from kamoer.SLDPRT
54.5 x 73.5 x 65.0 mm
