TanzH1225/GrowTech-Wall-Handover/CAD library/Standard/IDP basket.SLDPRT

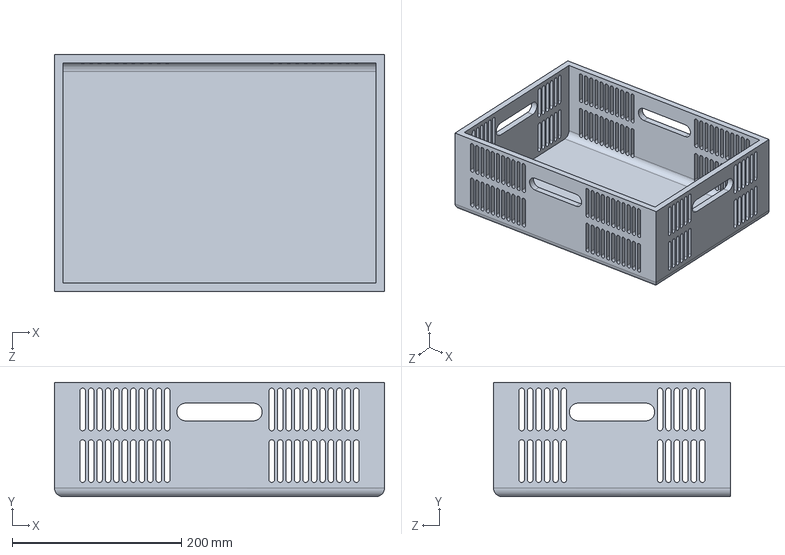
[picture p123: CAD file, 2026-11-08]
CAD library/Standard/IDP basket.SLDPRT
390.0 x 135.0 x 280.0 mm
