TanzH1225/GrowTech-Wall-Handover/CAD library/Standard/4ch optocoupler relay board.SLDPRT

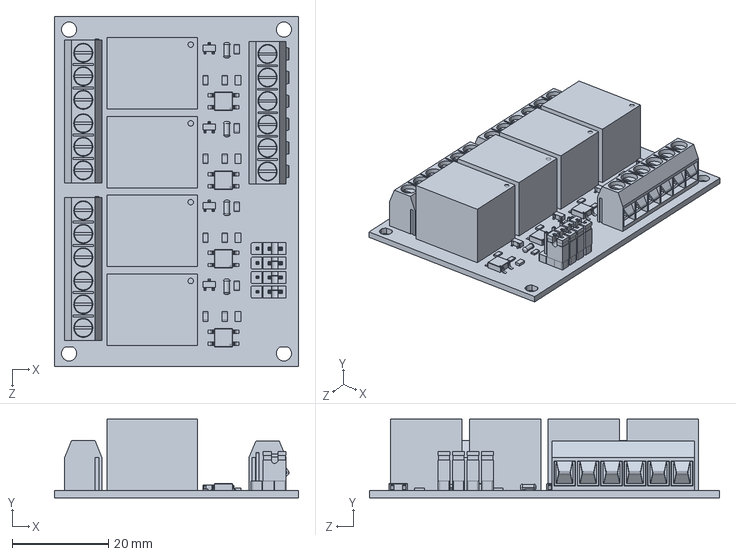
[picture p124: CAD file, 2026-11-08]
CAD library/Standard/4ch optocoupler relay board.SLDPRT
50.9 x 16.4 x 72.9 mm
