TanzH1225/GrowTech-Wall-Handover/CAD library/Standard/DP521 Water Pump.SLDPRT

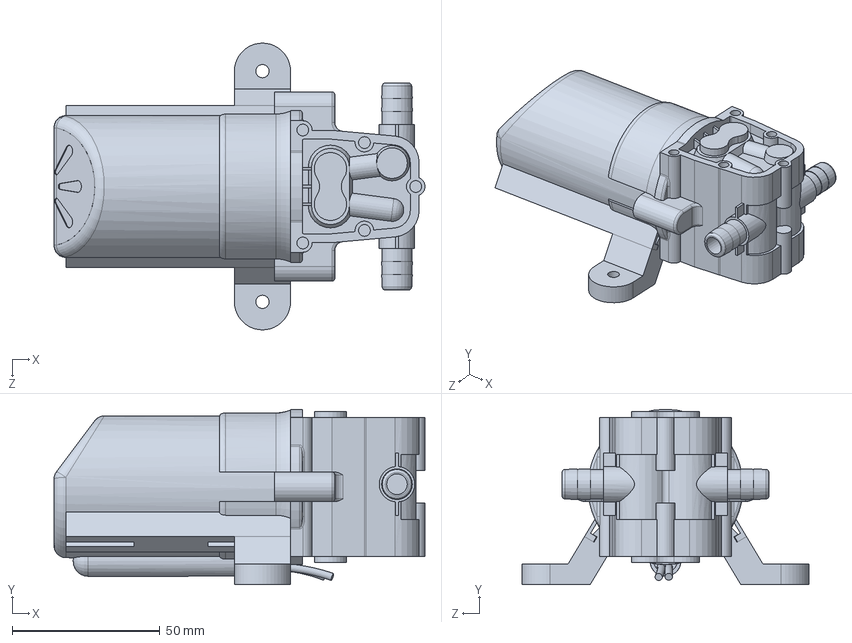
[picture p125: CAD file, 2026-11-08]
CAD library/Standard/DP521 Water Pump.SLDPRT
125.5 x 59.4 x 97.0 mm
