TanzH1225/GrowTech-Wall-Handover/CAD library/Standard/Piping.SLDPRT

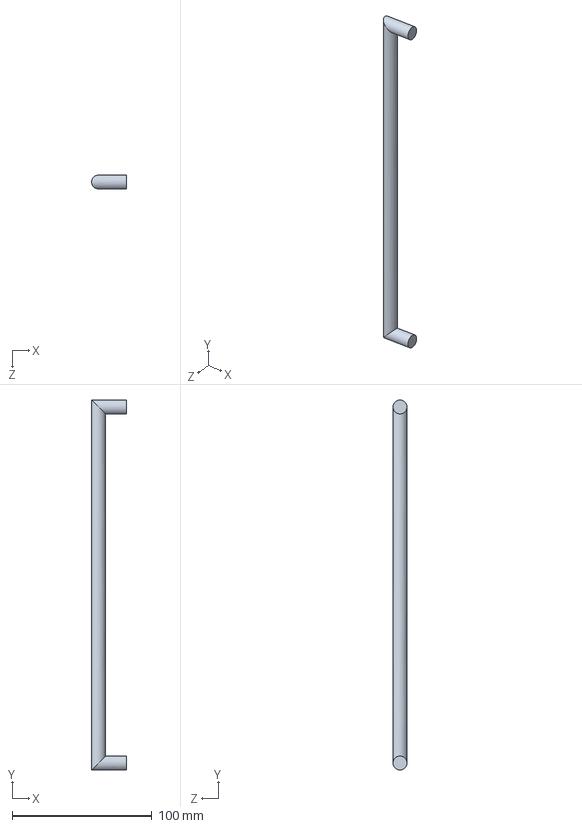
[picture p126: CAD file, 2026-11-08]
CAD library/Standard/Piping.SLDPRT
25.0 x 265.0 x 10.0 mm
