TanzH1225/GrowTech-Wall-Handover/CAD library/Standard/Mounting L Bracket.SLDPRT

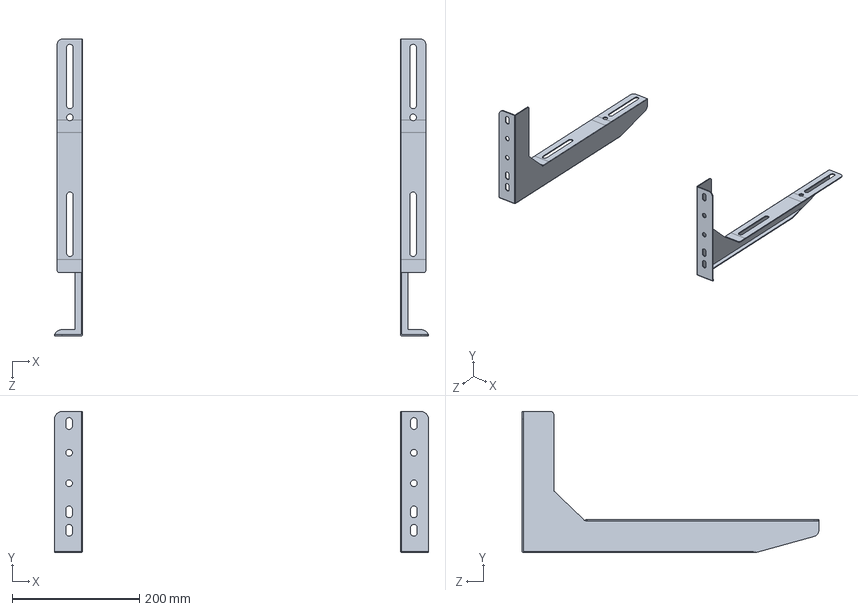
[picture p127: CAD file, 2026-11-08]
CAD library/Standard/Mounting L Bracket.SLDPRT
588.4 x 222.0 x 467.0 mm
