TanzH1225/GrowTech-Wall-Handover/CAD library/Standard/GT2 Timing Pulley.SLDPRT

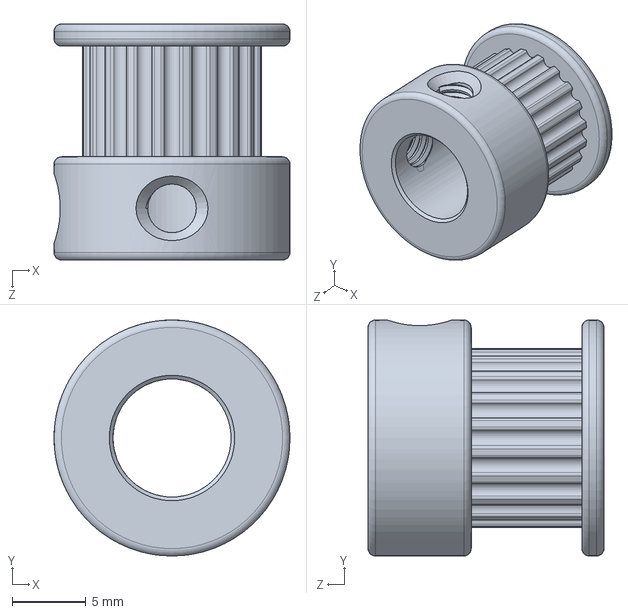
[picture p128: CAD file, 2026-11-08]
CAD library/Standard/GT2 Timing Pulley.SLDPRT
16.0 x 16.0 x 16.0 mm
