TanzH1225/GrowTech-Wall-Handover/CAD library/Standard/6mm pneumatic fittings.sldprt

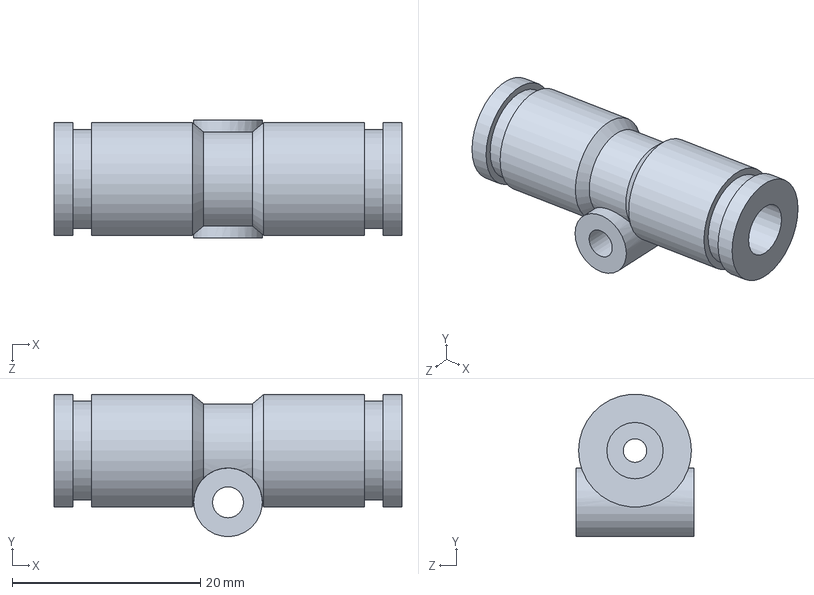
[picture p129: CAD file, 2026-11-08]
CAD library/Standard/6mm pneumatic fittings.sldprt
37.0 x 15.1 x 12.5 mm
