TanzH1225/GrowTech-Wall-Handover/CAD library/Standard/Walling.SLDPRT

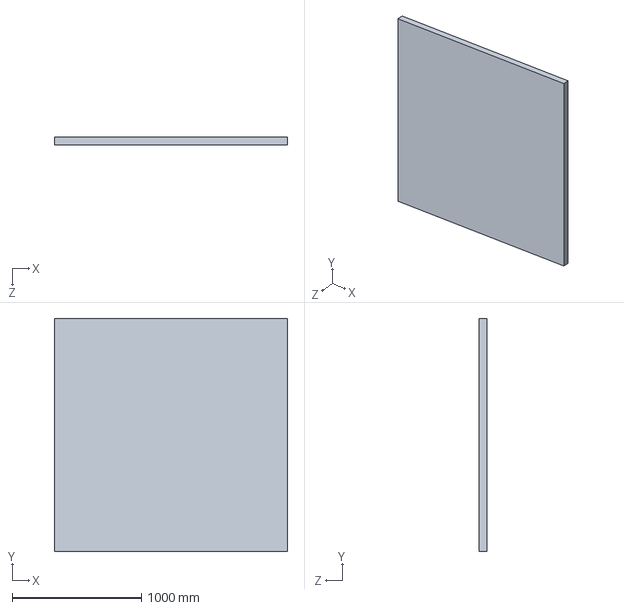
[picture p130: CAD file, 2026-11-08]
CAD library/Standard/Walling.SLDPRT
1800.0 x 1800.0 x 60.0 mm
