TanzH1225/GrowTech-Wall-Handover/CAD library/Standard/p  BEARING, METRIC 600 MINIATURE SERIES, DOUBLE-SHIELDED  3mm ID × 9 OD × 3 W  —  603-ZZ.SLDPRT

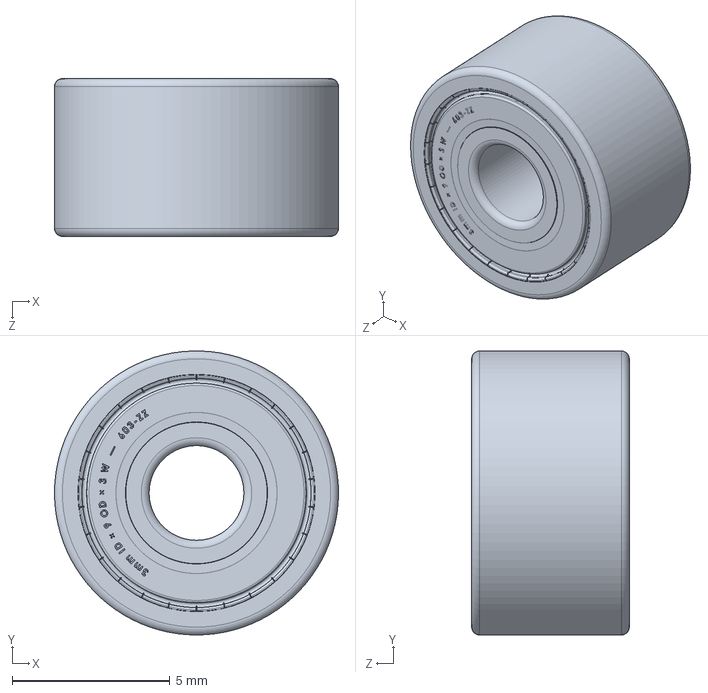
[picture p131: CAD file, 2026-11-08]
CAD library/Standard/p BEARING, METRIC 600 MINIATURE SERIES, DOUBLE-SHIELDED 3mm ID × 9 OD × 3 W — 603-ZZ.SLDPRT
9.00 x 9.00 x 5.00 mm
