TanzH1225/GrowTech-Wall-Handover/CAD library/Standard/SERVO ARM HORN 25T ALUMINIUM.SLDPRT

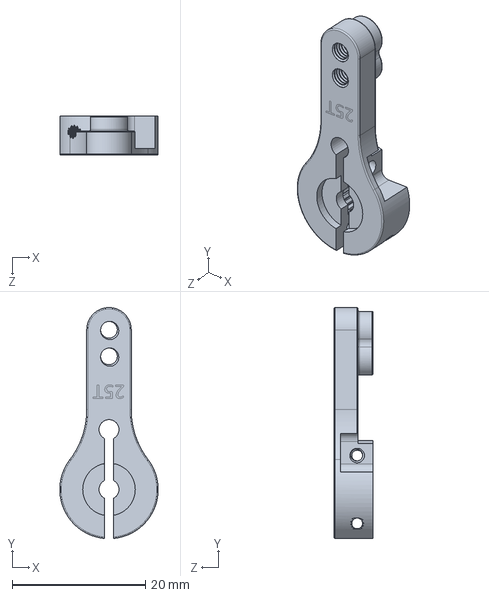
[picture p132: CAD file, 2026-11-08]
CAD library/Standard/SERVO ARM HORN 25T ALUMINIUM.SLDPRT
14.8 x 34.7 x 5.90 mm
