TanzH1225/GrowTech-Wall-Handover/CAD library/Standard/Omron V-155-1C25_MircoSwitch.SLDPRT

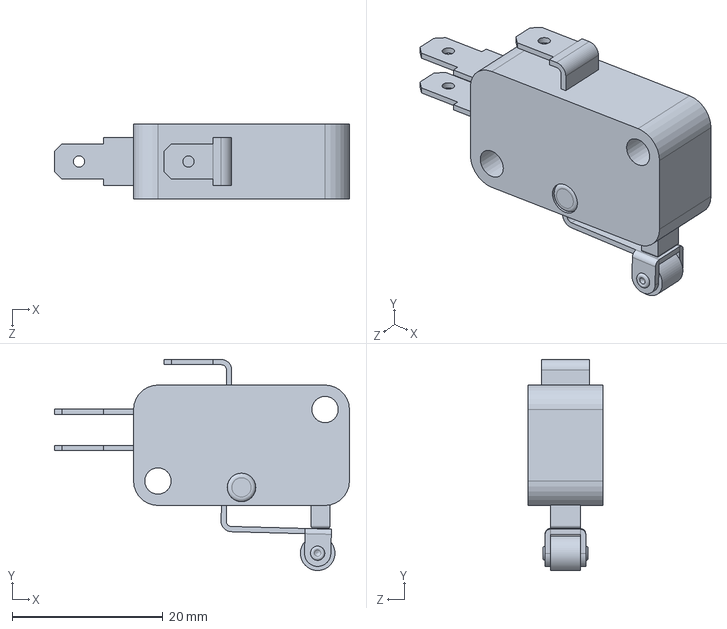
[picture p133: CAD file, 2026-11-08]
CAD library/Standard/Omron V-155-1C25_MircoSwitch.SLDPRT
39.2 x 28.0 x 10.0 mm
