TanzH1225/GrowTech-Wall-Handover/CAD library/Assembly/GTW006B.SLDASM

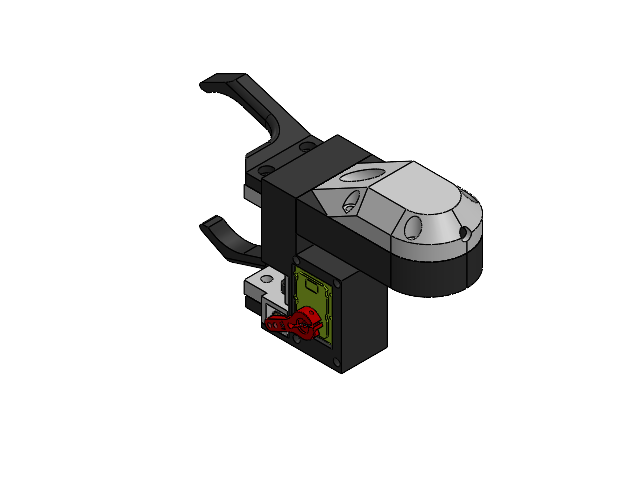
[picture p134: CAD file, 2026-11-08]
CAD library/Assembly/GTW006B.SLDASM
0_DS-LH8A_stp(2)
SERVO ARM HORN 25T ALUMINIUM
FRA010A
p BEARING, METRIC 600 MINIATURE SERIES, DOUBLE-SHIELDED 3mm ID × 9 OD × 3 W — 603-ZZ
3mmX80mm shaft x 2
Thrust Bearing
FRA013A
FRA014A
Lineare_bearing_LM3UU
FRA015B
FRA018C
FRA017C
