TanzH1225/GrowTech-Wall-Handover/CAD library/Standard/HX-35HM/HX-35HM三维图纸/HX-35HM.SLDASM

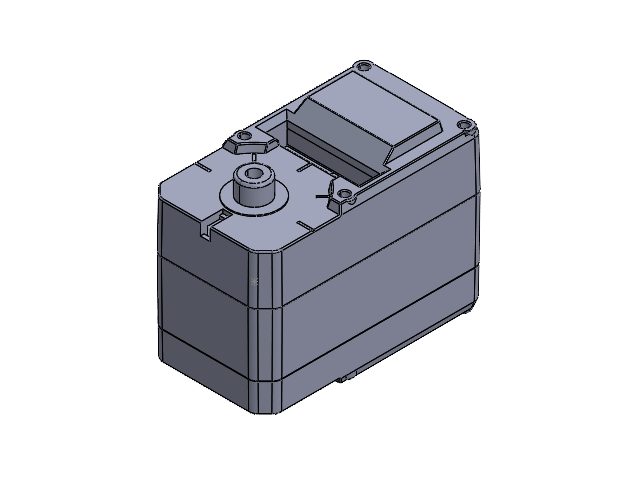
[picture p135: CAD file, 2026-11-08]
CAD library/Standard/HX-35HM/HX-35HM三维图纸/HX-35HM.SLDASM
brep_1_1.stp
brep_2_1.stp
brep_3_1.stp
brep_4_1.stp
brep_9_1.stp
brep_10_1.stp
brep_11_1.stp
brep_12_1.stp
brep_13_1.stp
brep_14_1.stp
brep_15_1.stp
brep_16_1.stp
brep_17_1.stp
brep_18_1.stp
brep_19_1.stp
brep_20_1.stp
