TanzH1225/GrowTech-Wall-Handover/CAD library/Assembly/GTW002B.SLDASM

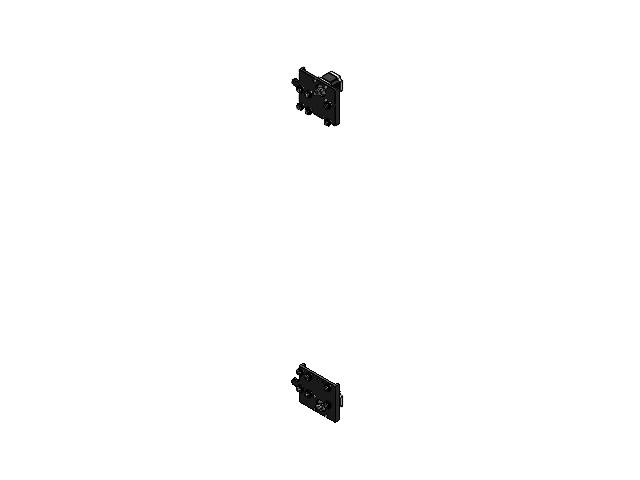
[picture p136: CAD file, 2026-11-08]
CAD library/Assembly/GTW002B.SLDASM
FGA001B
Solid V Wheel x 12
Ball Bearing 5 x 16 x 5 x 24
Precision Shim 10 x 5 x 1 x 12
Nylon Insert Lock Nut M5 x 12
476745 - Nema 23 Shaft End Plate x 2
476746 - Nema 23 End Plate x 2
476747 - Nema 23 Motor Body x 2
476748 - Nema 23 Armature x 2
Aluminium Round Spacer x 12
socket head cap screw_am x 20
hex nut style 1_am x 8
GT2 Timing Pulley x 2
FGA001C
