TanzH1225/GrowTech-Wall-Handover/CAD library/Standard/nema-23-57bygh56-401a-1.snapshot.4/Nema 23 - 57BYGH56-401A.SLDASM

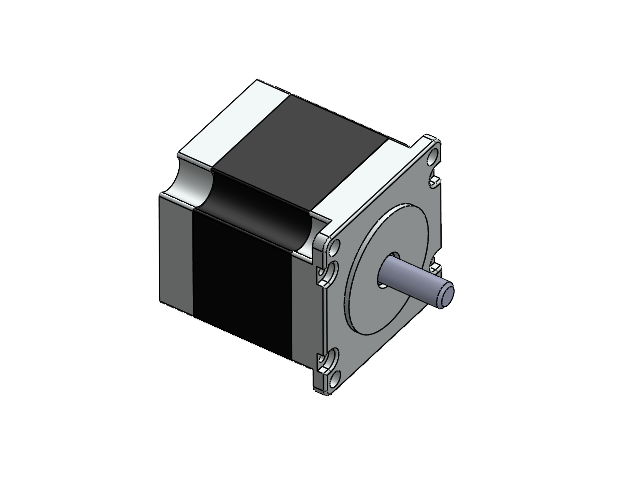
[picture p137: CAD file, 2026-11-08]
CAD library/Standard/nema-23-57bygh56-401a-1.snapshot.4/Nema 23 - 57BYGH56-401A.SLDASM
476745 - Nema 23 Shaft End Plate
476746 - Nema 23 End Plate
476747 - Nema 23 Motor Body
476748 - Nema 23 Armature
