TanzH1225/GrowTech-Wall-Handover/CAD library/Assembly/GTW001E.SLDASM

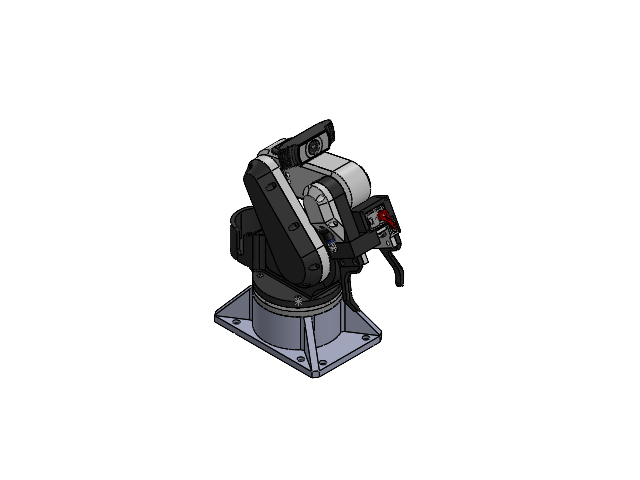
[picture p138: CAD file, 2026-11-08]
CAD library/Assembly/GTW001E.SLDASM
Outer
Inner
240 Servo Motor HTS-35H x 3
brep_1_1.stp
brep_2_1.stp
brep_3_1.stp
brep_4_1.stp
brep_9_1.stp
brep_10_1.stp
brep_11_1.stp
brep_12_1.stp
brep_13_1.stp
brep_14_1.stp
brep_15_1.stp
brep_16_1.stp
brep_17_1.stp
brep_18_1.stp
brep_19_1.stp
brep_20_1.stp
Round Servo Horn
SERVO ARM HORN 25T ALUMINIUM x 4
Water pump 12v
6mm pneumatic fittings
Quick Connector Spray Nozzle
C920 Webcam
FRA001B
FRA002B
FRA003C
FRA004B
FRA005D
socket head cap screw_am x 5
0_DS-LH8A_stp(2)
FRA010A
p BEARING, METRIC 600 MINIATURE SERIES, DOUBLE-SHIELDED 3mm ID × 9 OD × 3 W — 603-ZZ
3mmX80mm shaft x 2
Thrust Bearing
FRA013A
FRA014A
Lineare_bearing_LM3UU
FRA015B
FRA018C
FRA017C
socket countersunk head screw_am x 8
