TanzH1225/GrowTech-Wall-Handover/CAD library/Standard/LBSBL6-2028-SET Profile L Bracket/LBSBL6-2028-SET.sldasm

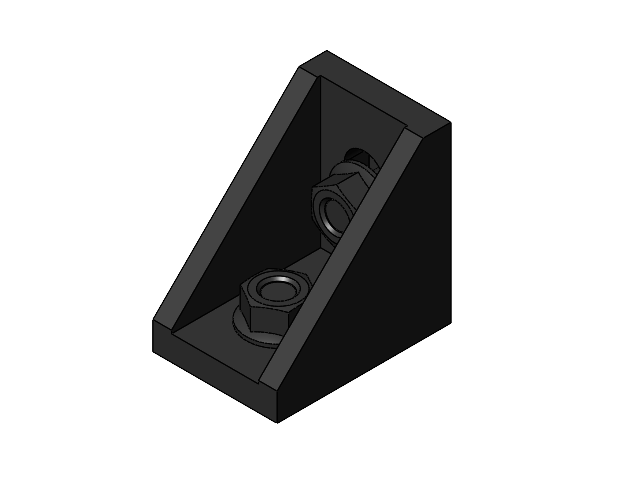
[picture p139: CAD file, 2026-11-08]
CAD library/Standard/LBSBL6-2028-SET Profile L Bracket/LBSBL6-2028-SET.sldasm
LBSBL6-2028-SET_b
LNCFM5-100P x 2
LTTB6-5-10 x 2
