TanzH1225/GrowTech-Wall-Handover/CAD library/Assembly/GTW001A.SLDASM

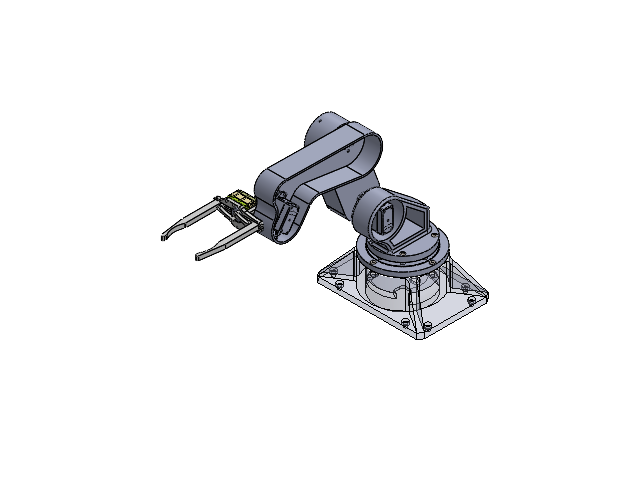
[picture p140: CAD file, 2026-11-08]
CAD library/Assembly/GTW001A.SLDASM
Outer
Inner
FRA001A
FRA002A
FRA003A
ZK_1.STEP x 3
DG-SZ.STEP x 3
GE.STEP x 3
SG-JIANRONG-MG996_1.STEP x 3
brep_1_1.stp
brep_2_1.stp
brep_3_1.stp
brep_4_1.stp
brep_9_1.stp
brep_10_1.stp
brep_11_1.stp
brep_12_1.stp
brep_13_1.stp
brep_14_1.stp
brep_15_1.stp
brep_16_1.stp
brep_17_1.stp
brep_18_1.stp
brep_19_1.stp
brep_20_1.stp
Round Servo Horn x 4
FRA004A
FRA005A
FRA006A
FRA007A
FRA008A
FRA009A x 2
PCBA_id6_x_t.stp
PCBA_id11_x_t.stp
Connector.stp x 2
Housing_A.stp
Horn_B.stp
Bearing.stp
Motor_N20.stp
Housing_C.stp
Housing_B.stp
301-S022A030005-00.stp
Bearing (MR106).stp x 2
M3.0XL4.0.stp
Screw_2.stp x 4
SERVO ARM HORN 25T ALUMINIUM
socket head cap screw_am x 4
socket countersunk head screw_am x 8
