TanzH1225/GrowTech-Wall-Handover/CAD library/Assembly/GTW003C.SLDASM

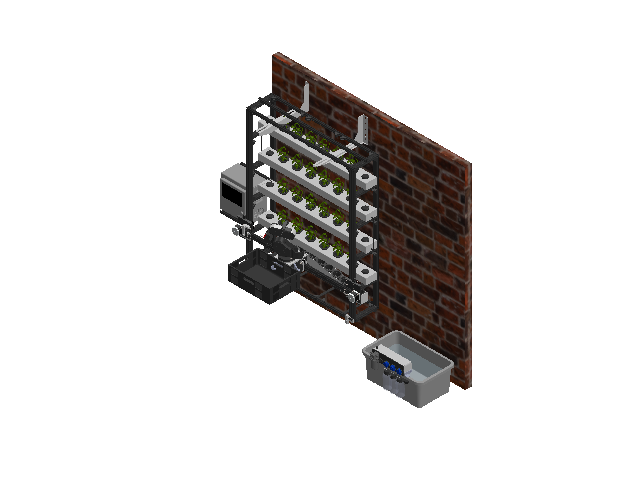
[picture p141: CAD file, 2026-11-08]
CAD library/Assembly/GTW003C.SLDASM
socket head cap screw_am x 48
hex nut style 1_am x 26
Hydroponic Channel 1 Meter x 4
Hydroponic Channel End Cap x 8
IDP hydroponics netpot x 34
FHA002A x 34
Planting x 24
FHA012A x 8
LBSBL6-2028-SET_b x 96
LNCFM5-100P x 192
LTTB6-5-10 x 192
Omron V-155-1C25_MircoSwitch x 3
FRAM001D
FGA002A
FGA004A x 3
Outer
Inner
240 Servo Motor HTS-35H x 3
brep_1_1.stp
brep_2_1.stp
brep_3_1.stp
brep_4_1.stp
brep_5_1.stp
brep_6_1.stp
brep_7_1.stp
brep_8_1.stp
brep_9_1.stp
brep_10_1.stp
brep_11_1.stp
brep_12_1.stp
brep_13_1.stp
brep_14_1.stp
brep_15_1.stp
brep_16_1.stp
brep_17_1.stp
brep_18_1.stp
brep_19_1.stp
brep_20_1.stp
Round Servo Horn
SERVO ARM HORN 25T ALUMINIUM x 4
Water pump 12v
6mm pneumatic fittings
Quick Connector Spray Nozzle
C920 Webcam
FRA001B
FRA002B
FRA003C
FRA004B
FRA005D
0_DS-LH8A_stp(2)
FRA010A
p BEARING, METRIC 600 MINIATURE SERIES, DOUBLE-SHIELDED 3mm ID × 9 OD × 3 W — 603-ZZ
3mmX80mm shaft x 2
Thrust Bearing
FRA013A
FRA014A
Lineare_bearing_LM3UU
FRA015B
FRA018C
FRA017C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
