TanzH1225/GrowTech-Wall-Handover/CAD library/Assembly/GTW007A.SLDASM

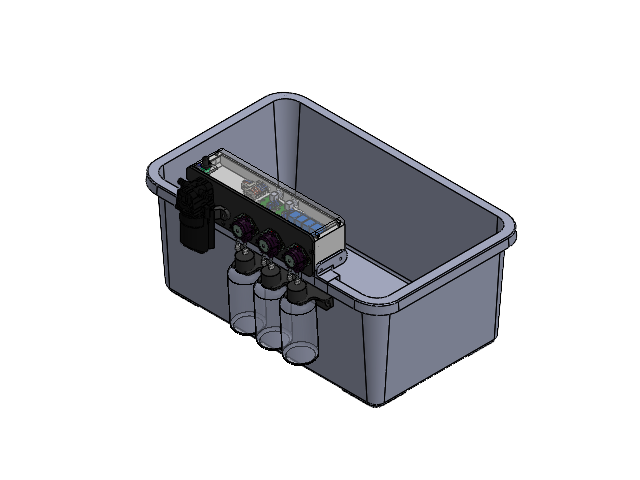
[picture p142: CAD file, 2026-11-08]
CAD library/Assembly/GTW007A.SLDASM
Water Tank
peristaltic pump KPP from kamoer x 3
4ch optocoupler relay board
DP521 Water Pump
PH-4502C x 2
PWM Controller
Suplin SPL-62
FHA004A
250ml Bottle x 3
Water Level Sensor
FHA008A
FHA009A
FHA005A
