TanzH1225/GrowTech-Wall-Handover/(list of files, cad)

Other CAD files:
CAD library/Standard/LBSBL6-2028-SET Profile L Bracket/LNCFM5-100P.sldprt
CAD library/Standard/LBSBL6-2028-SET Profile L Bracket/LBSBL6-2028-SET_b.sldprt
CAD library/FAB/Robotic Arm RA/FRA017C.SLDPRT
CAD library/Standard/LBSBL6-2028-SET Profile L Bracket/LTTB6-5-10.sldprt
CAD library/FAB/Gantry GA/FGA001C.SLDPRT
CAD library/FAB/Gantry GA/FGA021B.SLDPRT
CAD library/FAB/Electronics Box EB/STL/EB002A.3mf
CAD library/FAB/Electronics Box EB/STL/EB002A.STL
CAD library/FAB/Electronics Box EB/STL/EB003A.STL
CAD library/FAB/Electronics Box EB/STL/EB004A.STL
CAD library/FAB/Electronics Box EB/STL/EB005A.STL
CAD library/FAB/Electronics Box EB/STL/EB006A.STL
CAD library/FAB/Electronics Box EB/STL/EB007A.3mf
CAD library/FAB/Electronics Box EB/STL/EB007A.STL
CAD library/Standard/SW2014 Parts Library 1.6/7 - Hardware/Nylon Insert Lock Nut M5.SLDPRT
CAD library/Standard/nema-23-57bygh56-401a-1.snapshot.4/476745 - Nema 23 Shaft End Plate.SLDPRT
CAD library/Standard/nema-23-57bygh56-401a-1.snapshot.4/476746 - Nema 23 End Plate.SLDPRT
CAD library/Standard/nema-23-57bygh56-401a-1.snapshot.4/476747 - Nema 23 Motor Body.SLDPRT
CAD library/Standard/nema-23-57bygh56-401a-1.snapshot.4/476748 - Nema 23 Armature.SLDPRT
