TanzH1225/GrowTech-Wall-Handover/documentation/programming/reference/media-guide.md

# Programming media guide

Original files were copied unchanged. Report screenshots show the report-era interface; displayed readings and status labels are examples, not current operating values or fresh test evidence.

## prototype-overview.jpg

[Original report Figure 3.2](../media/prototype-overview.jpg)

## controller-enclosure.jpg

[Owner enclosure photograph](../media/controller-enclosure.jpg)

## arm-and-cables.jpg

[Owner arm photograph](../media/arm-and-cables.jpg)

## dashboard.png

[Original report Figure 3.27](../media/dashboard.png)

## gantry-arm-interface.png

[Original report Figure 3.28](../media/gantry-arm-interface.png)

## hydroponics-interface.png

[Original report Figure 3.29](../media/hydroponics-interface.png)

## vision-interface.png

[Original report Figure 3.30](../media/vision-interface.png)

## example-detections.jpg

[Original report Figure 3.42](../media/example-detections.jpg)
