TanzH1225/GrowTech-Wall-Handover/documentation/Manufacturer references/controller-interface-excerpt.png

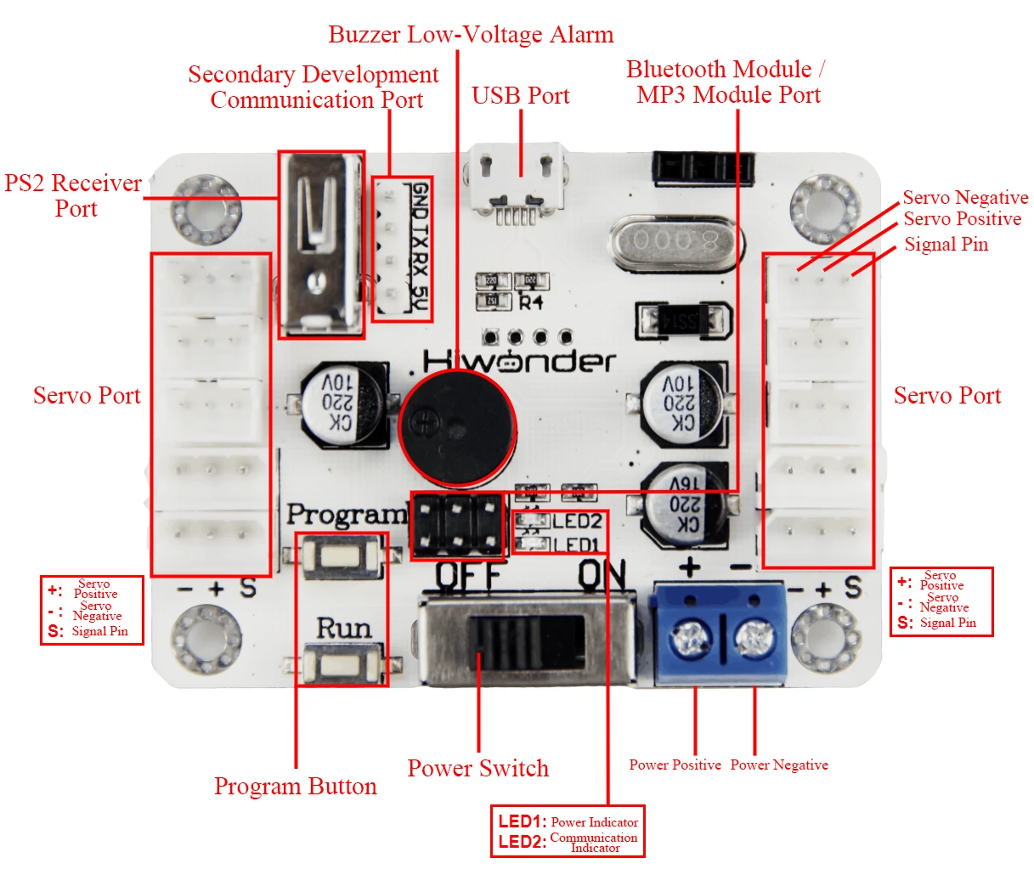
documentation/Manufacturer references/controller-interface-excerpt.png
