TanzH1225/GrowTech-Wall-Handover/documentation/Manufacturer references/controller-official-figure-1.webp

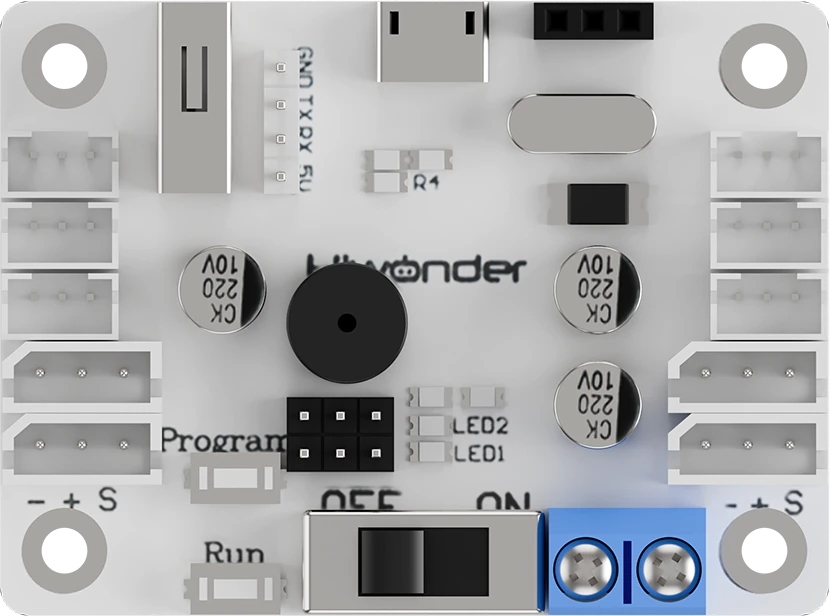
documentation/Manufacturer references/controller-official-figure-1.webp
