TanzH1225/GrowTech-Wall-Handover/documentation/Manufacturer references/dm542e-control-interface-excerpt.png

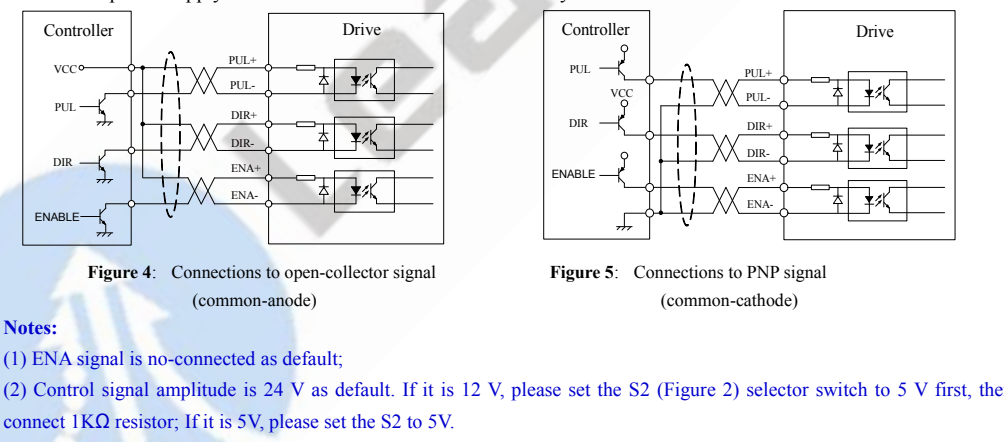
documentation/Manufacturer references/dm542e-control-interface-excerpt.png
