TanzH1225/GrowTech-Wall-Handover/documentation/Manufacturer references/dm542e-current-table-excerpt.png

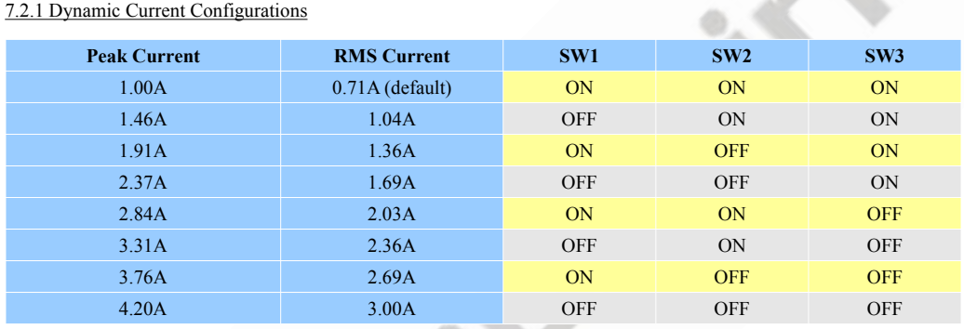
documentation/Manufacturer references/dm542e-current-table-excerpt.png
