TanzH1225/GrowTech-Wall-Handover/documentation/Manufacturer references/dm542e-page-7.png

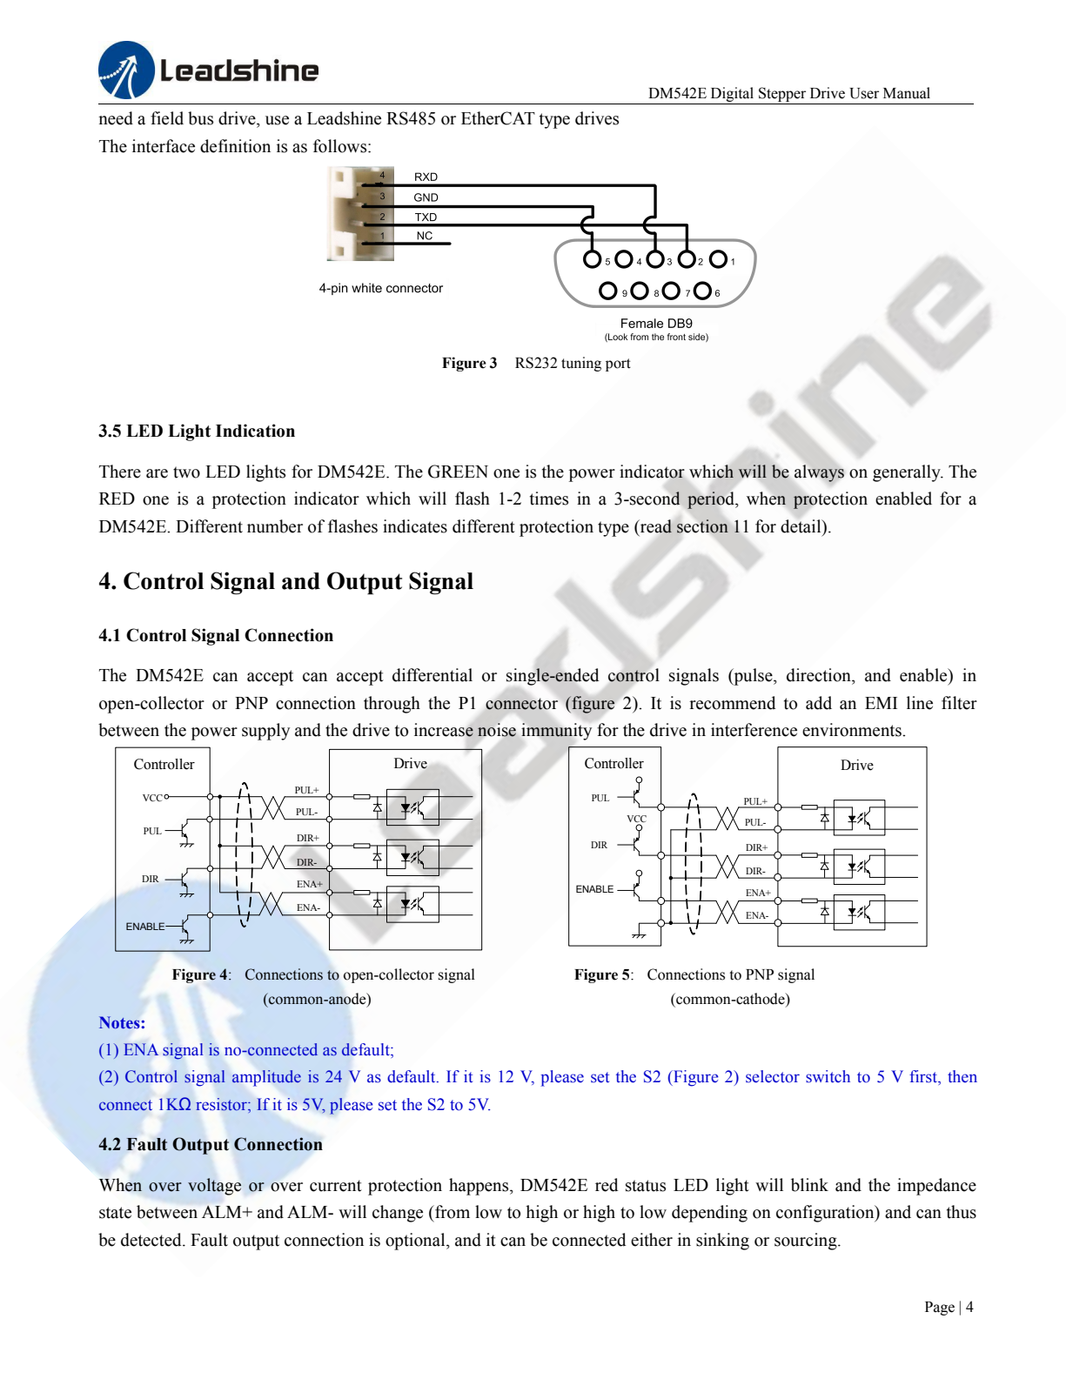
documentation/Manufacturer references/dm542e-page-7.png
