TanzH1225/GrowTech-Wall-Handover/documentation/Manufacturer references/dm542e-page-10.png

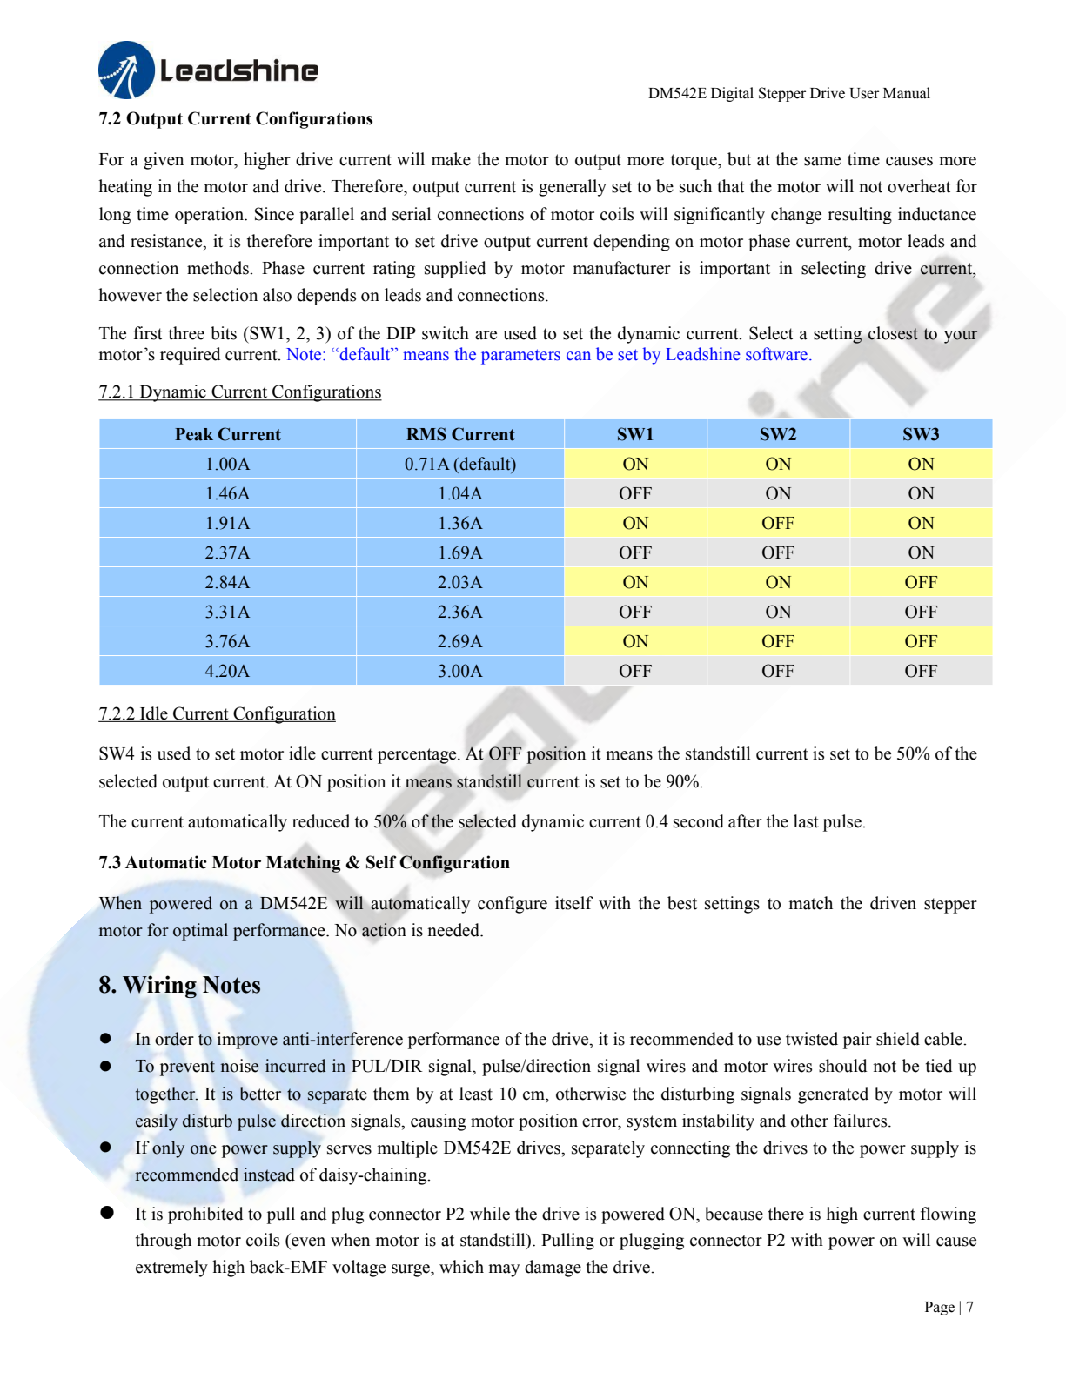
documentation/Manufacturer references/dm542e-page-10.png
