TanzH1225/GrowTech-Wall-Handover/documentation/Manufacturer references/hts35-manufacturer-parameters.jpg

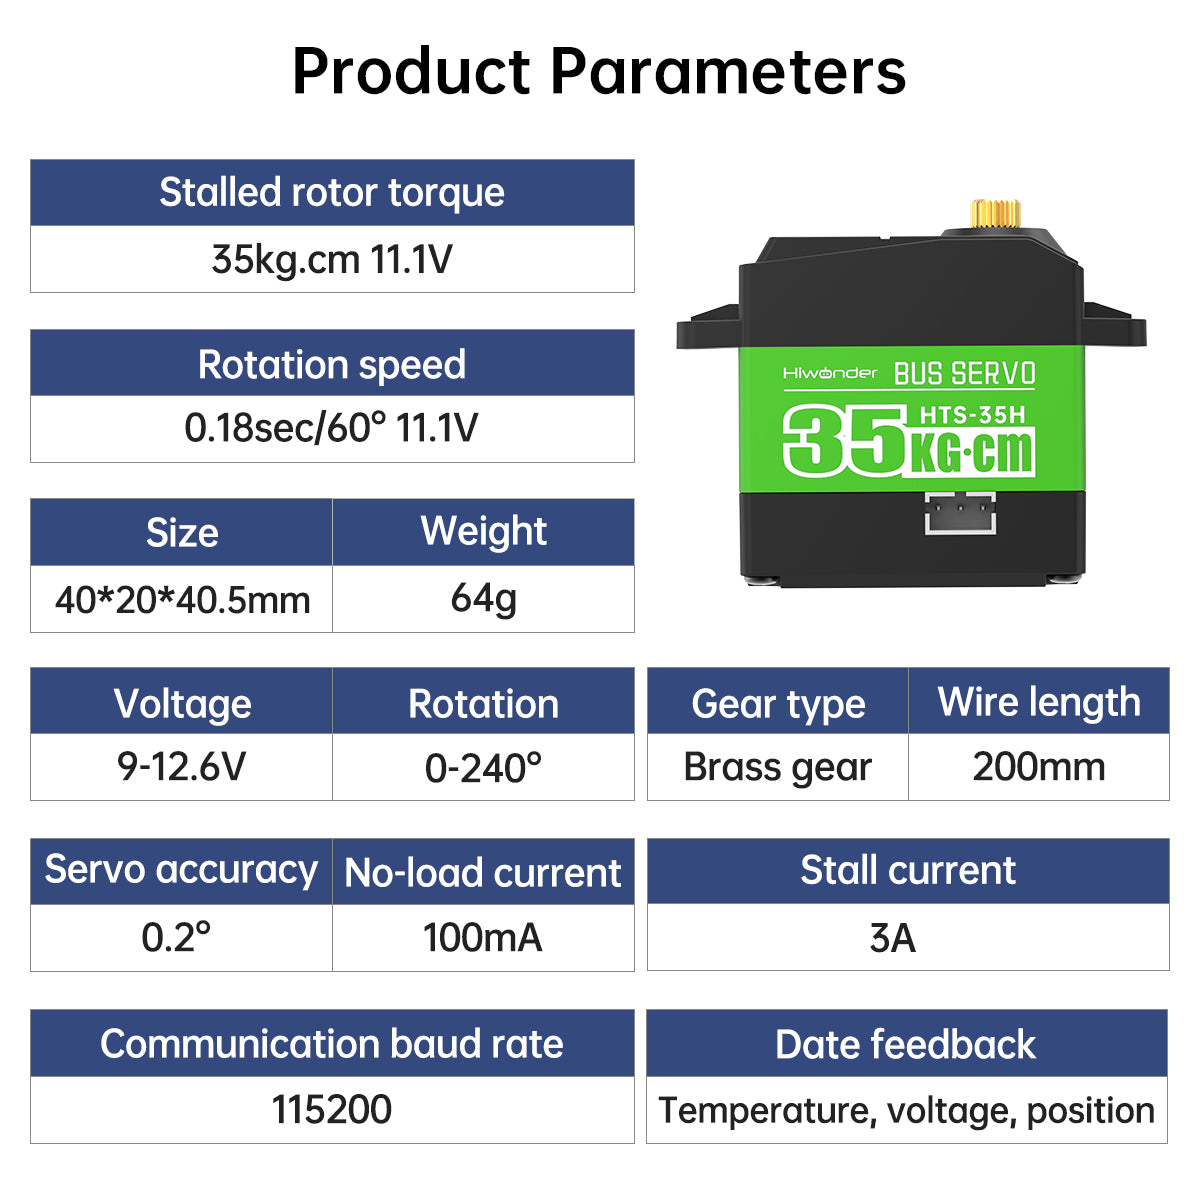
documentation/Manufacturer references/hts35-manufacturer-parameters.jpg
