TanzH1225/GrowTech-Wall-Handover/documentation/Manufacturer references/wheeltec-official-product.jpg

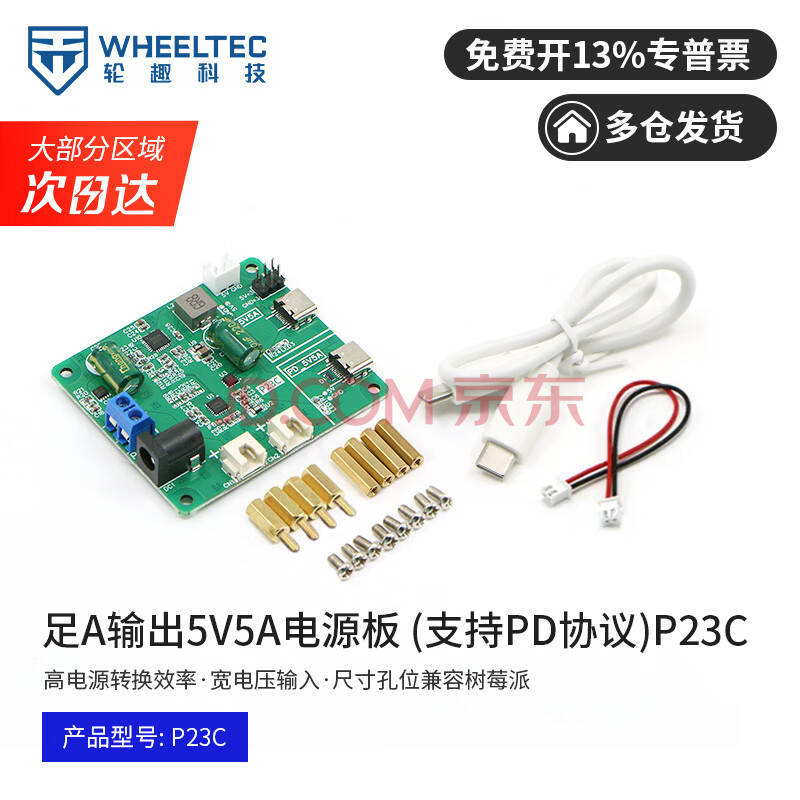
documentation/Manufacturer references/wheeltec-official-product.jpg
