TanzH1225/GrowTech-Wall-Handover/documentation/programming/reference/prototype-test-confirmation.md

# Operator prototype test confirmation

## Report received

On 2026-10-09, the project owner reported that the `refactor/gui-architecture` branch worked on the prototype. When asked whether both updated Nano firmware versions were uploaded and which functions were tested, the owner confirmed: "yeap both, all ok".

This records an **operator-reported successful prototype test** of the branch and both updated Nano firmware versions. It is physical-use evidence supplied by the owner, distinct from this assistant's source inspection and mock-only checks. The report should not be described as merely a laptop simulation.

## Record limits

The test date, exact tested commit, Pi/controller identities, flashed artifact hashes, hardware setup, individual test procedures, expected/observed results, and fault-test coverage were not specified. Do not infer that every documented fault or safety scenario was tested. The report was received while repository HEAD was `f6d8c6003382ca38fc7969202015d7ee22dfce84`; that is the reporting-session baseline, not a confirmed tested revision.

The [programming handover](../README.html) records source behavior and desk verification at that baseline. Its statements that no hardware was accessed during the handover refer to the assistant's documentation task, not to the owner's separate prototype test. Historical statements about pending validation must now be read alongside this report.

Before claiming a specific change is **hardware-validated future work**, complete the physical record required by [AGENTS.md](Repository-guidance.html): hardware state, procedure, expected result, observed result, date and operator, with the software/firmware revision identified. Existing source differences remain documented maintenance facts; this report does not by itself prove they caused a failure or validate each fault response.

## Delivery boundary

The current commit preparation backs up documentation and explanatory source comments on `refactor/gui-architecture`. It does not upload firmware, change the Pi startup contract, rename code directories, or merge into `main`. Newcomer-facing wording cleanup and the Word handbook remain planned work under the Word handover master prompt.
