TanzH1225/GrowTech-Wall-Handover/(commit log)

2026-11-08 Finalize CAD access links and snapshot inventory
2026-11-08 Include native CAD directly in the clone, excluding Pack and Go ZIP
2026-11-08 Remind readers to clone the CAD folders together
